VladimirGaristov/ROBKO_01-STM32/Documents/ROBKO-01_Thesis/documents/cover.pdf

Технологично Училище "Електронни Системи" към Технически Университет - София

Управление на български робот РОБКО 01 с ARM-базиран
микроконтролер STM32L476RG и отдалечен достъп през интернет

Владимир Гаристов
