VladimirGaristov/ROBKO_01-STM32/Documents/ROBKO-01_Thesis/documents/title_page.pdf

ТЕХНОЛОГИЧНО УЧИЛИЩЕ ЕЛЕКТРОННИ СИСТЕМИ към ТЕХНИЧЕСКИ УНИВЕРСИТЕТ - СОФИЯ

## Д И П Л О М Н А Р А Б О Т А

Тема: Управление на български робот РОБКО 01 с ARM-базиран микроконтролер STM32L476RG и отдалечен достъп през интернет

Дипломант: | Научен ръководител:
Владимир Гаристов | маг. инж. Росен Витанов

С О Ф И Я

2 0 1 8
