VladimirGaristov/ROBKO_01-STM32/Hardware/Documents/Connectors/Screw Terminals.pdf

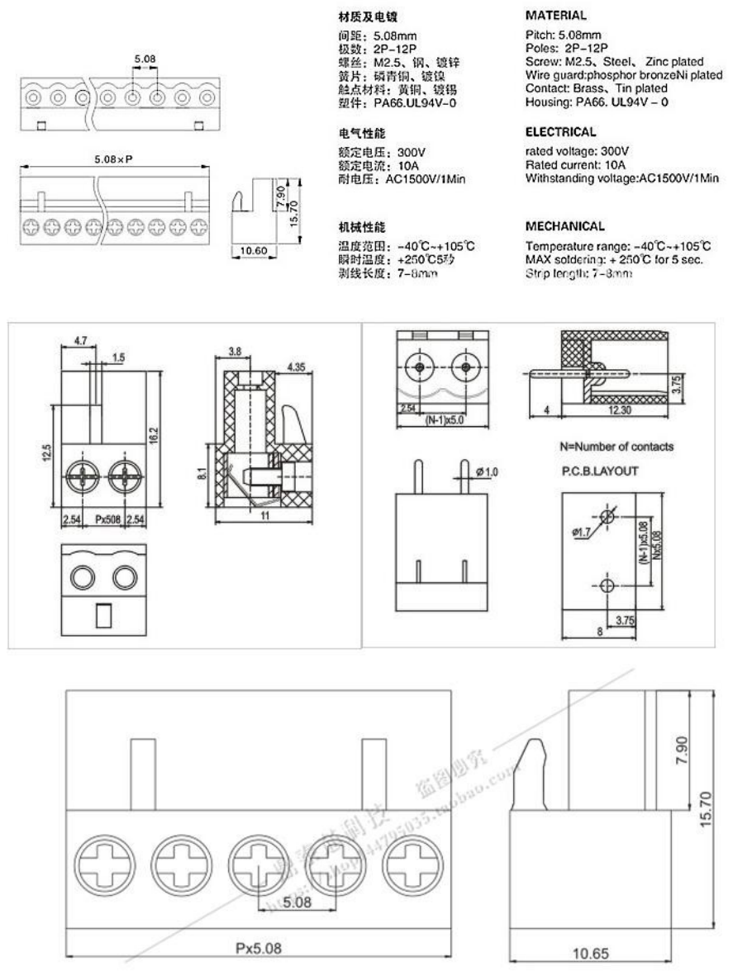
[picture p33: page 1]
