VladimirGaristov/ROBKO_01-STM32/Documents/ROBKO-01_Thesis/pictures/sandwich.jpg

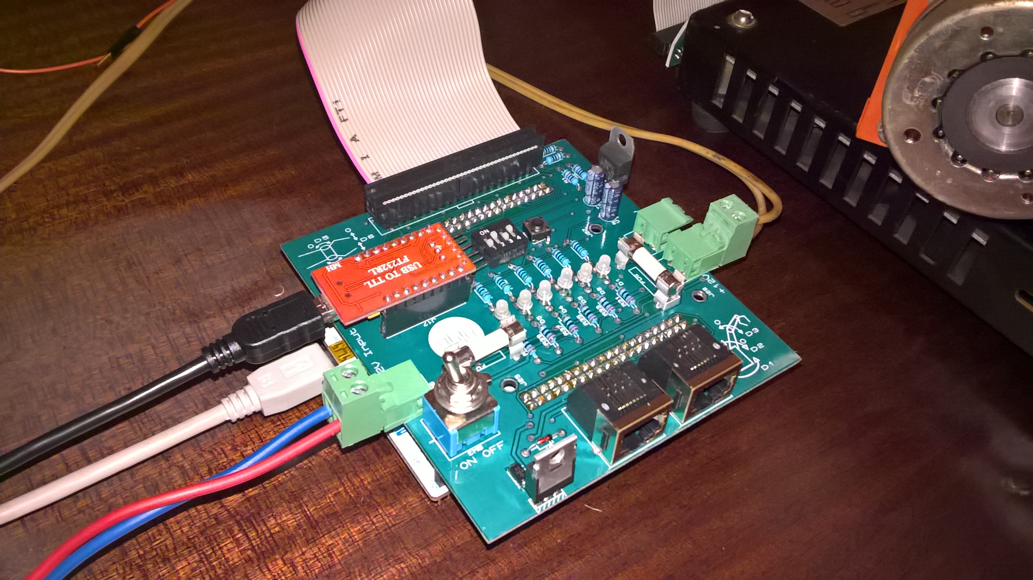
Documents/ROBKO-01_Thesis/pictures/sandwich.jpg
