VladimirGaristov/ROBKO_01-STM32/Hardware/Documents/Apple II schematic.jpg

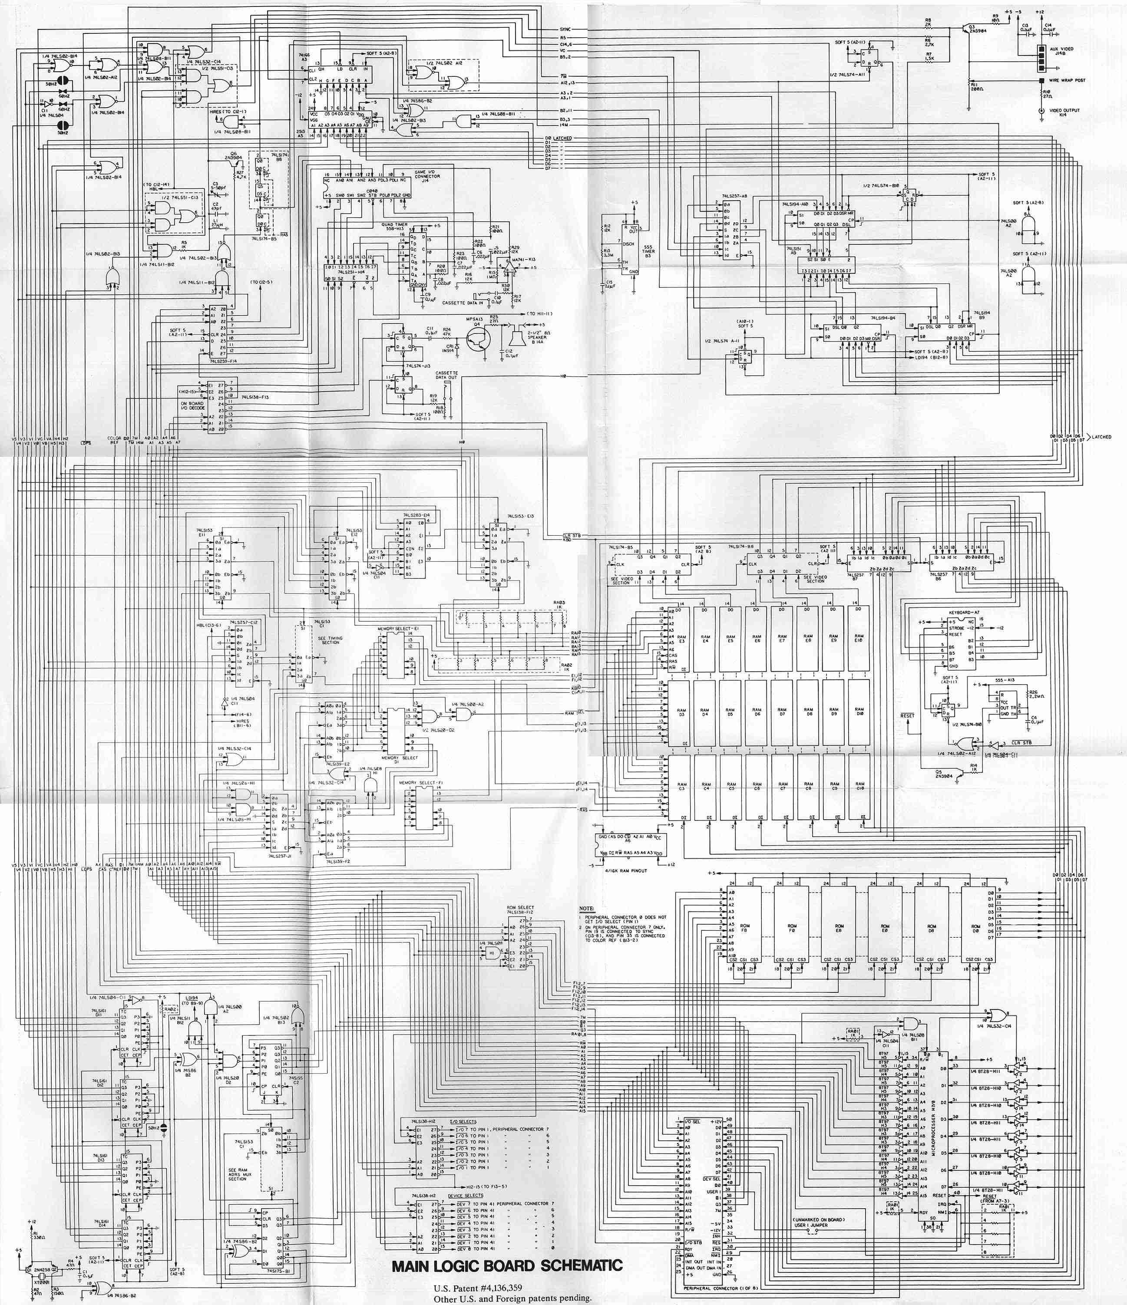
Hardware/Documents/Apple II schematic.jpg
