VladimirGaristov/ROBKO_01-STM32/Hardware/Silkscreen_legend-claw.bmp

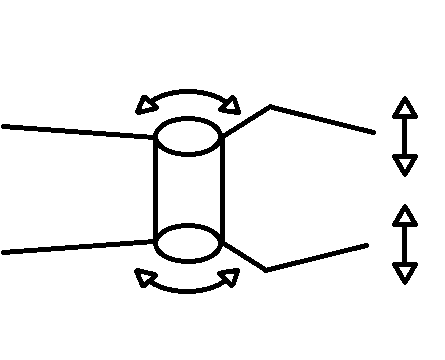
Hardware/Silkscreen_legend-claw.bmp
