VladimirGaristov/ROBKO_01-STM32/Hardware/Silkscreen_legend.bmp

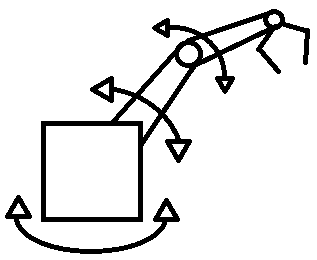
Hardware/Silkscreen_legend.bmp
