VladimirGaristov/ROBKO_01-STM32/Documents/ROBKO-01_Thesis/TODO.txt

-Оправи датите на линковете
-по-готина заглавна страница
-добави скоростите на въртене
-провери дали джойстиците са разменени
-идиотоустойчивост
