VladimirGaristov/ROBKO_01-STM32/(threads)

Thread 2 (2018-01-27):

Добави конф на моторите в check_mode()

Vladomaimun, 2018-01-27:
От sharelatex.com:

Чрез третият прекъсвач се избира дали стъпковите мотори да се задвижват в режим на пълна стъпка (отворен) или на полустъпка (затворен). Последният прекъсвач конфигурира скоростта на въртене на моторите. Когато е отворен е избрана бавна скорост, а когато е затворен - бърза.

Vladomaimun, 2018-02-11:
Готово

Closed 2018-02-11.
