VladimirGaristov/ROBKO_01-STM32/Hardware/Graphic output/schematic_bw.pdf

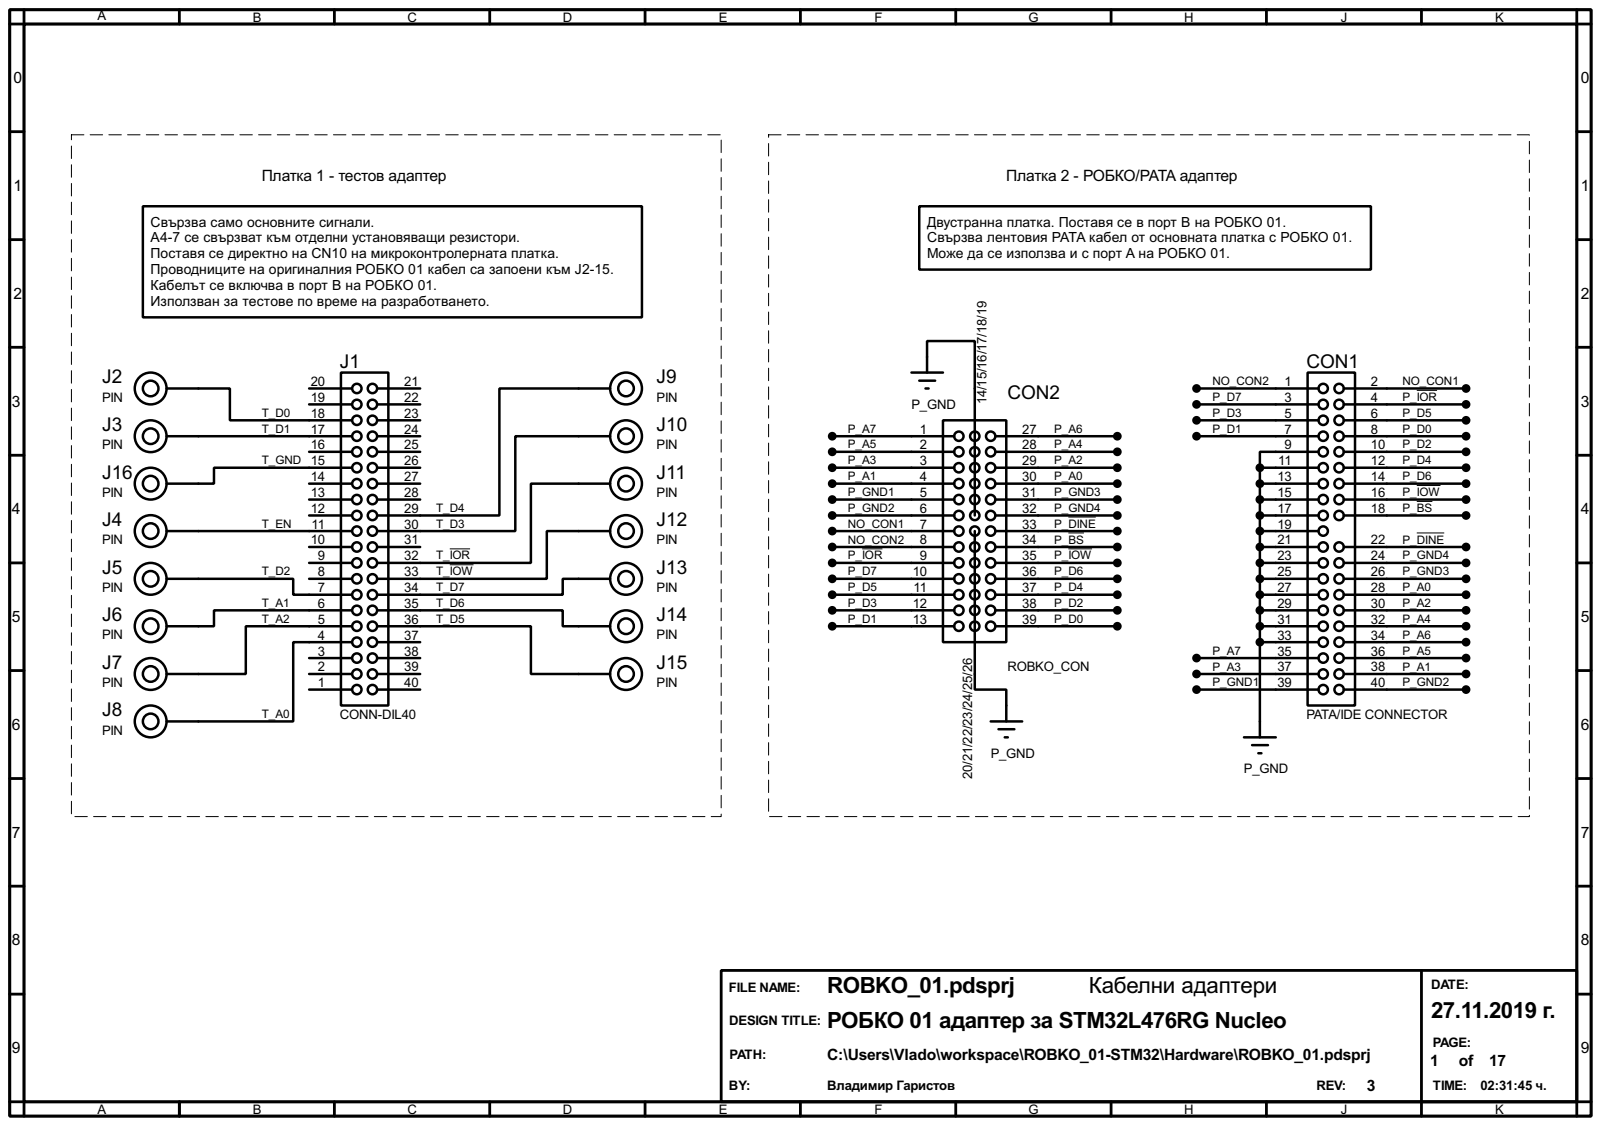
[picture p56: page 1]

Платка 2 - РОБКО/PATA адаптер

Свързва само основните сигнали. A4-7 се свързват към отделни установяващи резистори. Поставя се директно на CN10 на микроконтролерната платка. Проводниците на оригиналния РОБКО 01 кабел са запоени към J2-15. Кабелът се включва в порт B на РОБКО 01. Използван за тестове по време на разработването.

Двустранна платка. Поставя се в порт B на РОБКО 01. Свързва лентовия PATA кабел от основната платка с РОБКО 01. Може да се използва и с порт A на РОБКО 01.

FILE NAME:
DESIGN TITLE: РОБКО 01 адаптер за STM32L476RG Nucleo

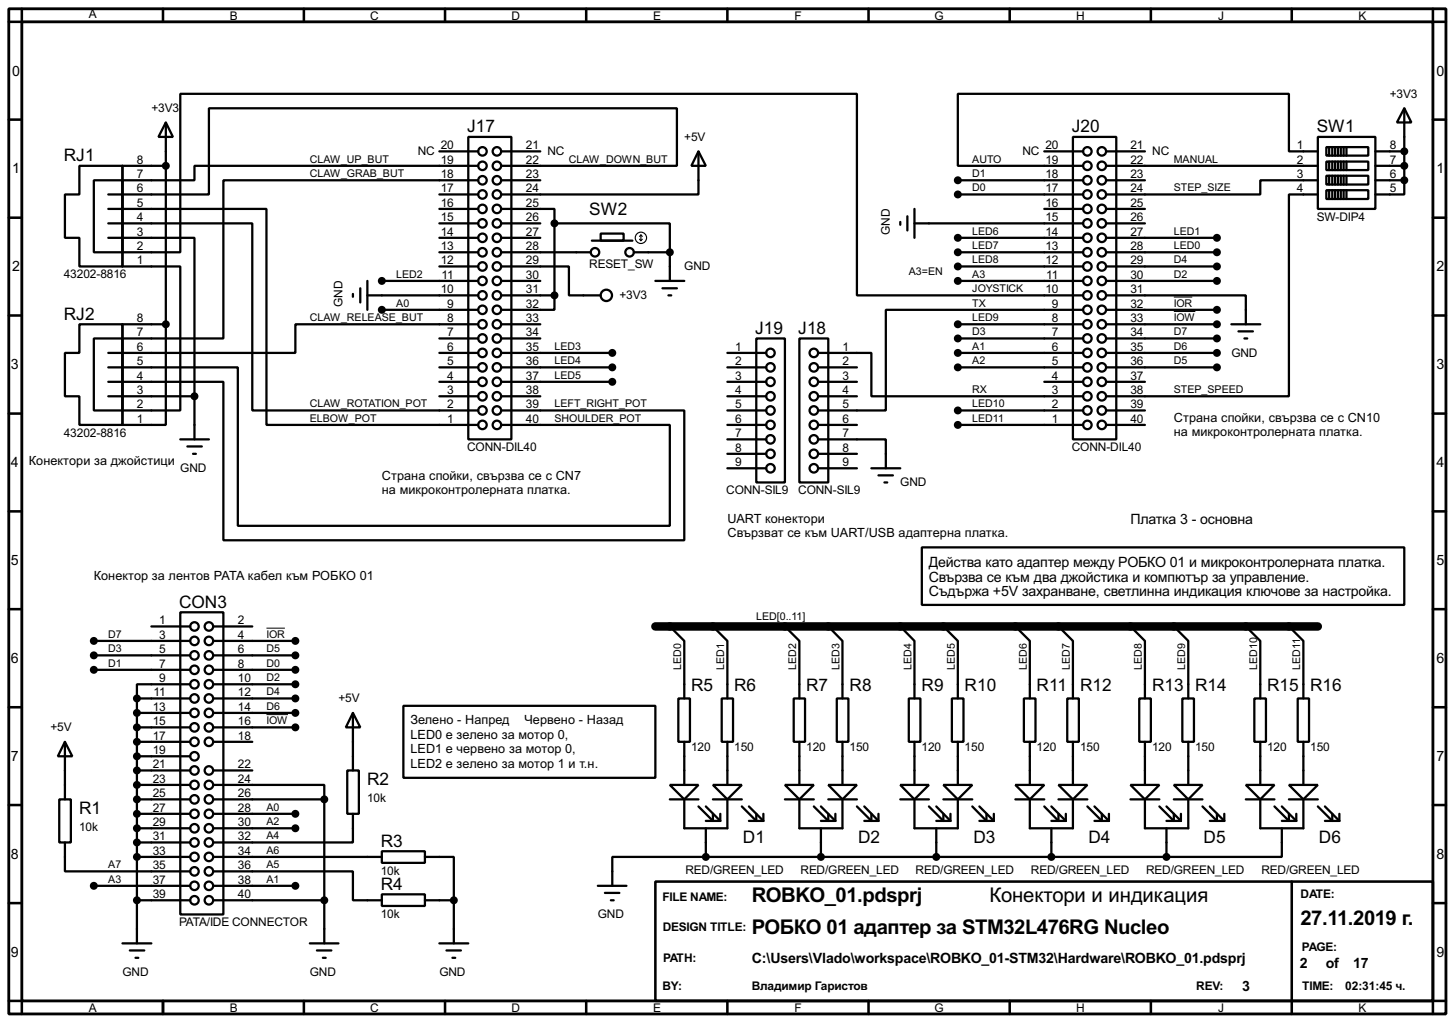
[picture p57: page 2]

5 | LED10 | 2

Страна спойки, свързва се с CN10
на микроконтролерната платка.

Страна спойки, свързва се с CN7

UART конектори Свързват се към UART/USB адаптерна платка.

Платка 3 - основна Действа като адаптер между РОБКО 01 и микроконтролерната платка. Свързва се към два джойстика и компютър за управление. Съдържа +5V захранване, светлинна индикация ключове за настройка.

Конектор за лентов PATA кабел към РОБКО 01

LED0 е зелено за мотор 0, LED1 е червено за мотор 0, LED2 е зелено за мотор 1 и т.н.

23 | 24
25 | 26
27 | 28 A2A0 30

31 | 32
33 | A4A6A5 34

FILE NAME:
DESIGN TITLE: РОБКО 01 адаптер за STM32L476RG Nucleo

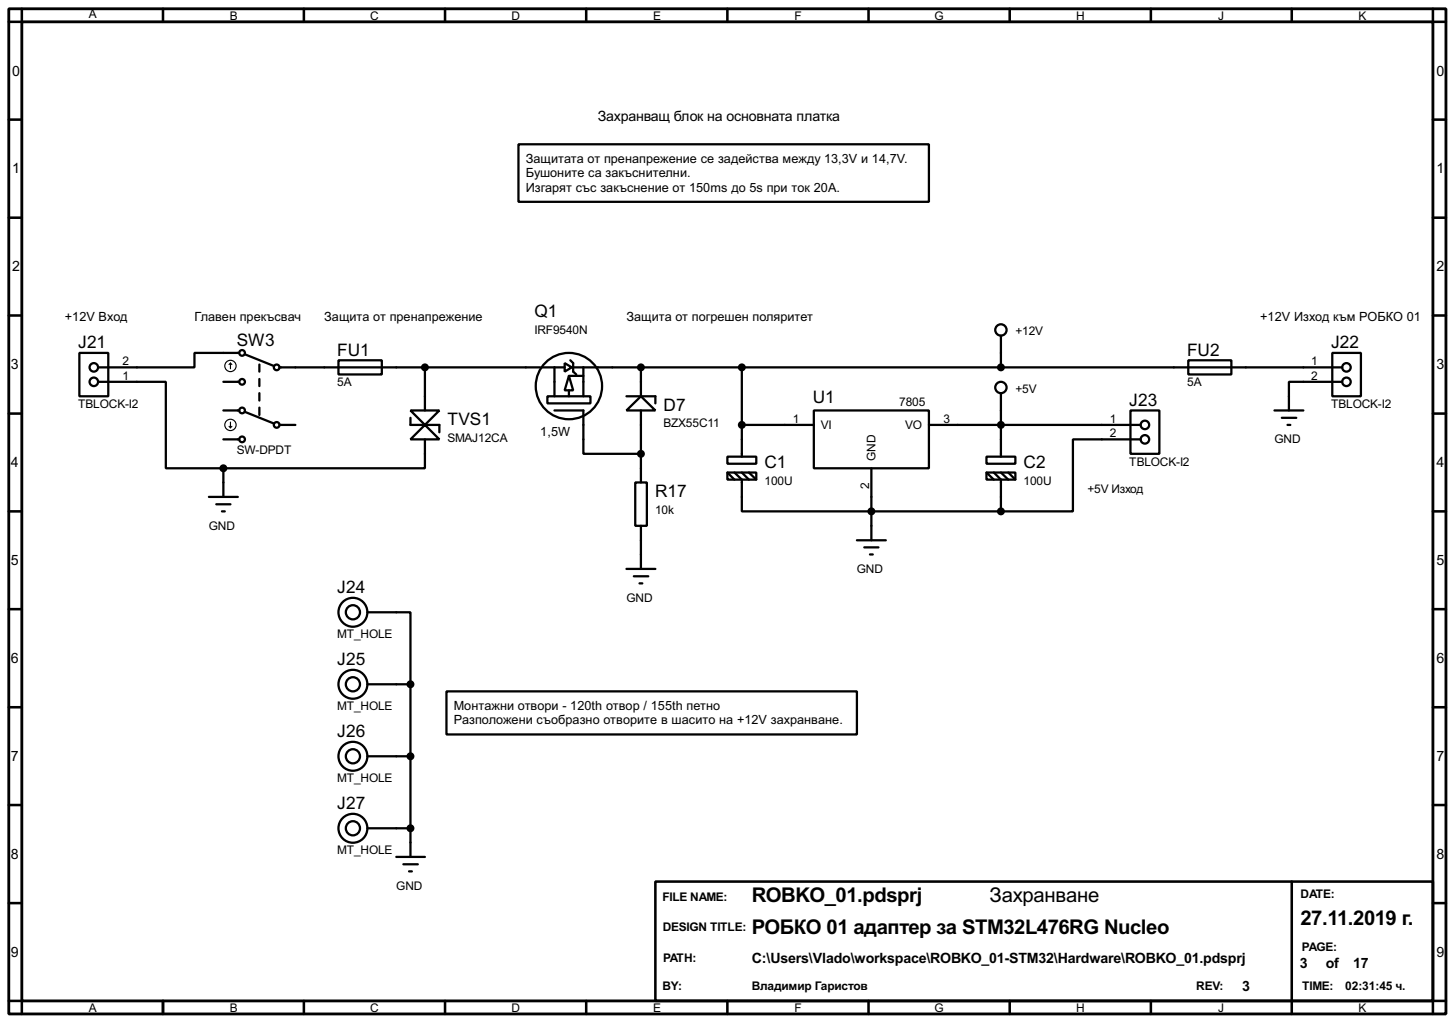
[picture p58: page 3]

Захранващ блок на основната платка

Защитата от пренапрежение се задейства между 13,3V и 14,7V. Бушоните са закъснителни. Изгарят със закъснение от 150ms до 5s при ток 20A.

Монтажни отвори - 120th отвор / 155th петно Разположени съобразно отворите в шасито на +12V захранване.

FILE NAME:
DESIGN TITLE: РОБКО 01 адаптер за STM32L476RG Nucleo

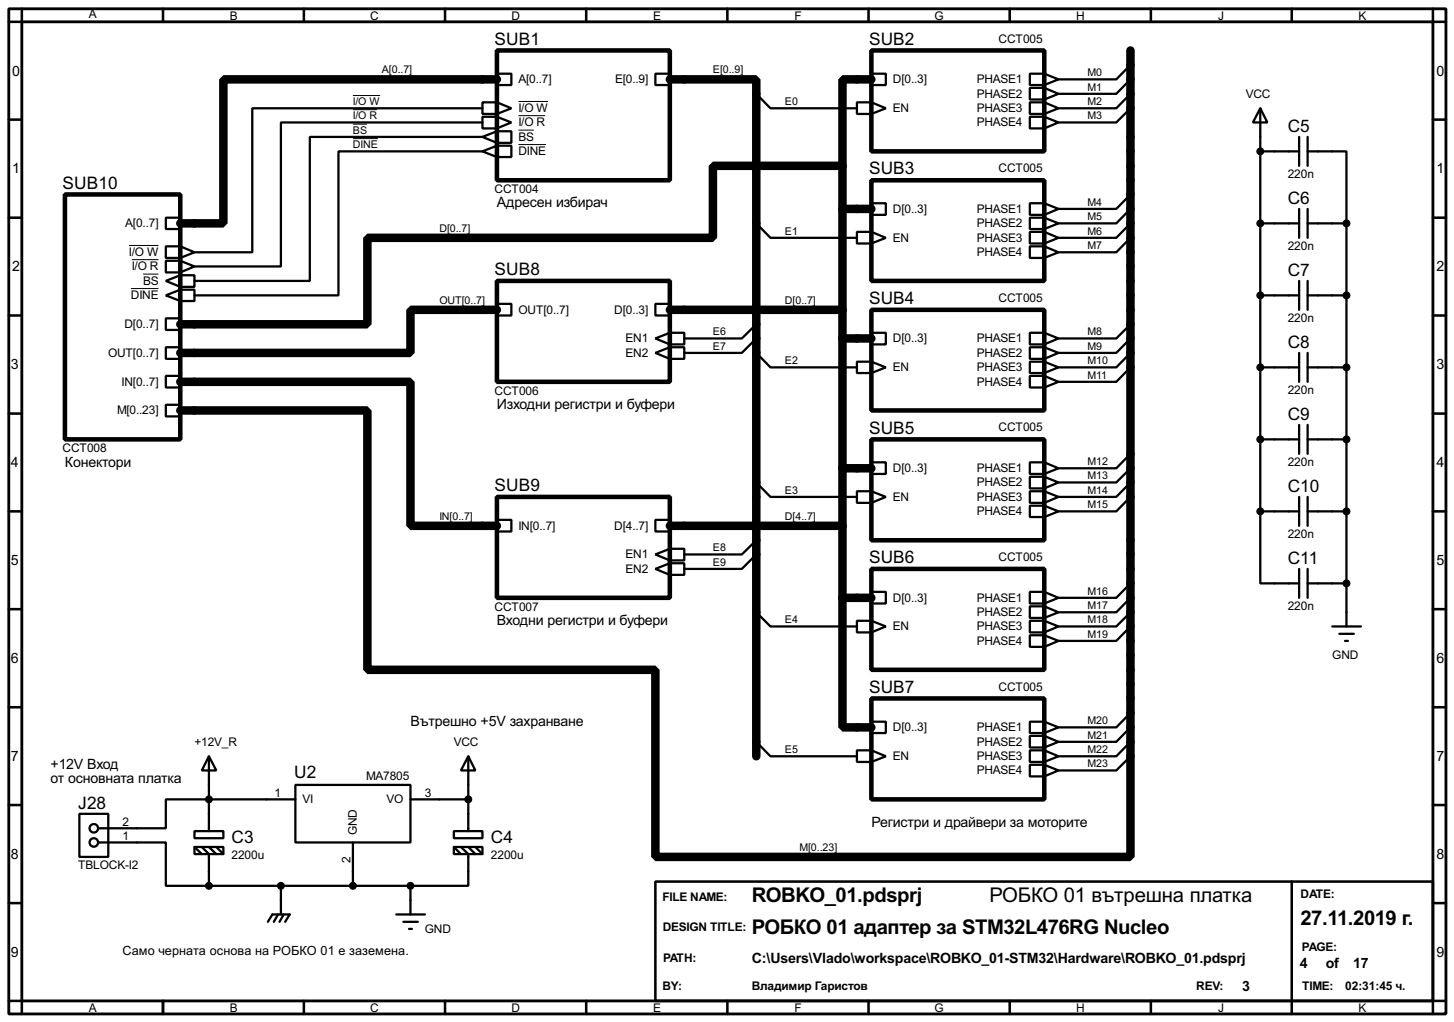
[picture p59: page 4]

Регистри и драйвери за моторите

FILE NAME:
DESIGN TITLE: РОБКО 01 адаптер за STM32L476RG Nucleo

Само черната основа на РОБКО 01 е заземена.

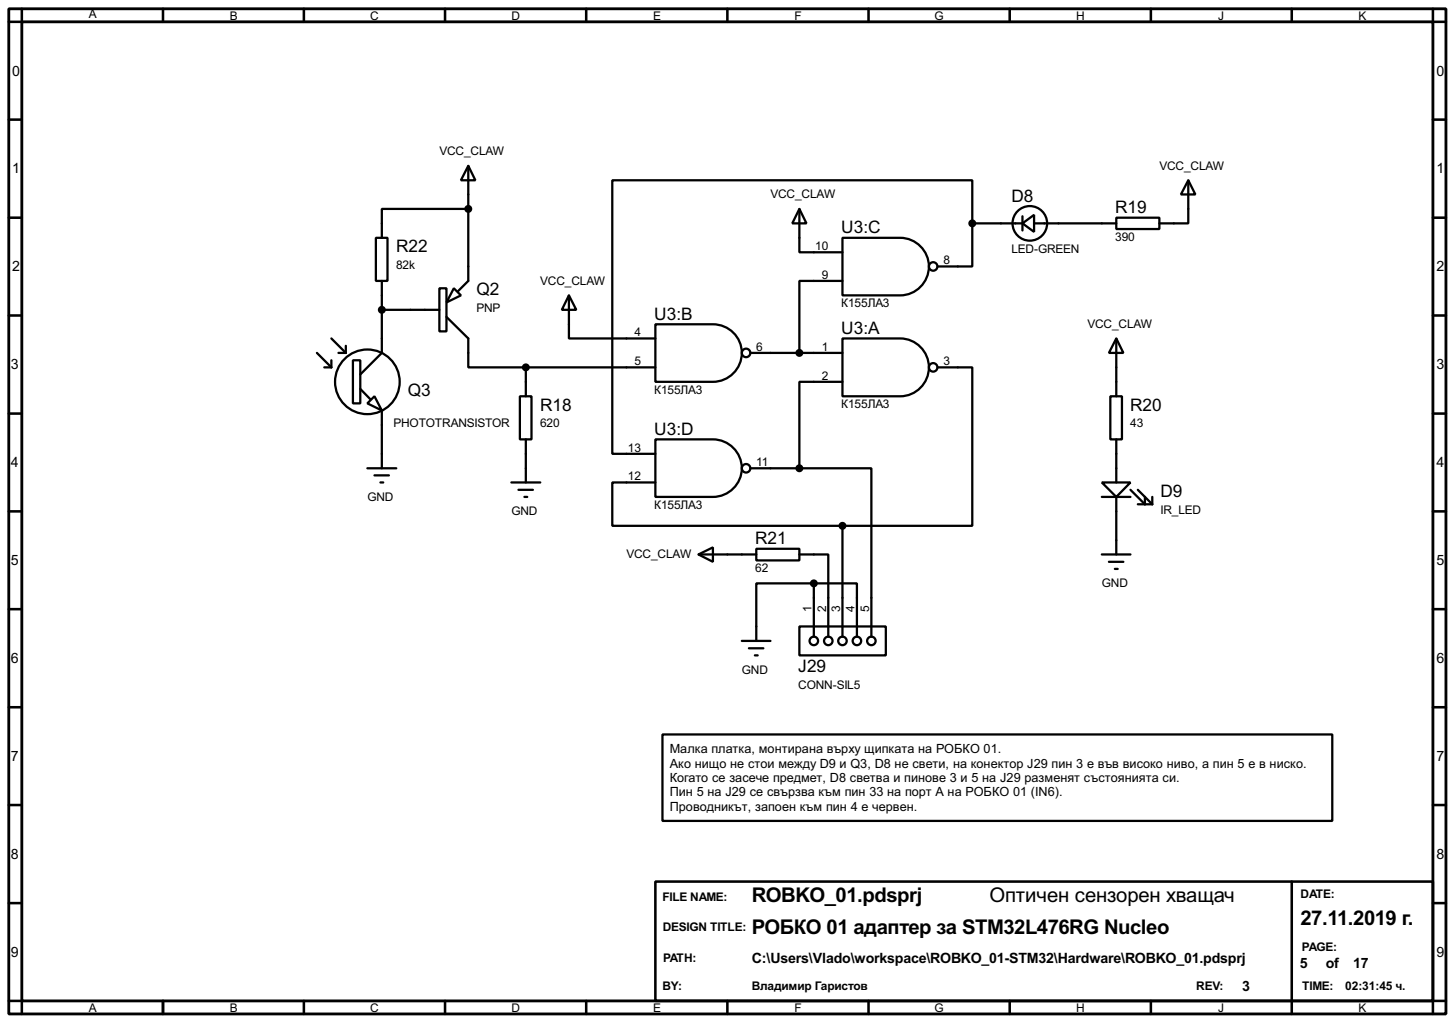
[picture p60: page 5]

Малка платка, монтирана върху щипката на РОБКО 01. Когато се засече предмет, D8 светва и пинове 3 и 5 на J29 разменят състоянията си. Ако нищо не стои между D9 и Q3, D8 не свети, на конектор J29 пин 3 е във високо ниво, а пин 5 е в ниско.

Проводникът, запоен към пин 4 е червен. Пин 5 на J29 се свързва към пин 33 на порт А на РОБКО 01 (IN6).

FILE NAME:
DESIGN TITLE: РОБКО 01 адаптер за STM32L476RG Nucleo

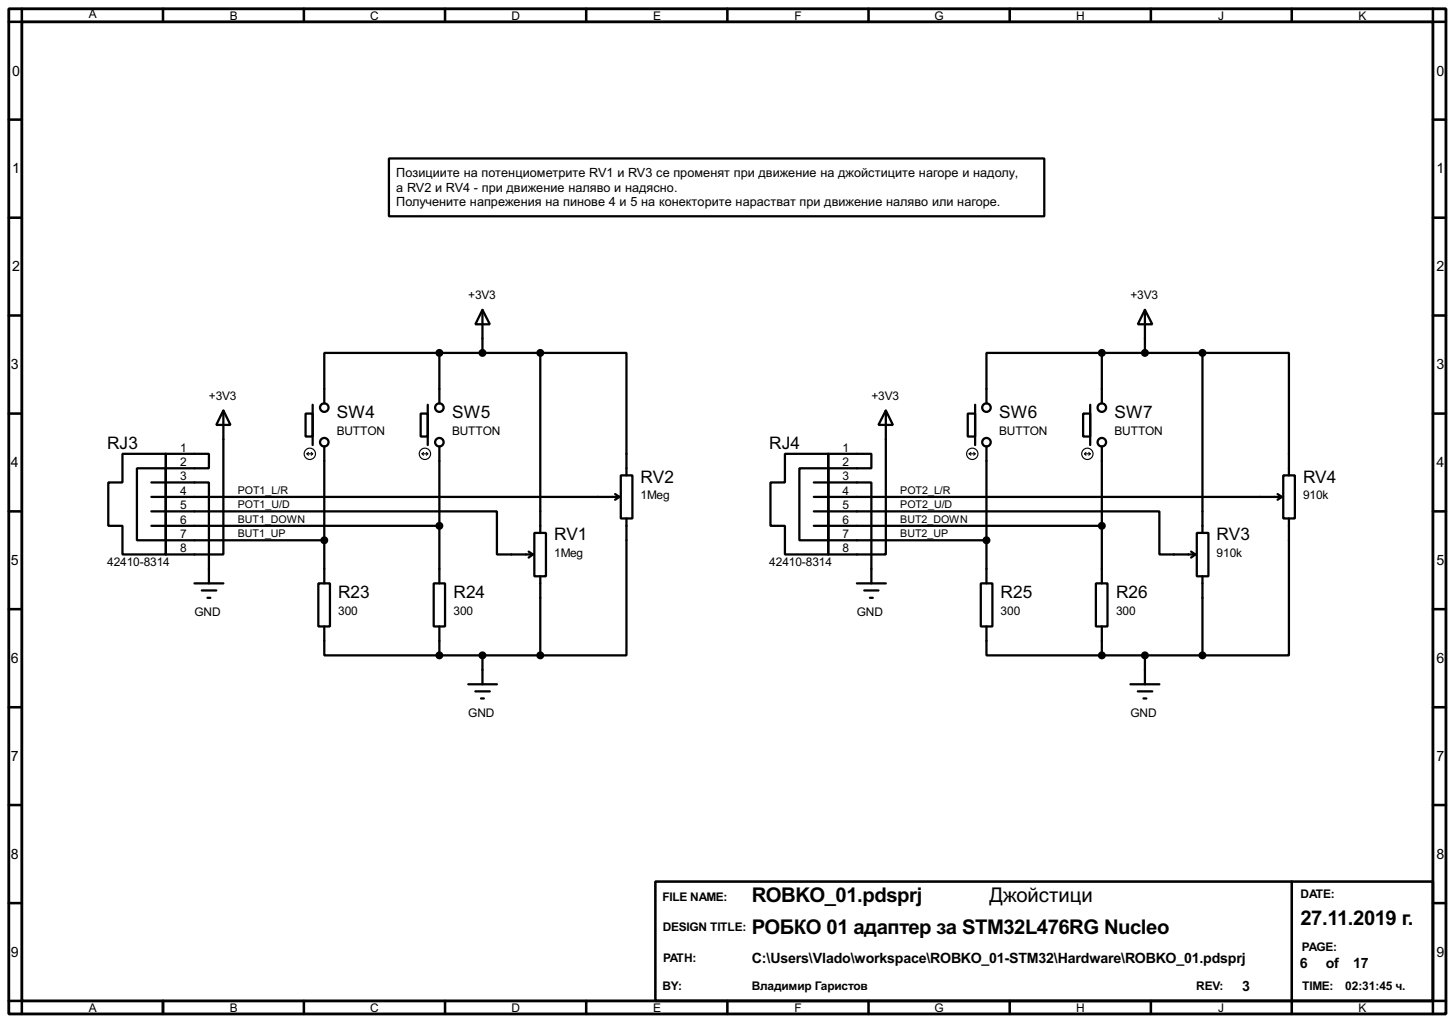
[picture p61: page 6]

а RV2 и RV4 - при движение наляво и надясно. Позициите на потенциометрите RV1 и RV3 се променят при движение на джойстиците нагоре и надолу,

Получените напрежения на пинове 4 и 5 на конекторите нарастват при движение наляво или нагоре.

FILE NAME:
DESIGN TITLE: РОБКО 01 адаптер за STM32L476RG Nucleo

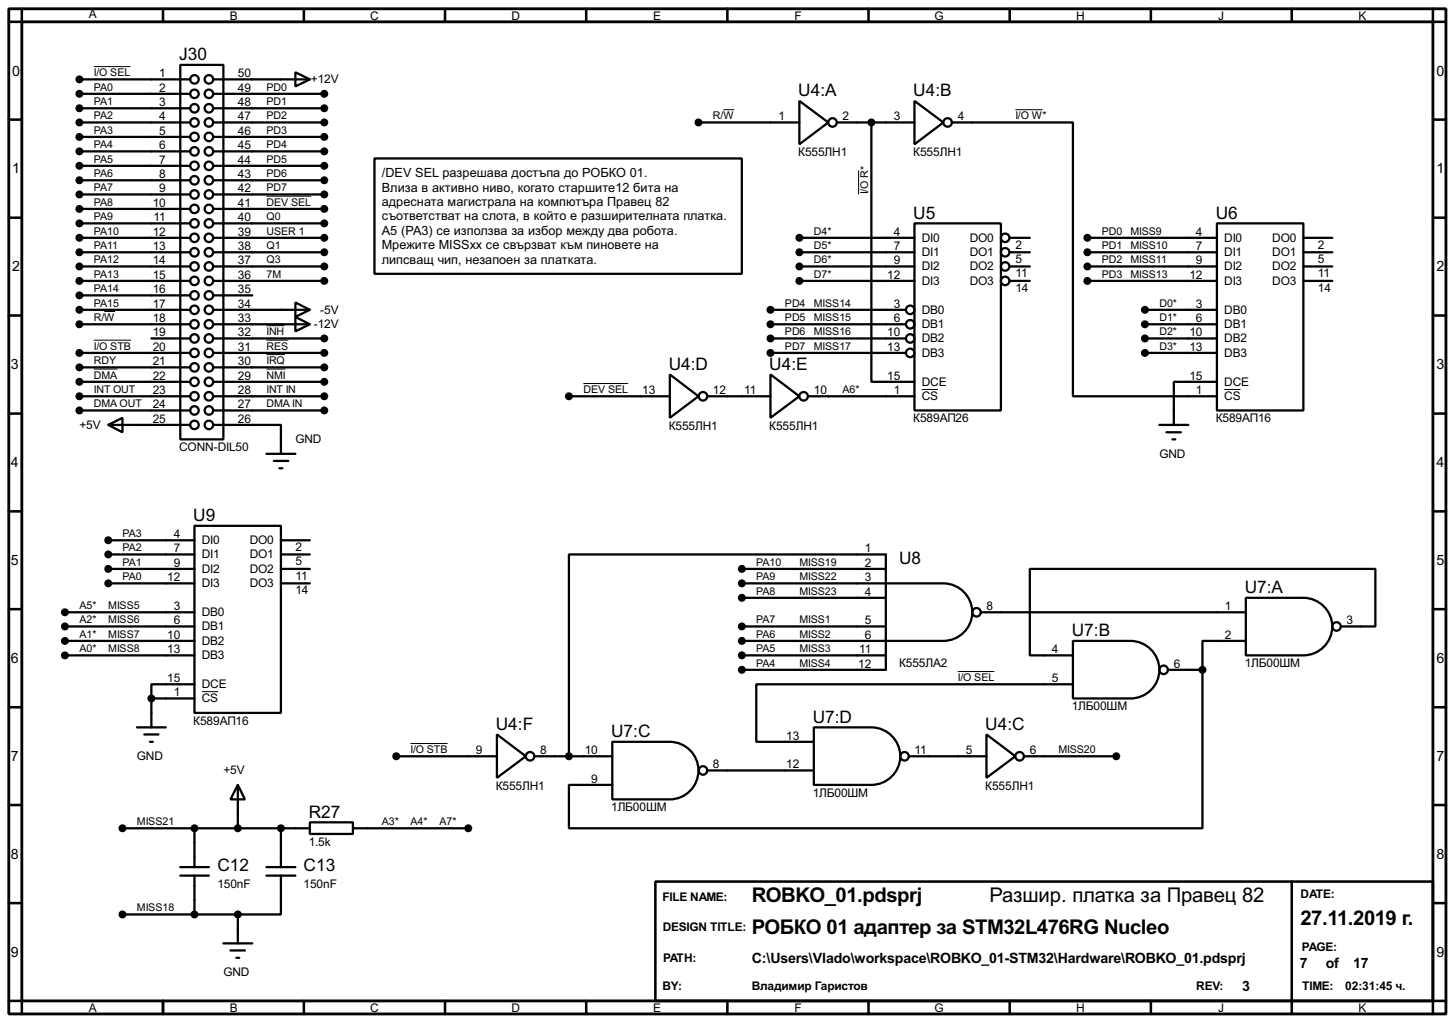
[picture p62: page 7]

/DEV SEL разрешава достъпа до РОБКО 01. Влиза в активно ниво, когато старшите12 бита на

адресната магистрала на компютъра Правец 82
съответстват на слота, в който е разширителната платка. A5 (PA3) се използва за избор между два робота. Мрежите MISSxx се свързват към пиновете на липсващ чип, незапоен за платката.

INT OUT DMA OUT

FILE NAME:
DESIGN TITLE: РОБКО 01 адаптер за STM32L476RG Nucleo

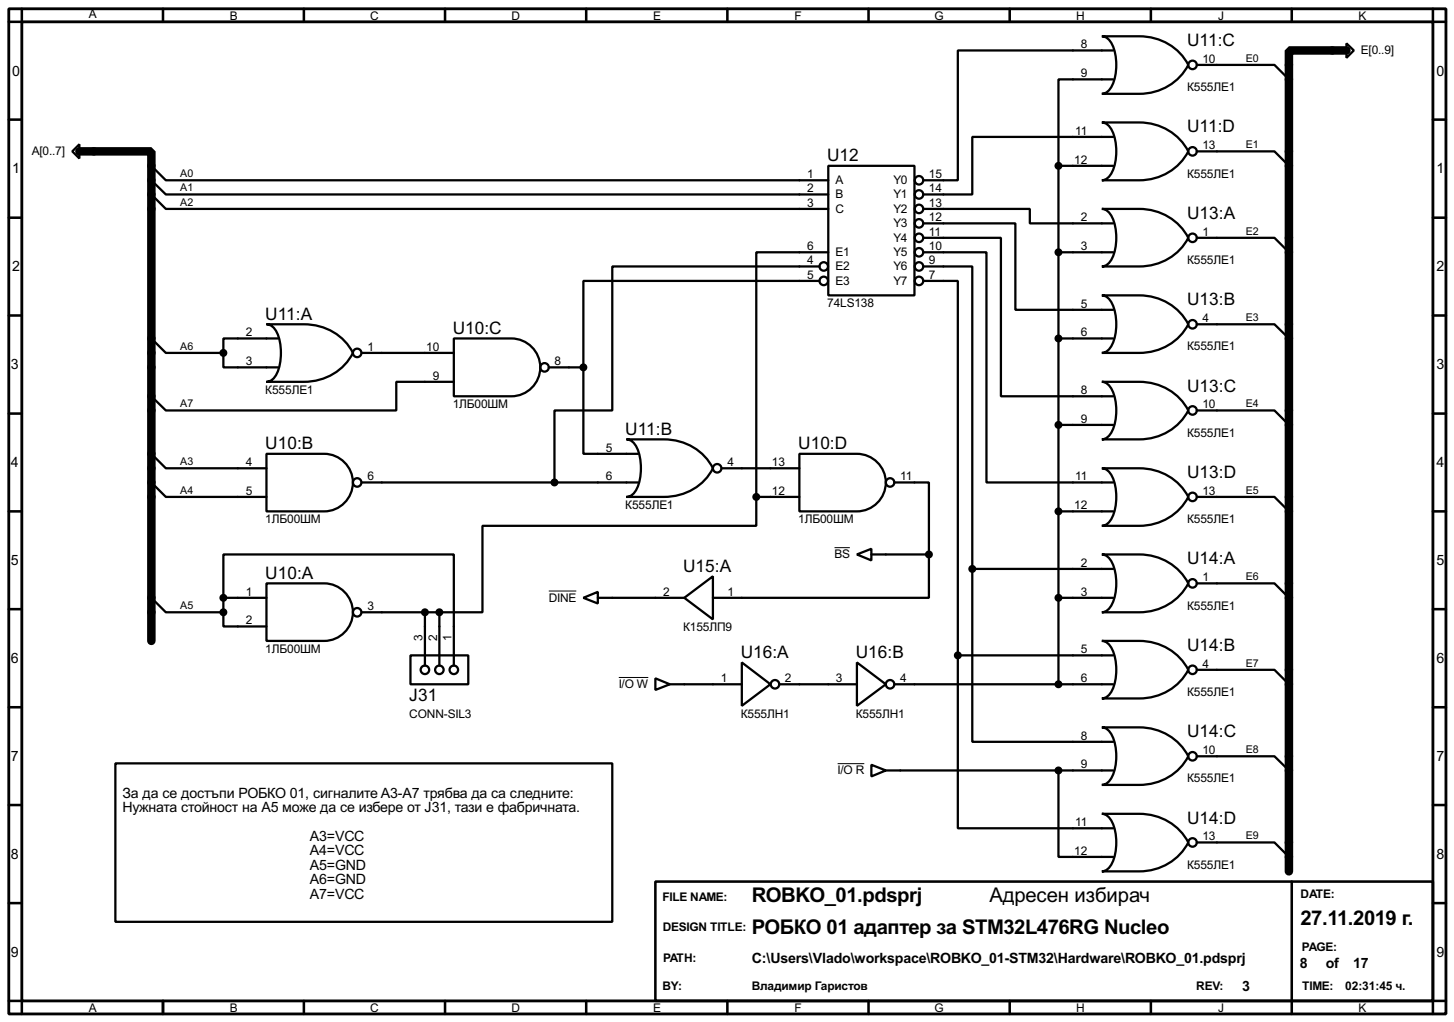
[picture p63: page 8]

За да се достъпи РОБКО 01, сигналите A3-A7 трябва да са следните: A3=VCC
Нужната стойност на А5 може да се избере от J31, тази е фабричната.

FILE NAME:
DESIGN TITLE: РОБКО 01 адаптер за STM32L476RG Nucleo

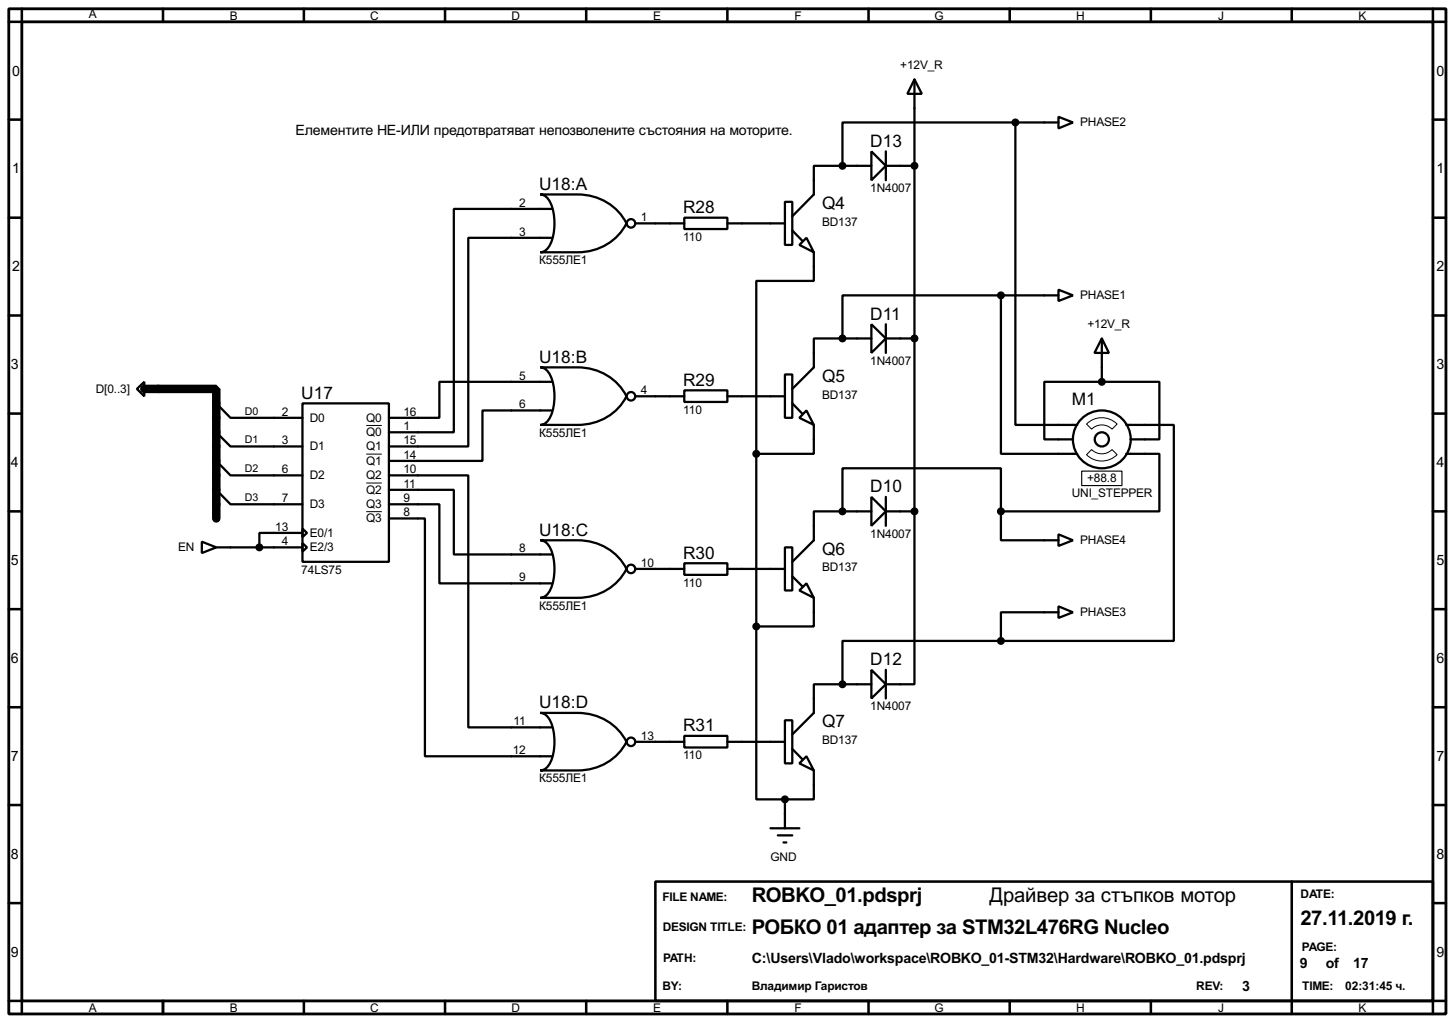
[picture p64: page 9]

Елементите НЕ-ИЛИ предотвратяват непозволените състояния на моторите.

FILE NAME:
DESIGN TITLE: РОБКО 01 адаптер за STM32L476RG Nucleo

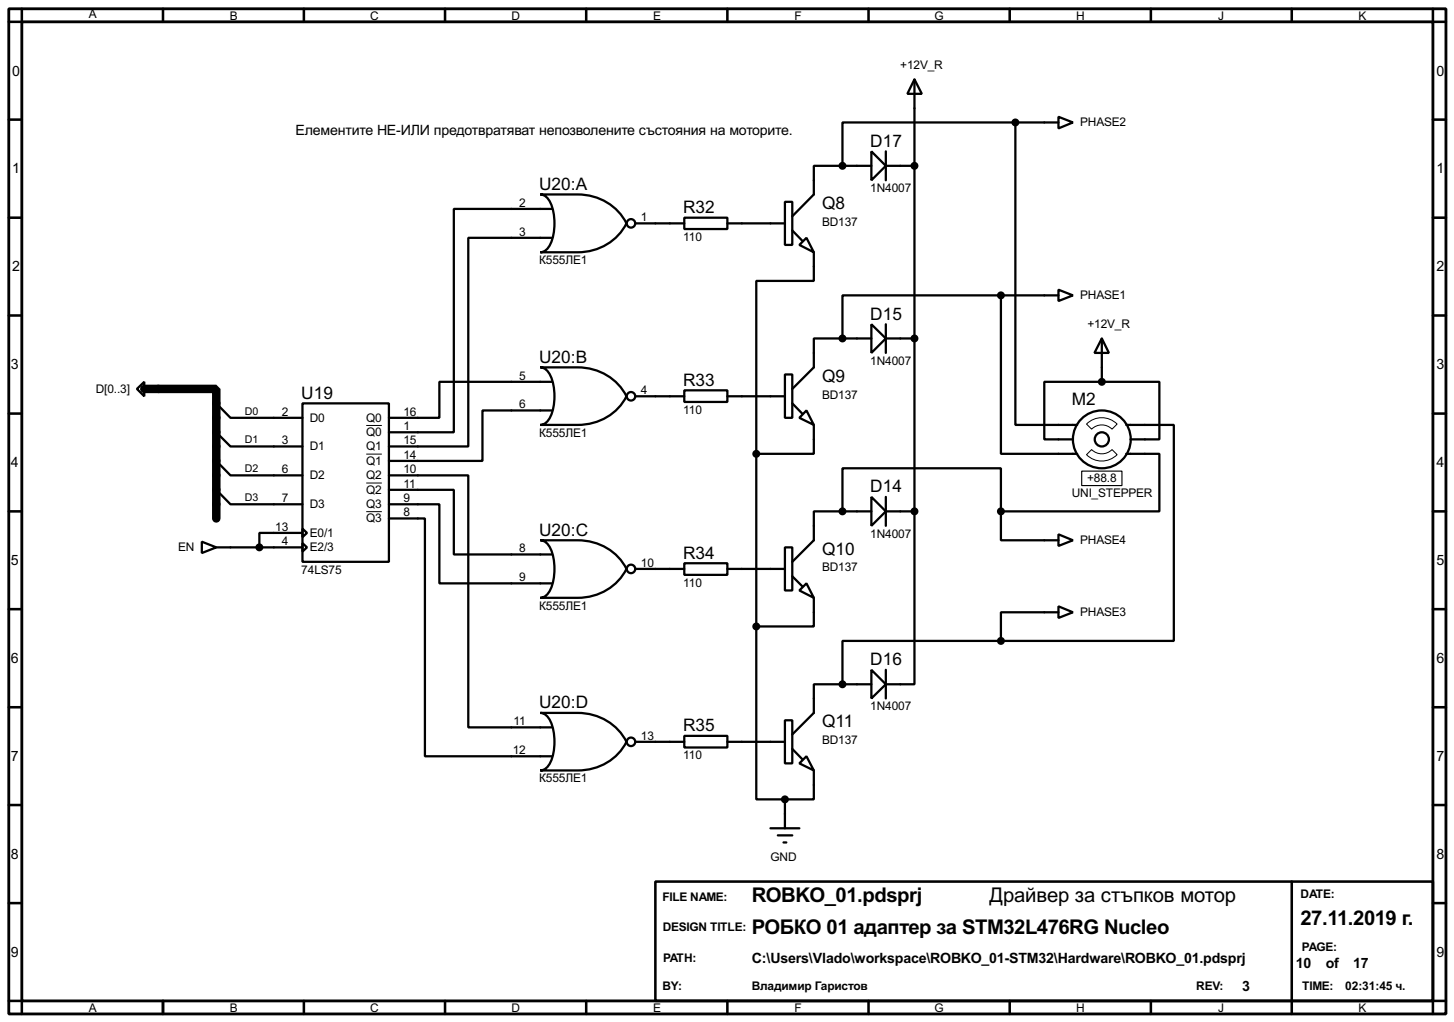
[picture p65: page 10]

Елементите НЕ-ИЛИ предотвратяват непозволените състояния на моторите.

FILE NAME:
DESIGN TITLE: РОБКО 01 адаптер за STM32L476RG Nucleo

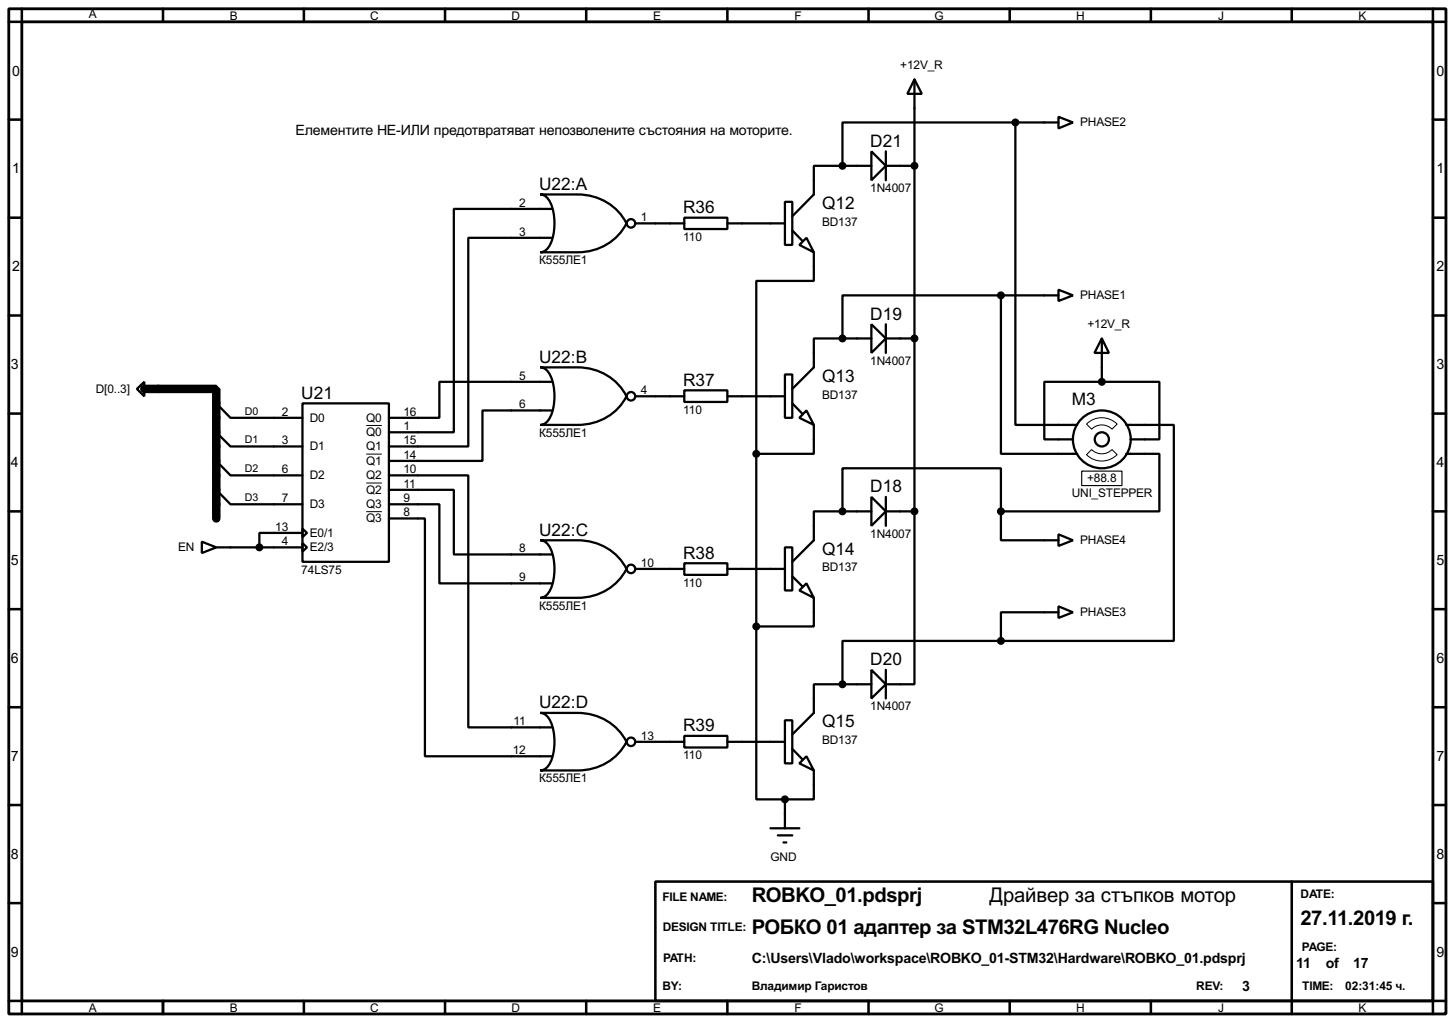
[picture p66: page 11]

Елементите НЕ-ИЛИ предотвратяват непозволените състояния на моторите.

FILE NAME:
DESIGN TITLE: РОБКО 01 адаптер за STM32L476RG Nucleo

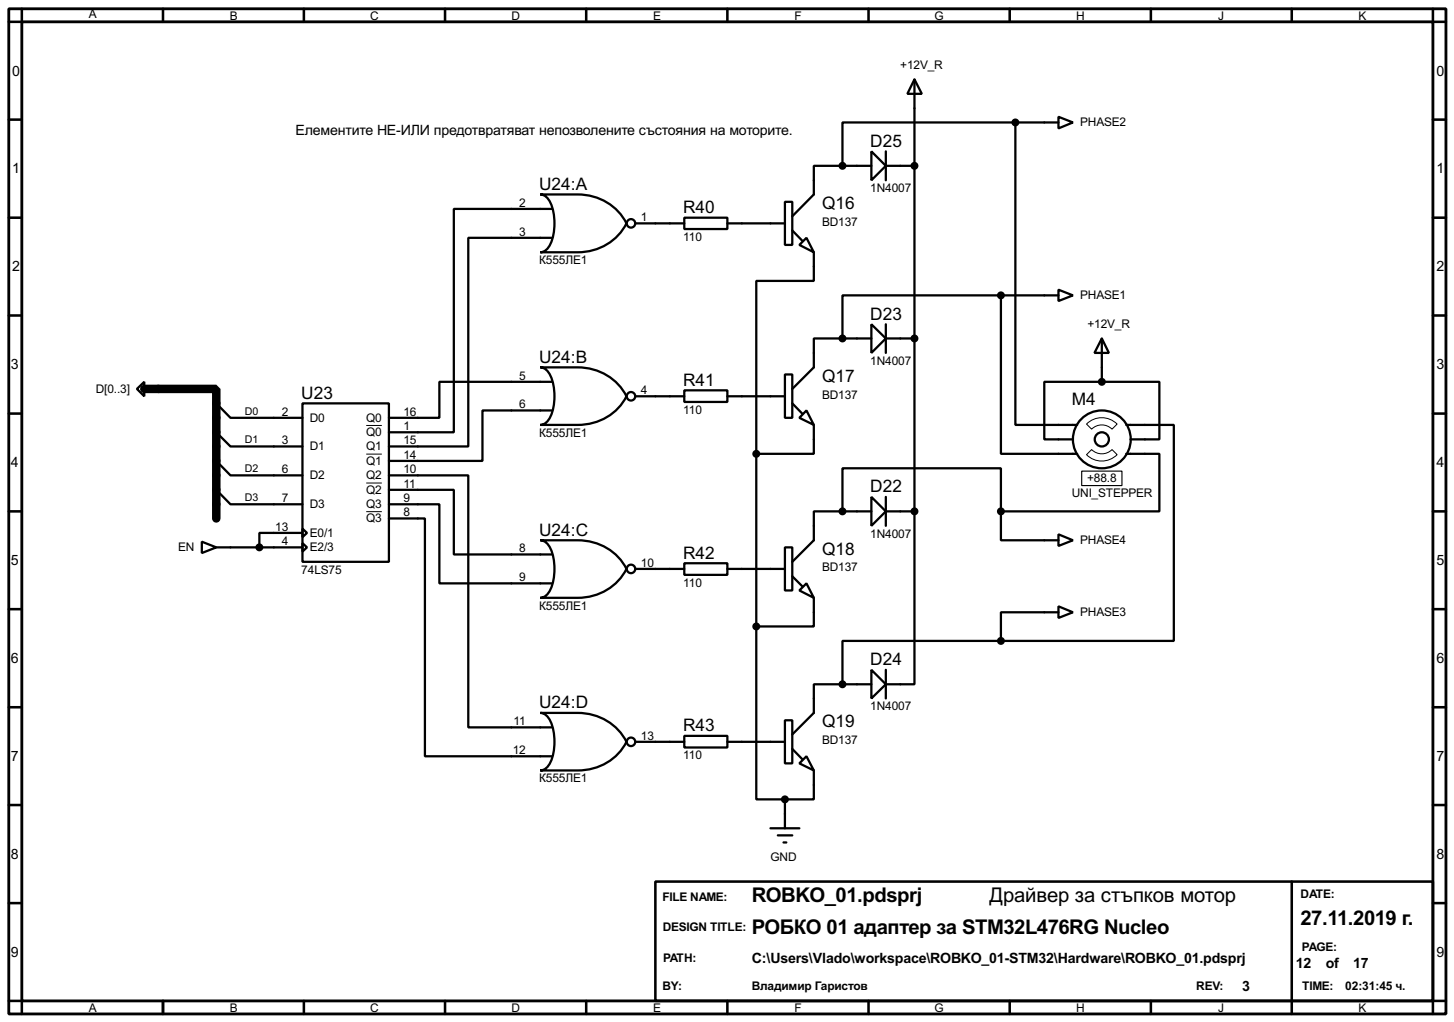
[picture p67: page 12]

Елементите НЕ-ИЛИ предотвратяват непозволените състояния на моторите.

FILE NAME:
DESIGN TITLE: РОБКО 01 адаптер за STM32L476RG Nucleo

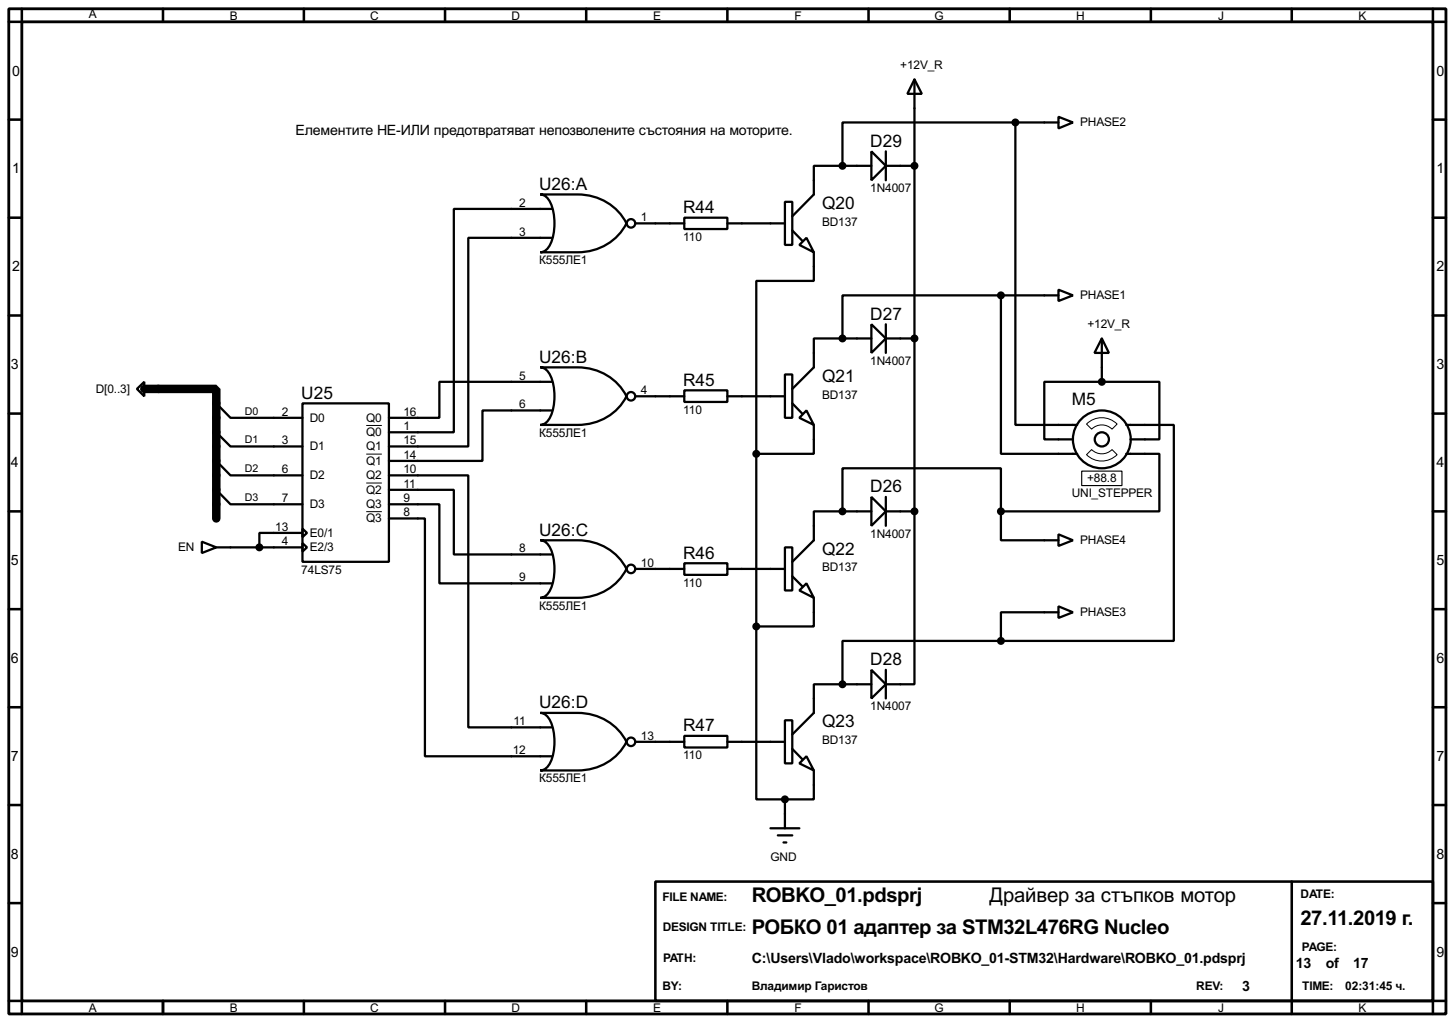
[picture p68: page 13]

Елементите НЕ-ИЛИ предотвратяват непозволените състояния на моторите.

FILE NAME:
DESIGN TITLE: РОБКО 01 адаптер за STM32L476RG Nucleo

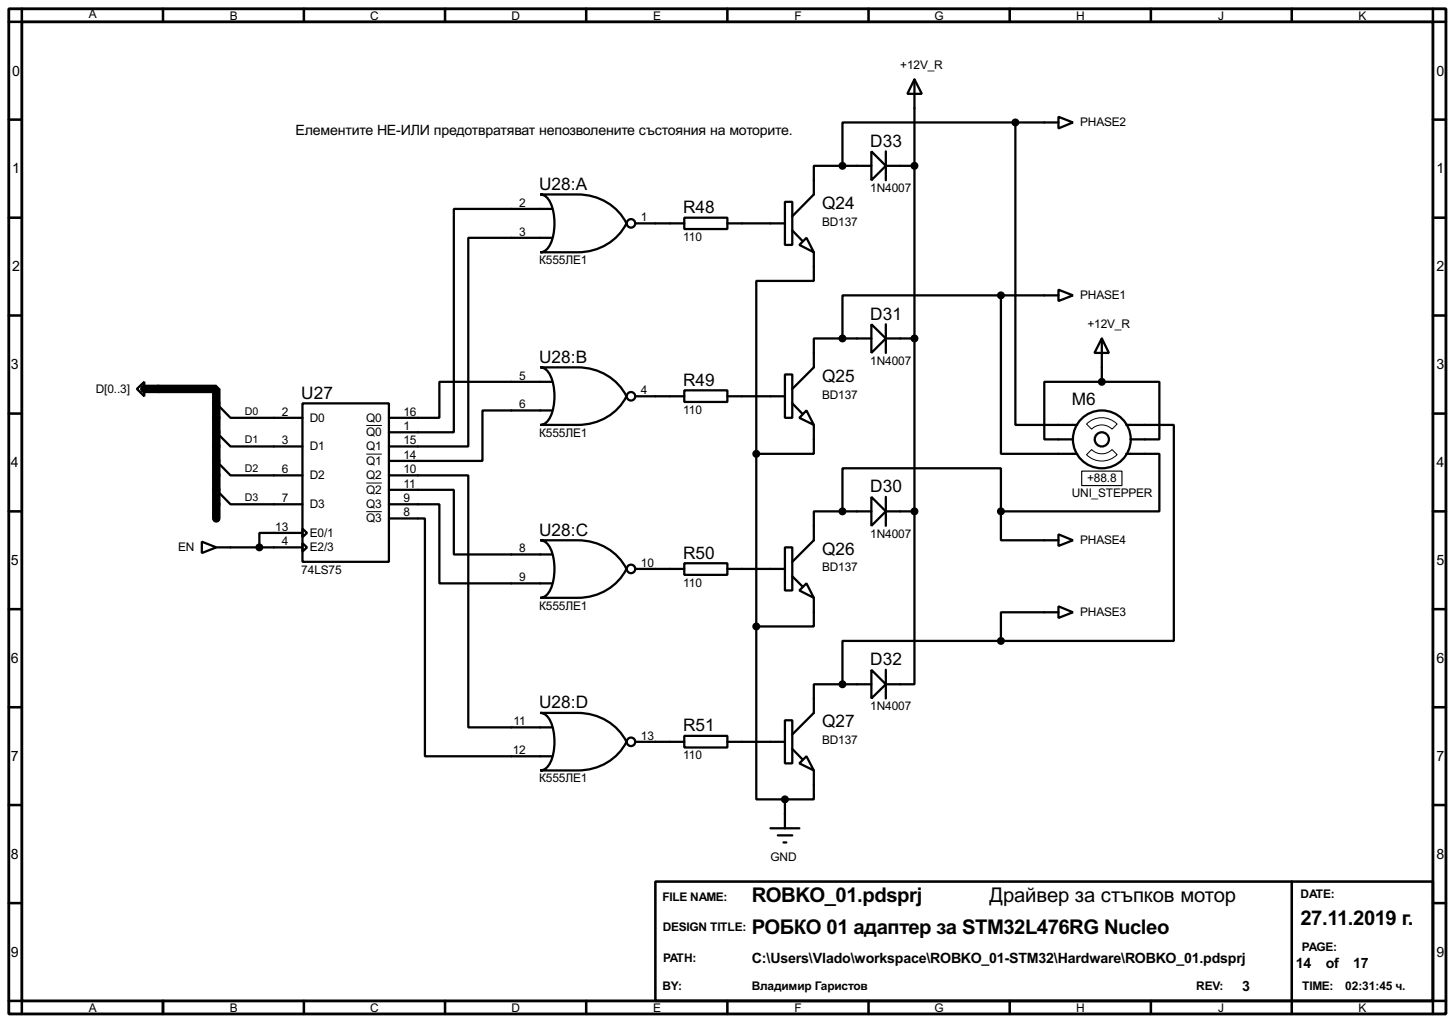
[picture p69: page 14]

Елементите НЕ-ИЛИ предотвратяват непозволените състояния на моторите.

FILE NAME:
DESIGN TITLE: РОБКО 01 адаптер за STM32L476RG Nucleo

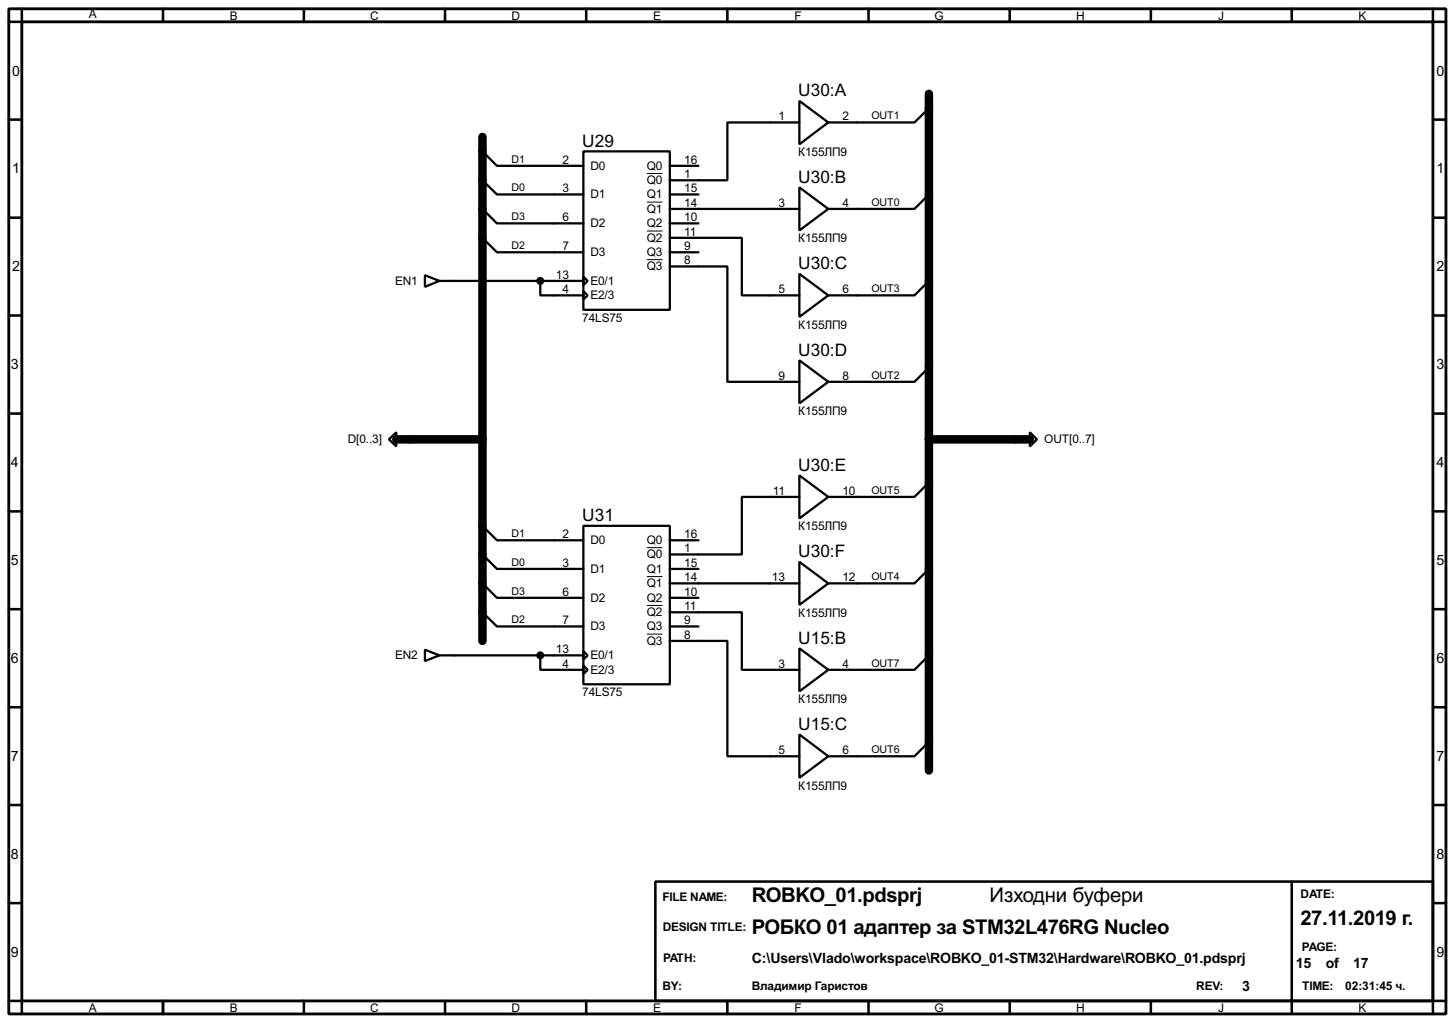
[picture p70: page 15]

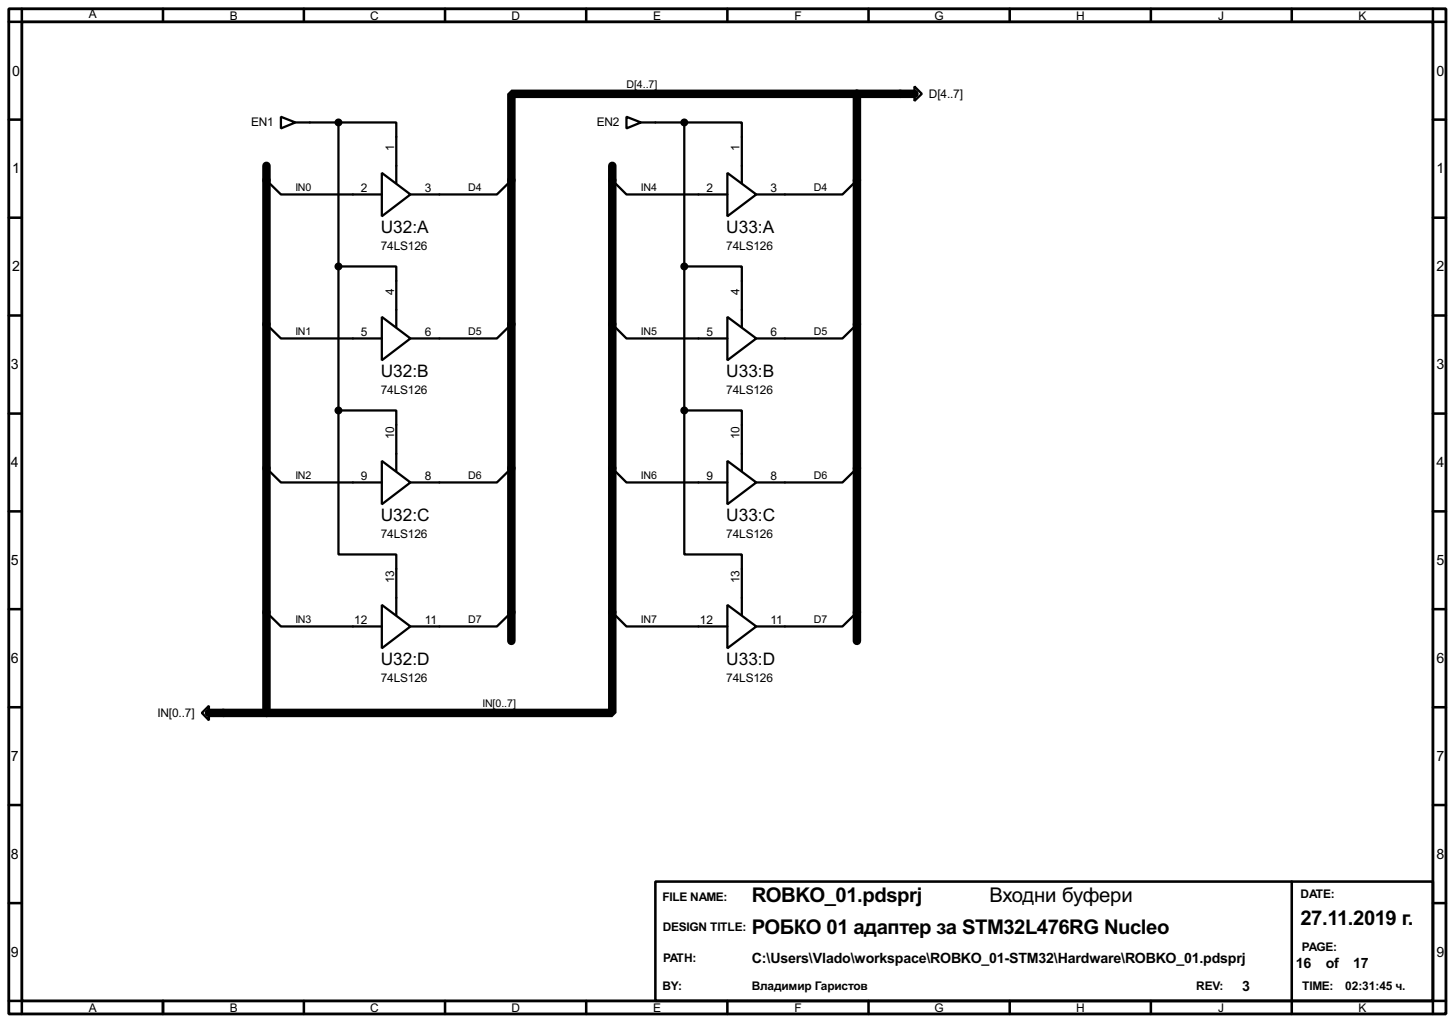
[picture p71: page 16]

FILE NAME:
DESIGN TITLE: РОБКО 01 адаптер за STM32L476RG Nucleo

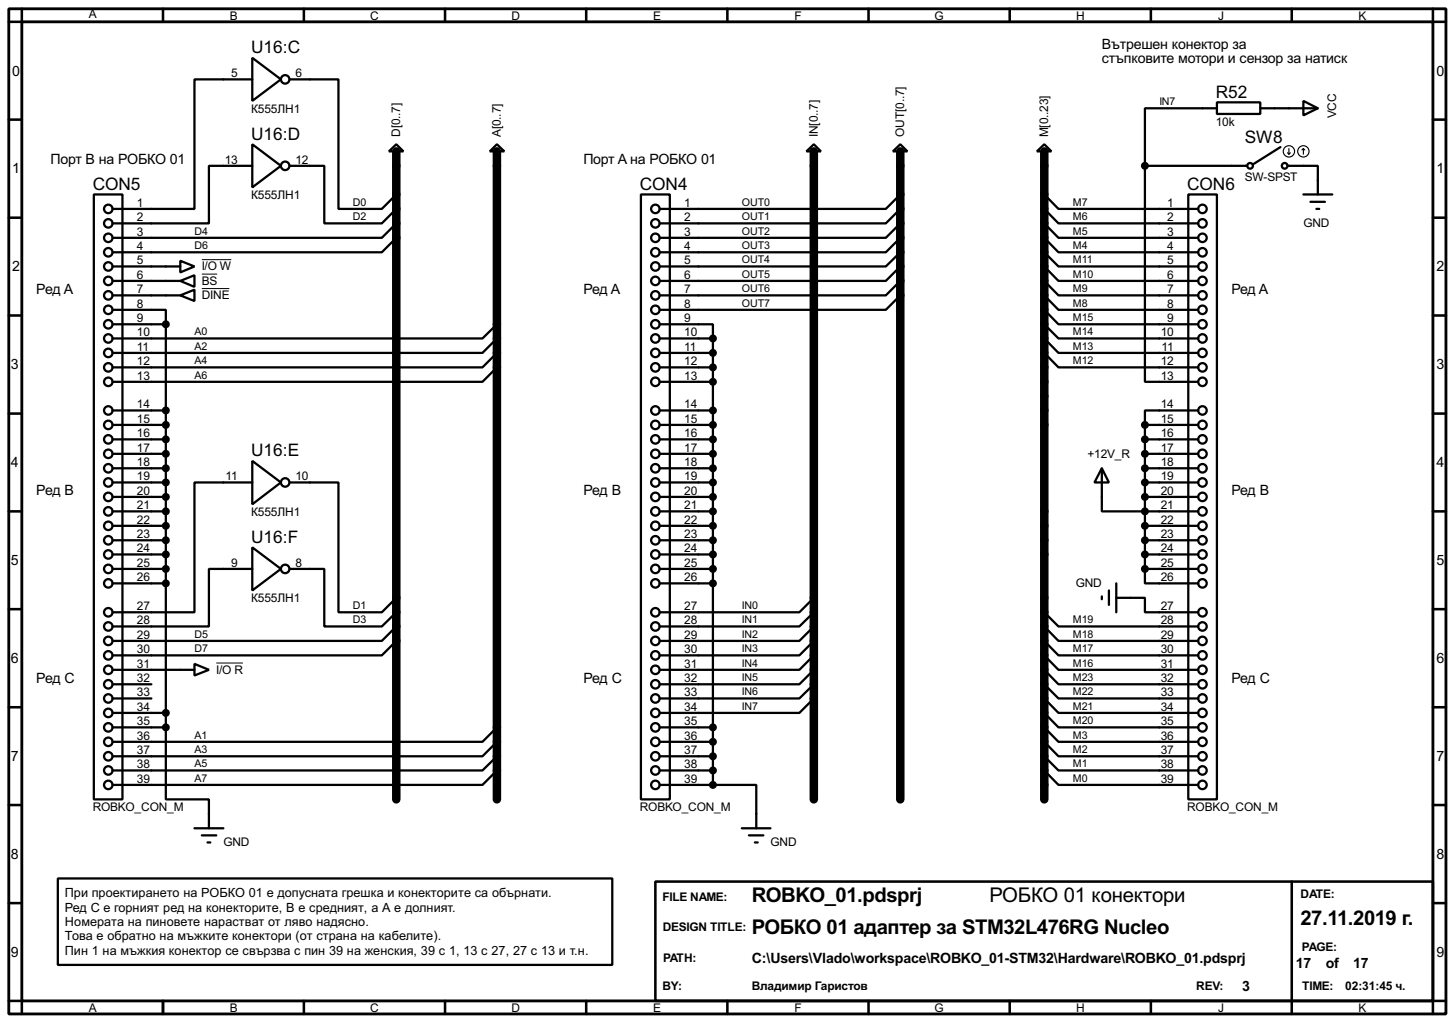
[picture p72: page 17]

Вътрешен конектор за
стъпковите мотори и сензор за натиск

Ред C е горният ред на конекторите, B е средният, а А е долният. При проектирането на РОБКО 01 е допусната грешка и конекторите са обърнати. Номерата на пиновете нарастват от ляво надясно.

FILE NAME:
DESIGN TITLE: РОБКО 01 адаптер за STM32L476RG Nucleo

Това е обратно на мъжките конектори (от страна на кабелите). Пин 1 на мъжкия конектор се свързва с пин 39 на женския, 39 с 1, 13 с 27, 27 с 13 и т.н.
