VladimirGaristov/ROBKO_01-STM32/Hardware/Documents/Connectors/TS8P8C-PCB-E.pdf

## SYSTEM CJ TELEPHONE JACKS & MODULAR PLUGS

# CviLux

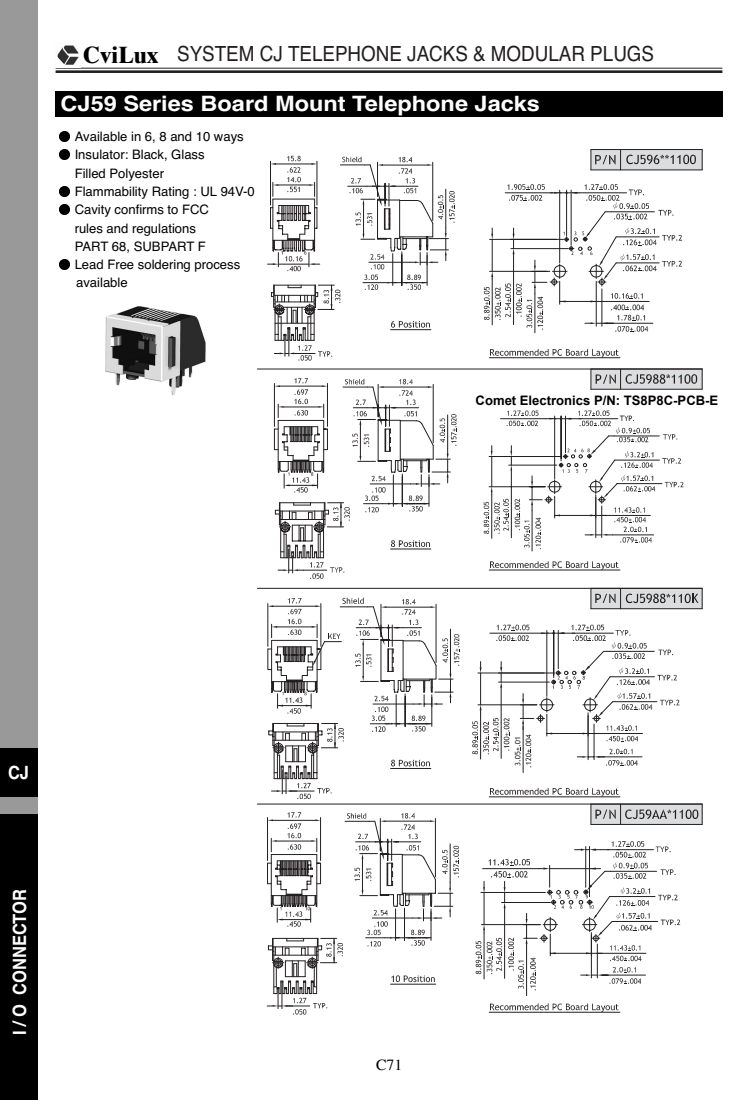
[picture p90: page 1]
I / O CONNECTOR

CJ59 Series Board Mount Telephone Jacks

´ Available in 6, 8 and 10 ways
´ Insulator: Black, Glass
Filled Polyester
´ Flammability Rating : UL 94V-0
´ Cavity confirms to FCC
rules and regulations
PART 68, SUBPART F
´ Lead Free soldering process
available
