VladimirGaristov/ROBKO_01-STM32/Hardware/Graphic output/dev_board.pdf

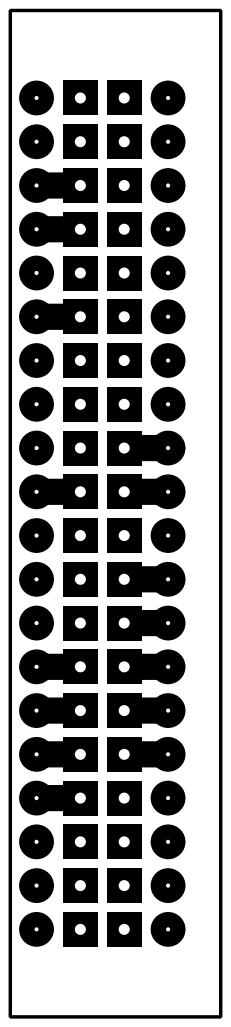
[picture p91: page 1]

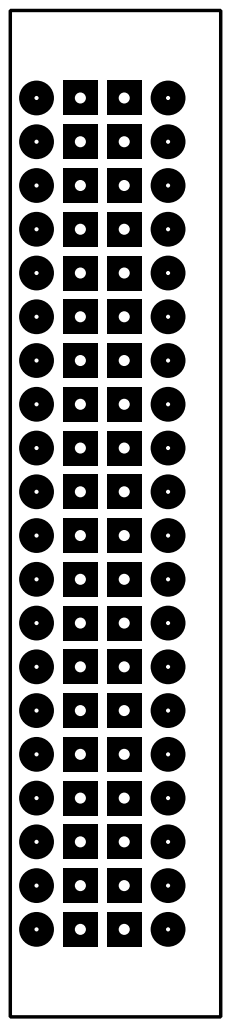
[picture p92: page 2]

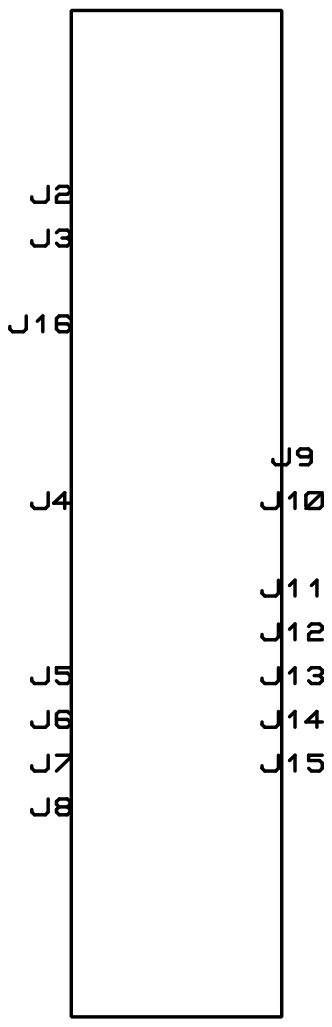
[picture p93: page 3]

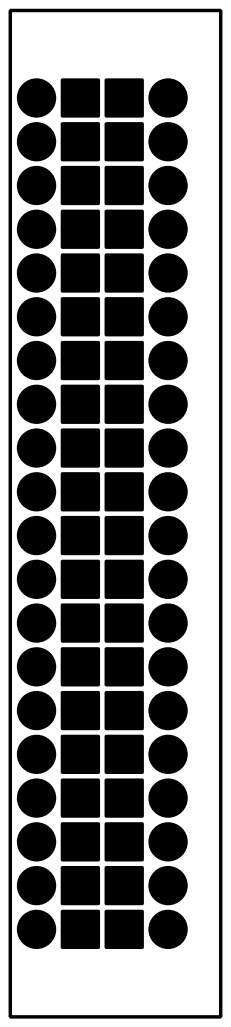
[picture p94: page 5]
