VladimirGaristov/ROBKO_01-STM32/Hardware/Graphic output/dev_board_drill.pdf

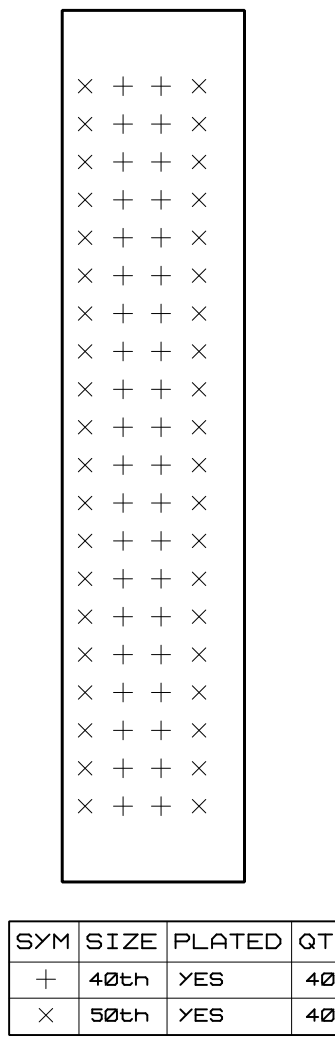
[picture p95: page 1]
