VladimirGaristov/ROBKO_01-STM32/Hardware/Graphic output/main_board.pdf

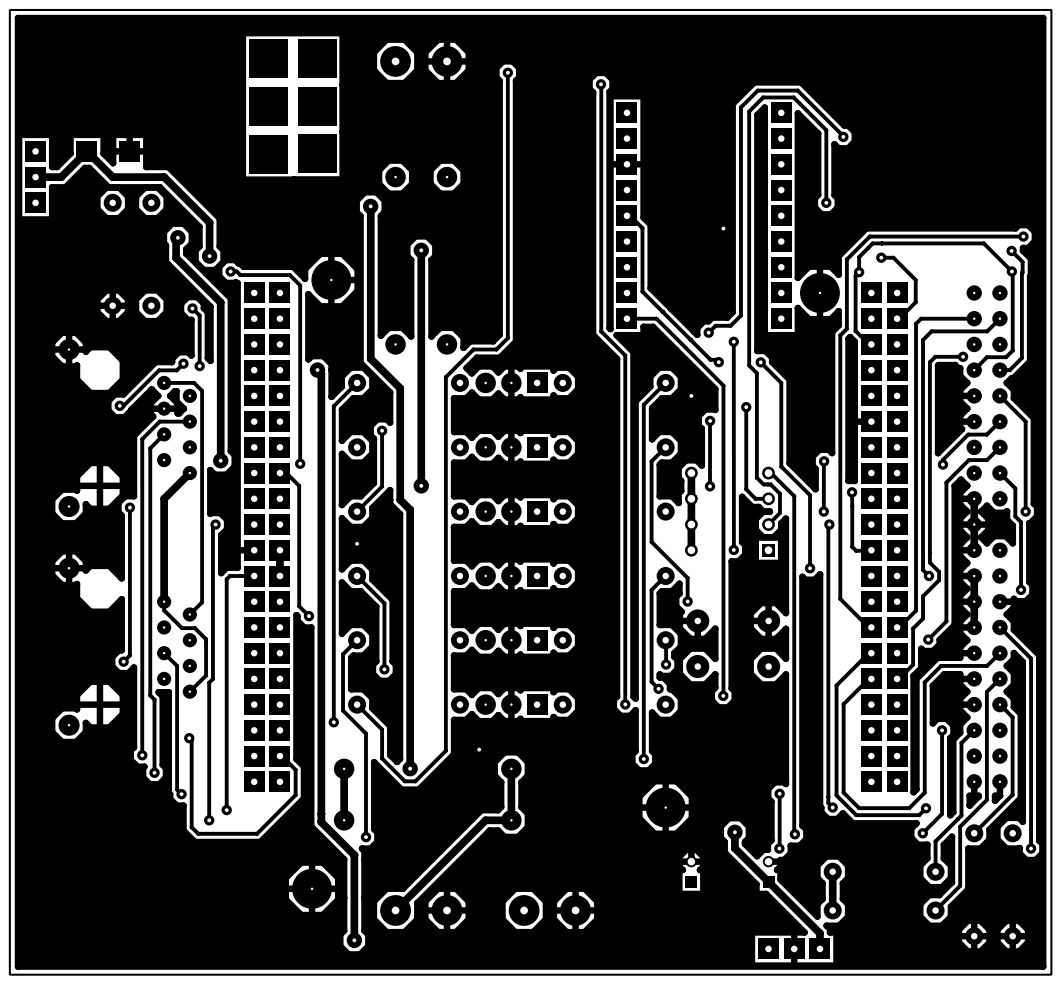
[picture p96: page 1]

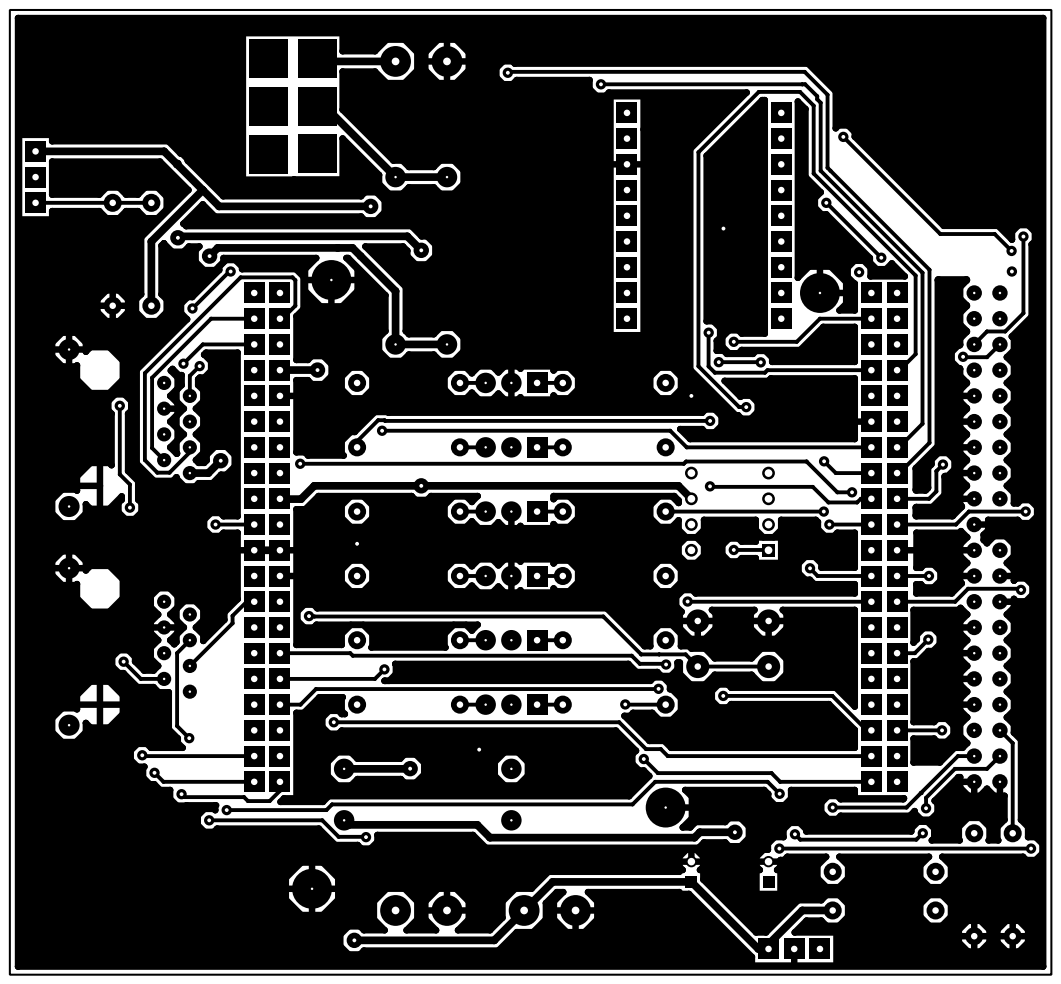
[picture p97: page 2]

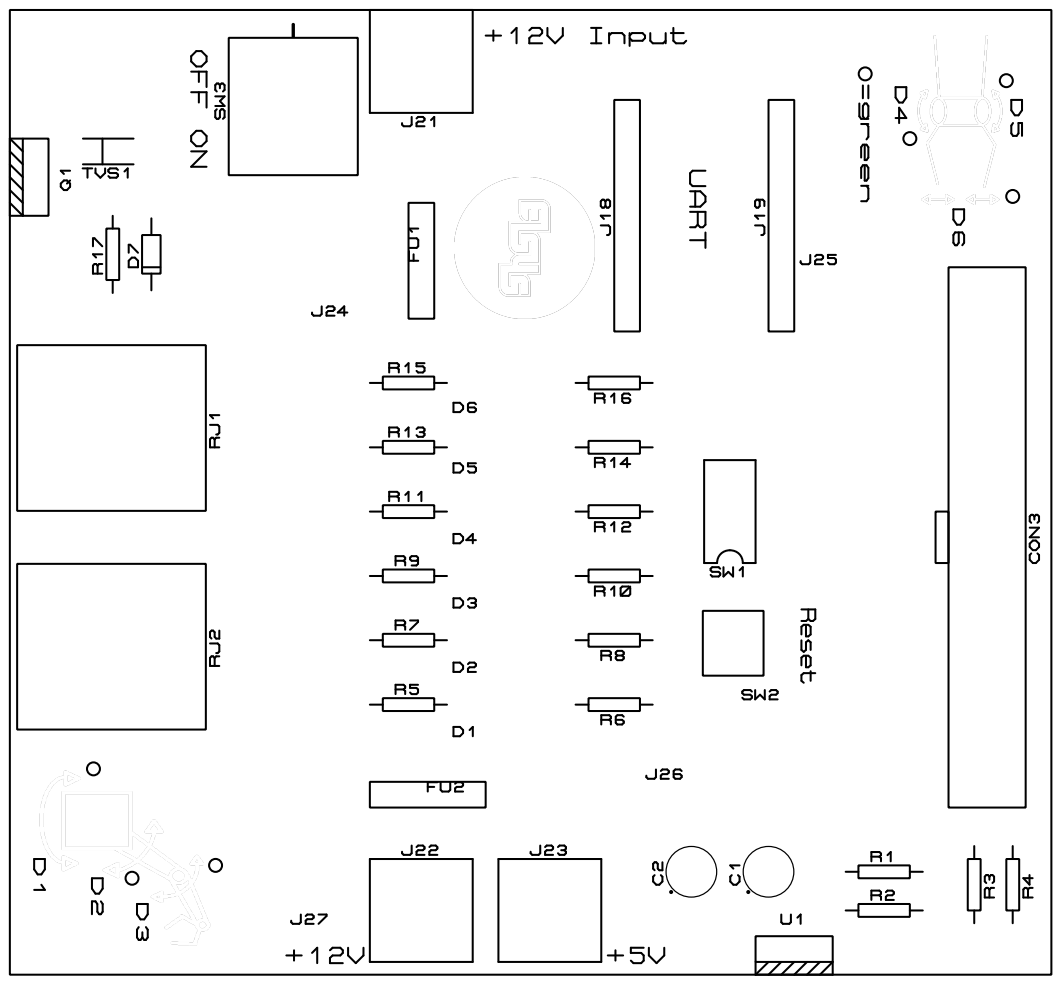
[picture p98: page 3]

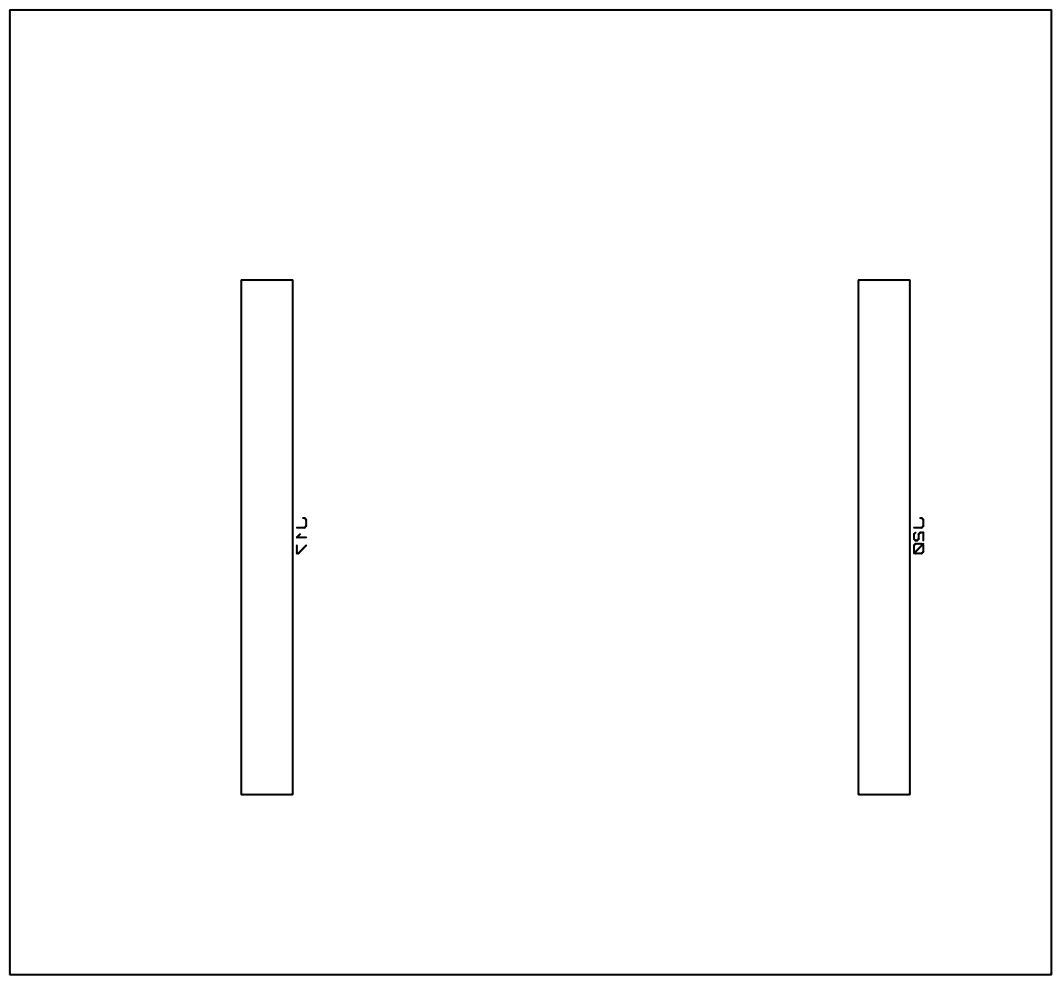
[picture p99: page 4]

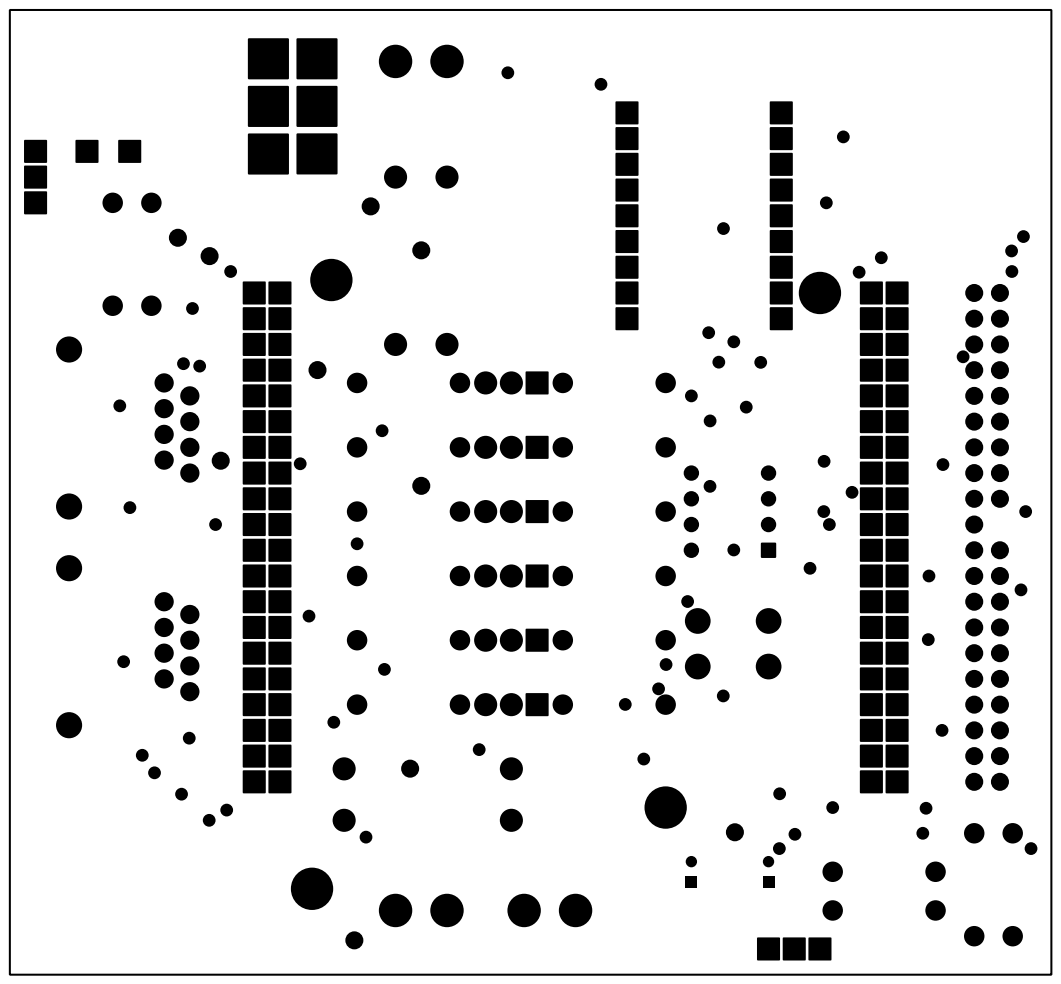
[picture p100: page 5]

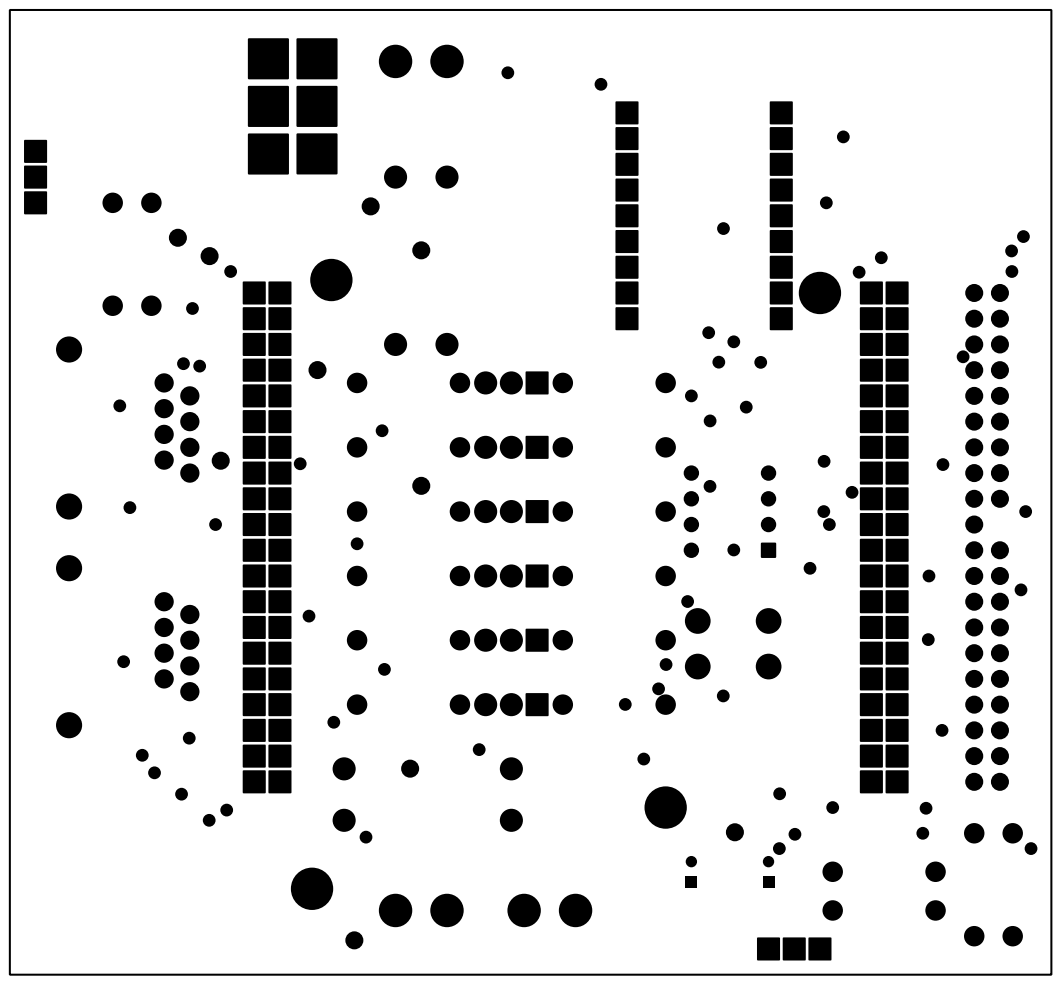
[picture p101: page 6]
