VladimirGaristov/ROBKO_01-STM32/Hardware/Graphic output/main_board_drill.pdf

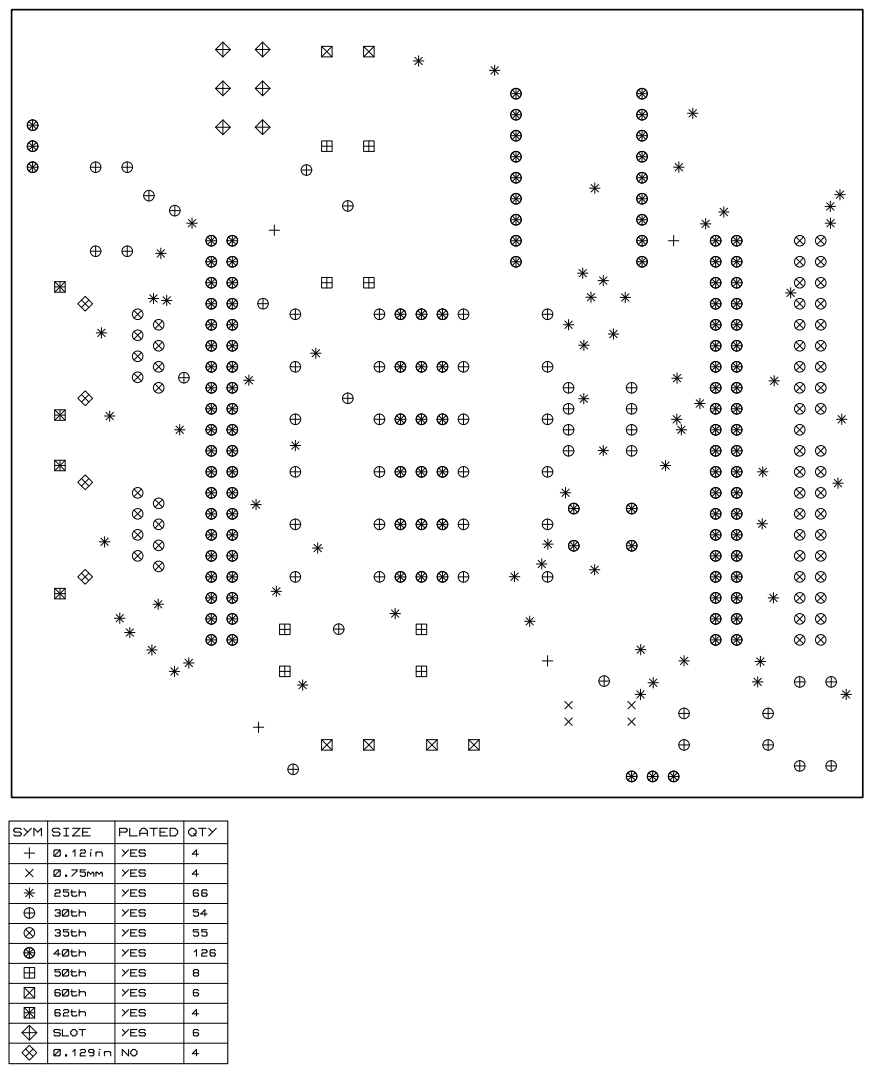
[picture p102: page 1]
