VladimirGaristov/ROBKO_01-STM32/Hardware/Graphic output/pata_board.pdf

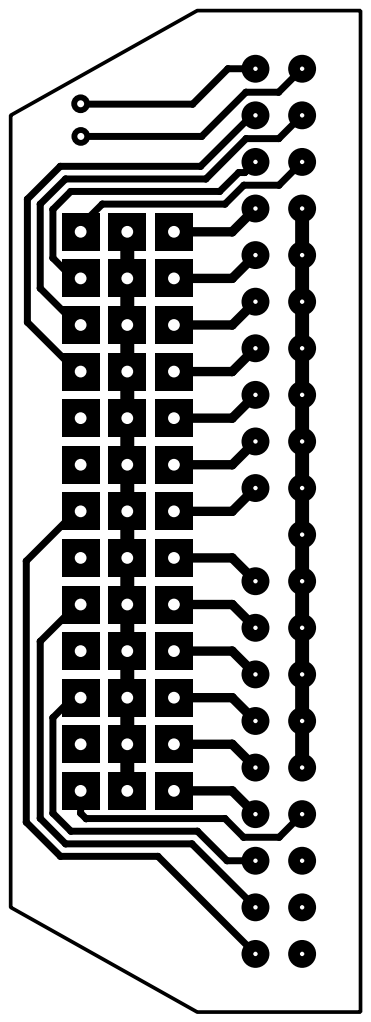
[picture p103: page 1]

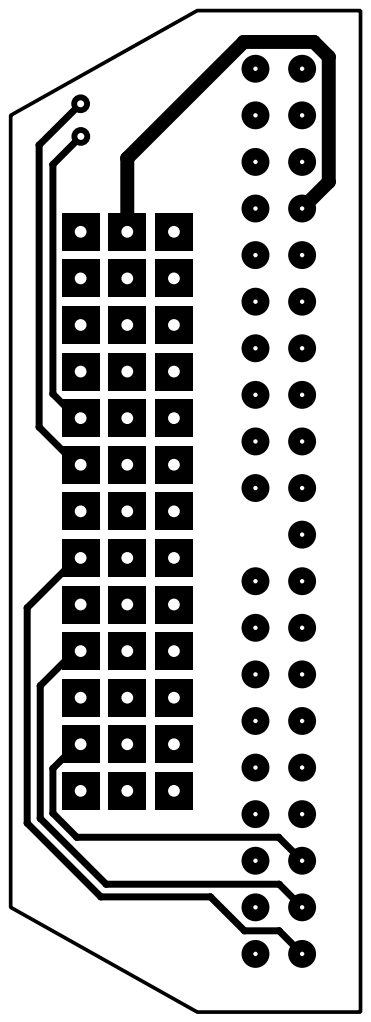
[picture p104: page 2]

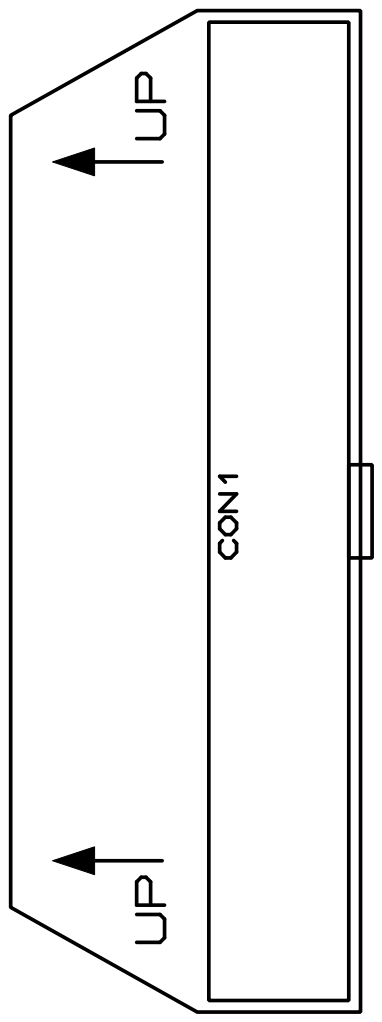
[picture p105: page 3]

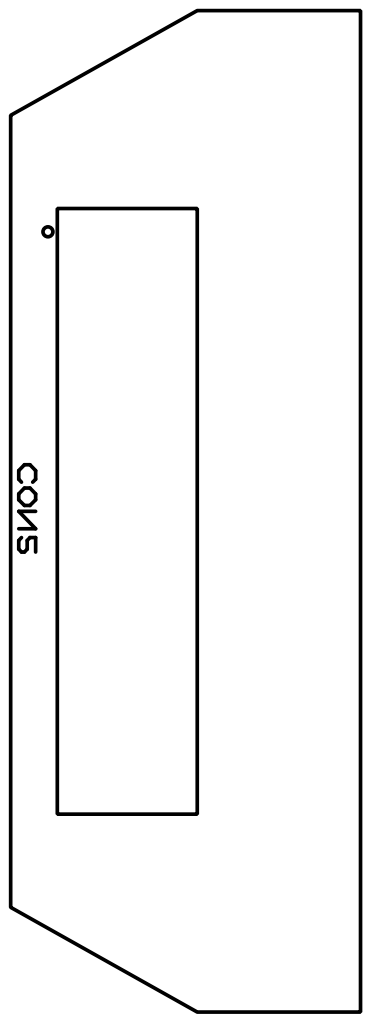
[picture p106: page 4]

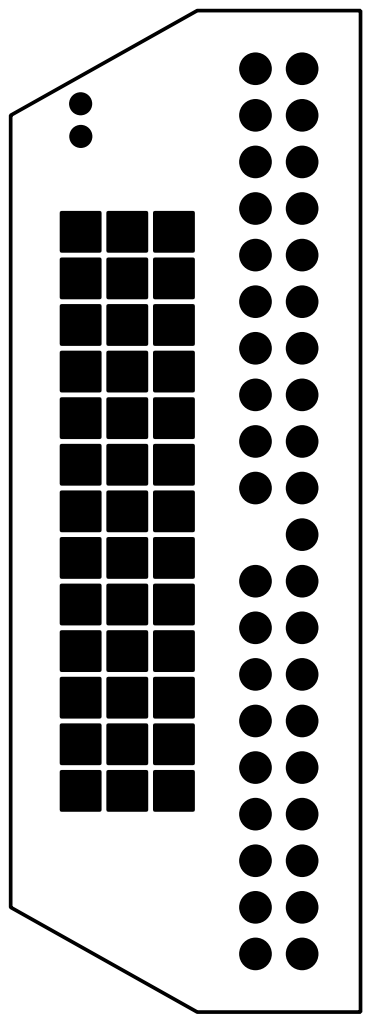
[picture p107: page 5]
