VladimirGaristov/ROBKO_01-STM32/Hardware/Graphic output/pata_board_drill.pdf

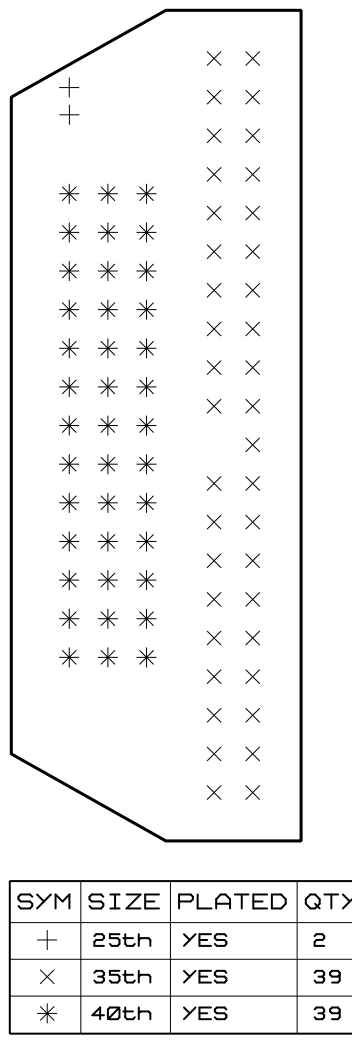
[picture p108: page 1]
