VladimirGaristov/ROBKO_01-STM32/Hardware/Documents/Tactile_switch.pdf

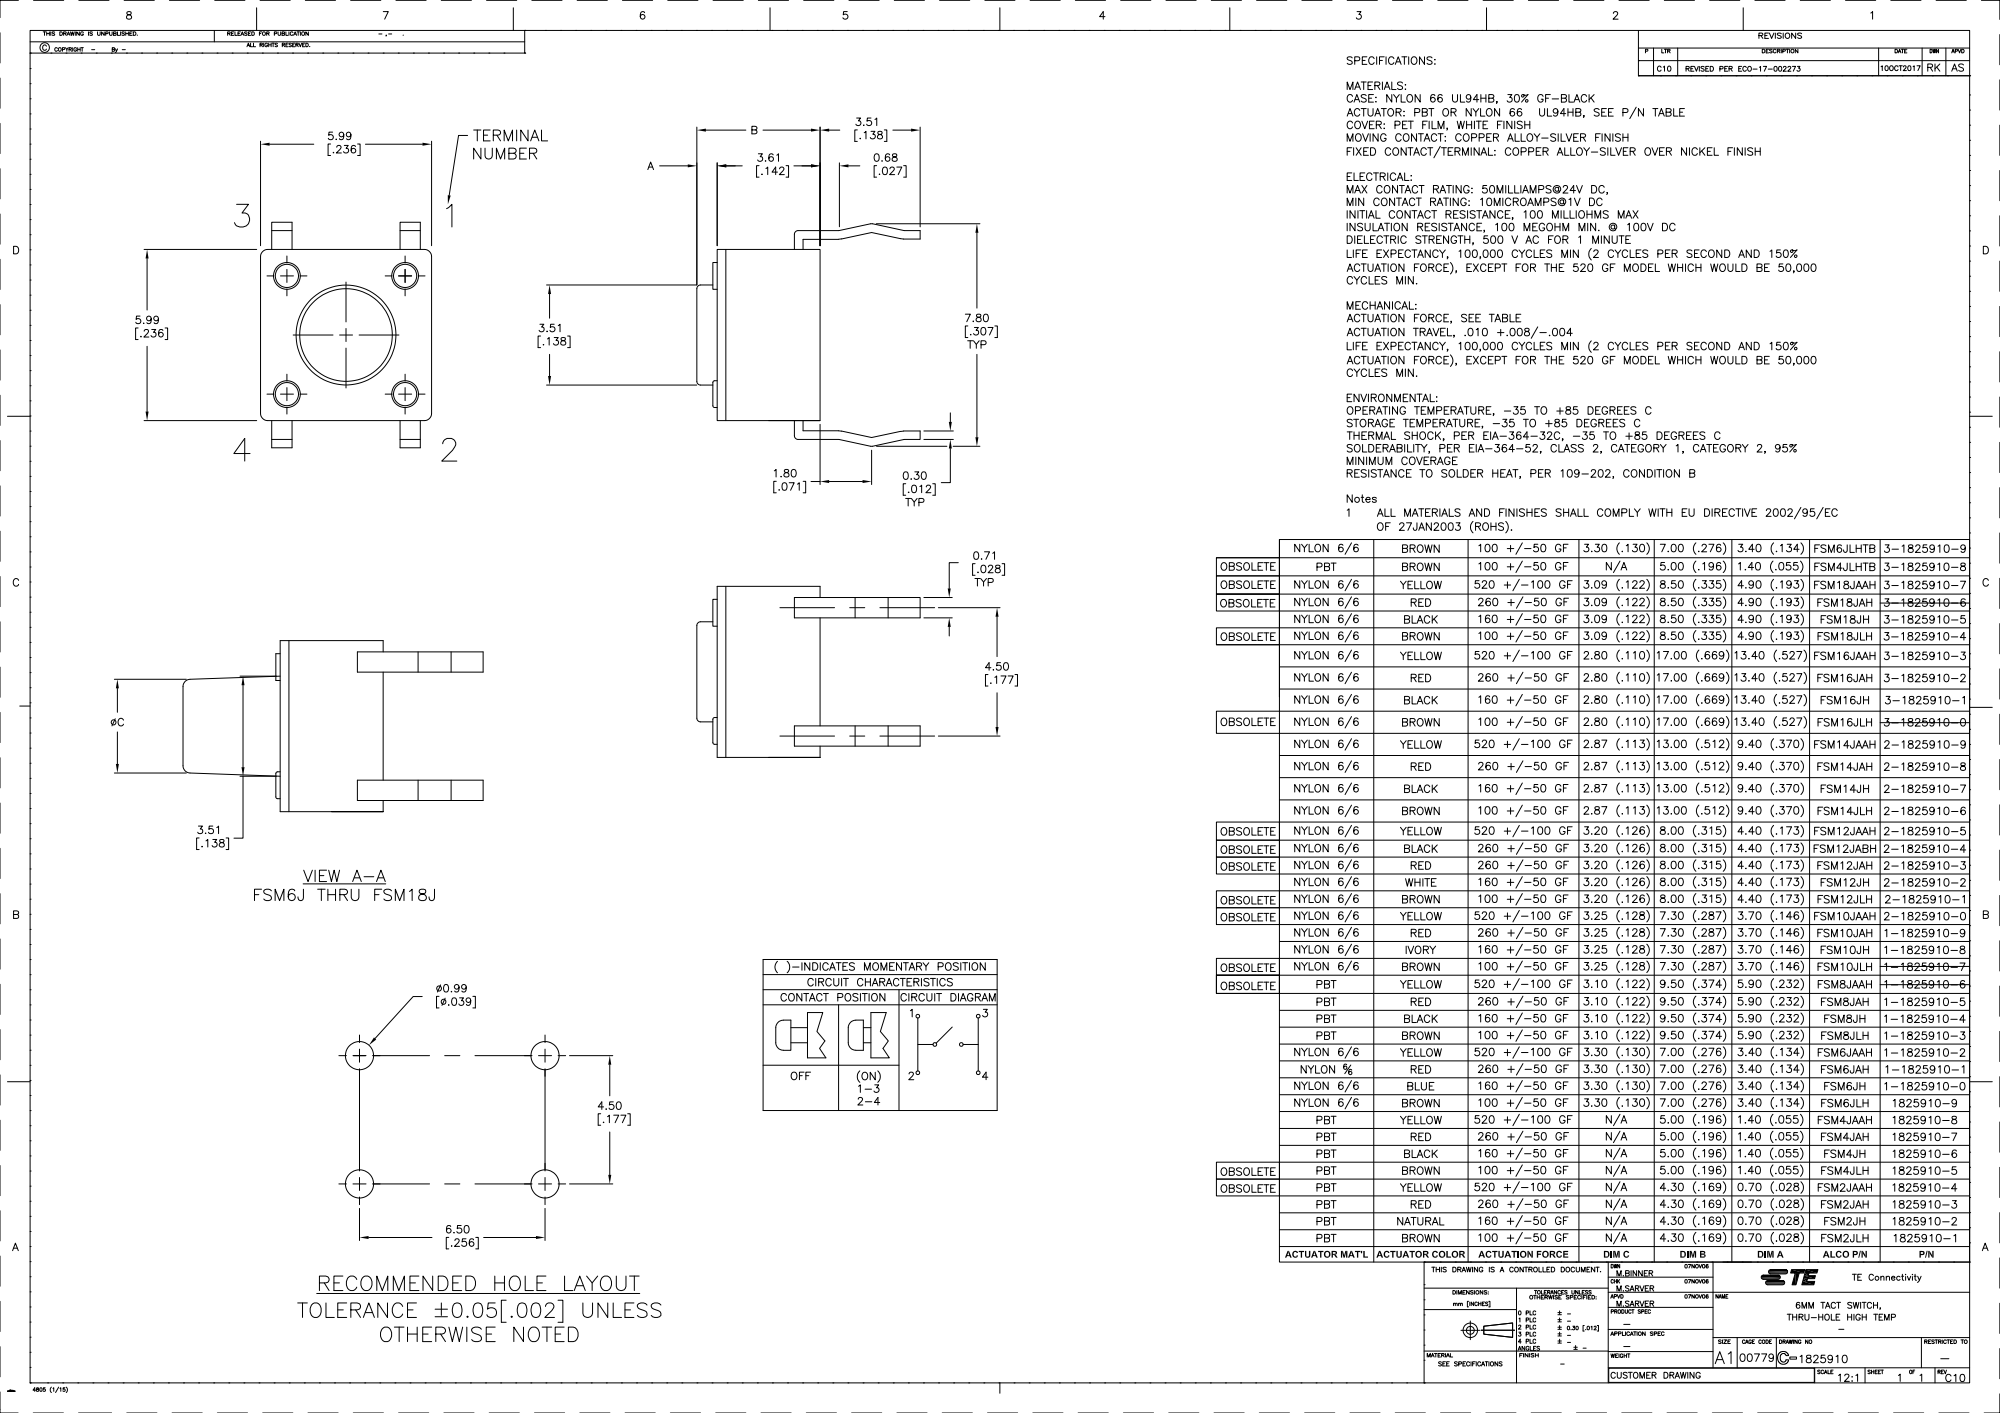
[picture p109: page 1]
