VladimirGaristov/ROBKO_01-STM32/Documents/ROBKO-01_Thesis/documents/dev_board.pdf

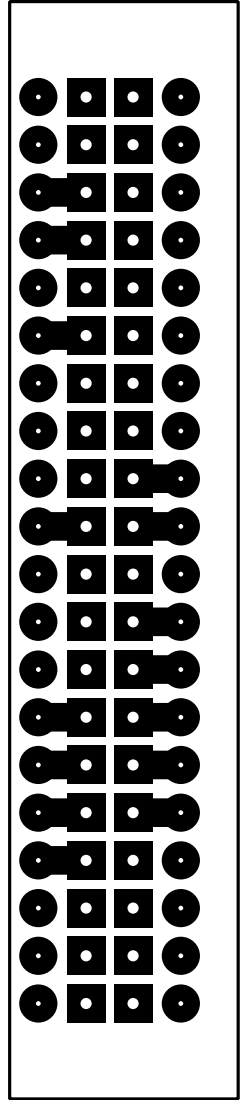
[picture p110: page 1]

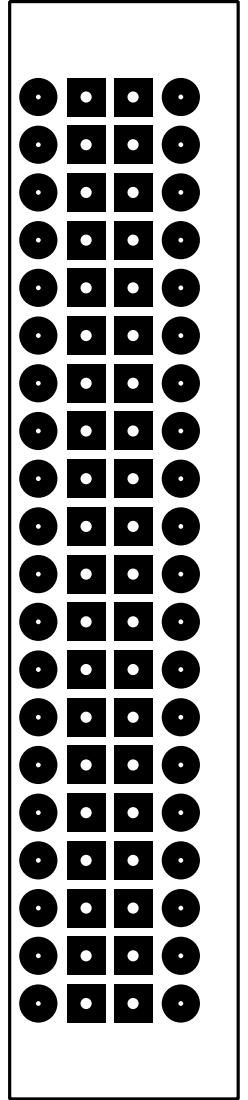
[picture p111: page 2]

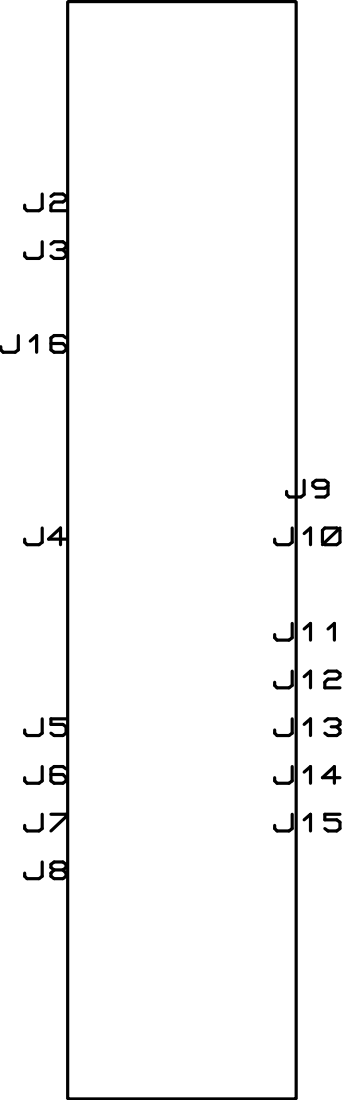
[picture p112: page 3]

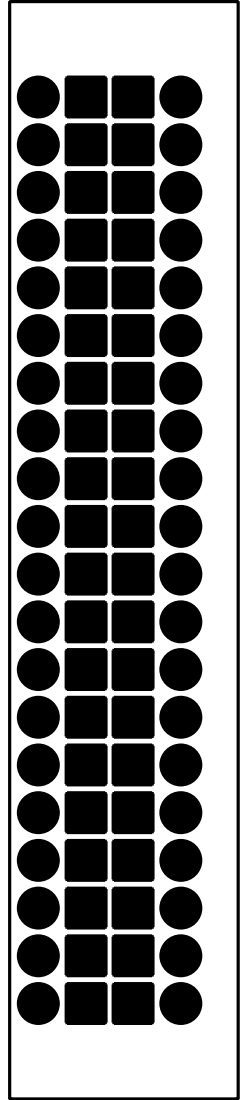
[picture p113: page 5]
