VladimirGaristov/ROBKO_01-STM32/Documents/ROBKO-01_Thesis/documents/dev_board_drill.pdf

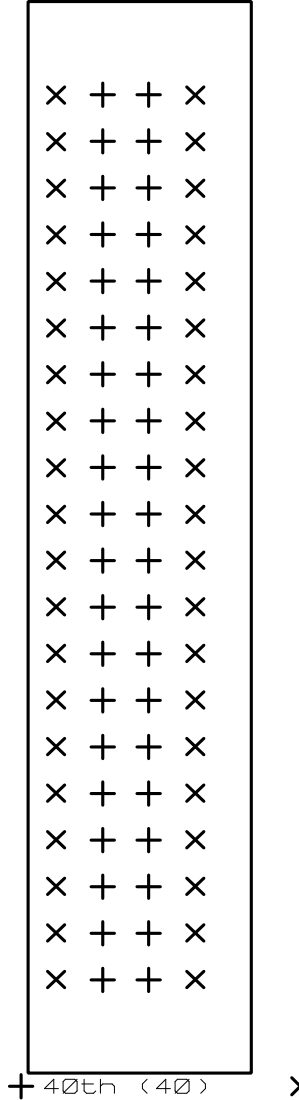
[picture p114: page 1]
