VladimirGaristov/ROBKO_01-STM32/Documents/ROBKO-01_Thesis/documents/main_board.pdf

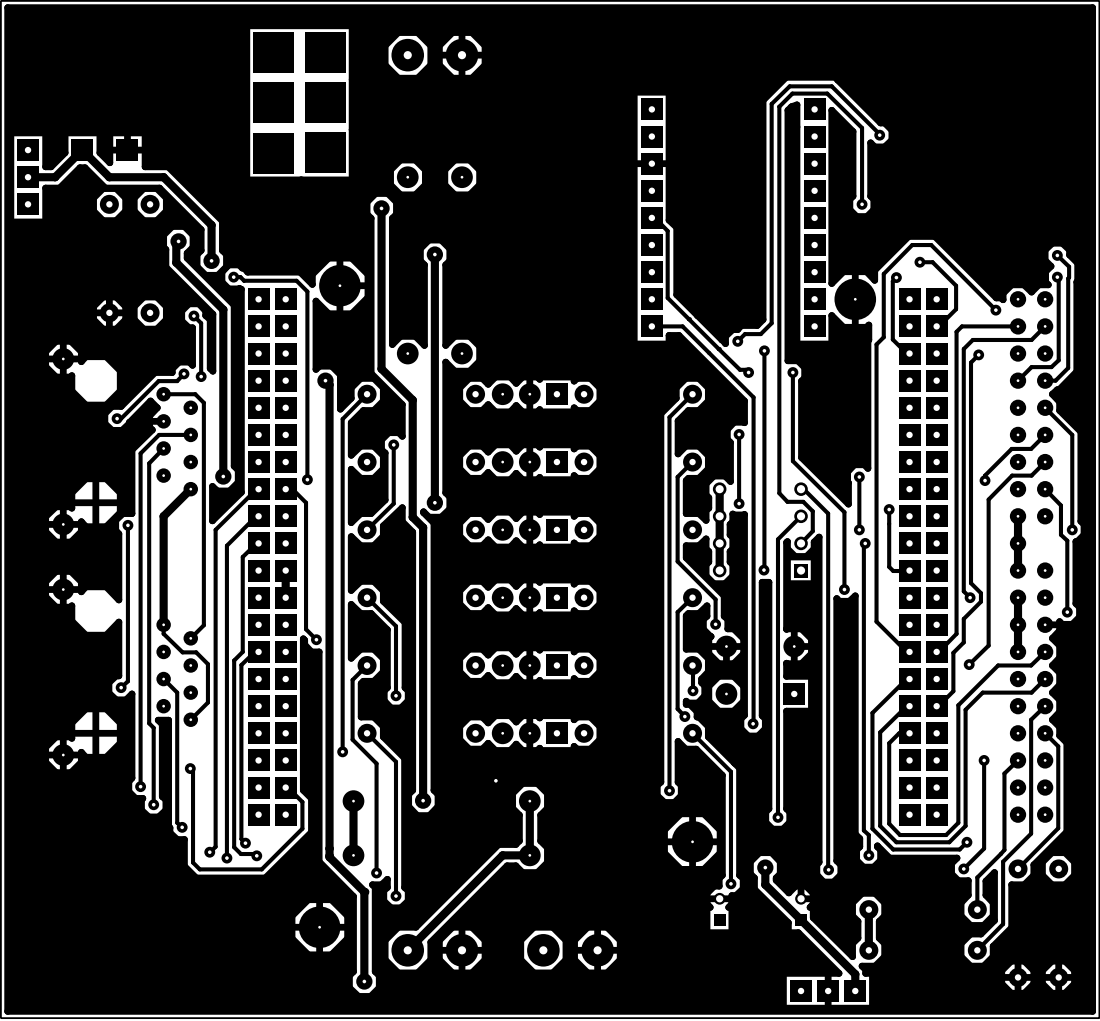
[picture p115: page 1]

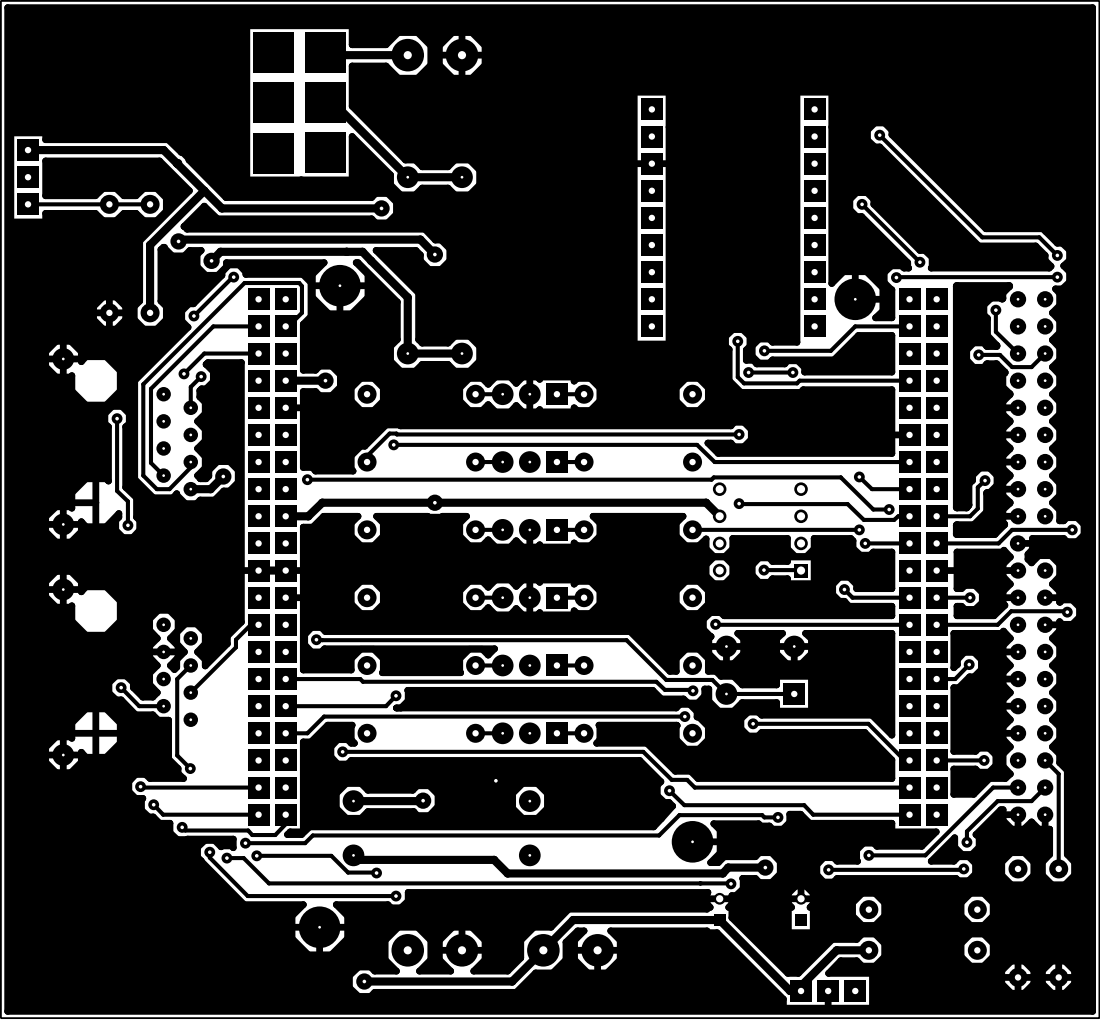
[picture p116: page 2]

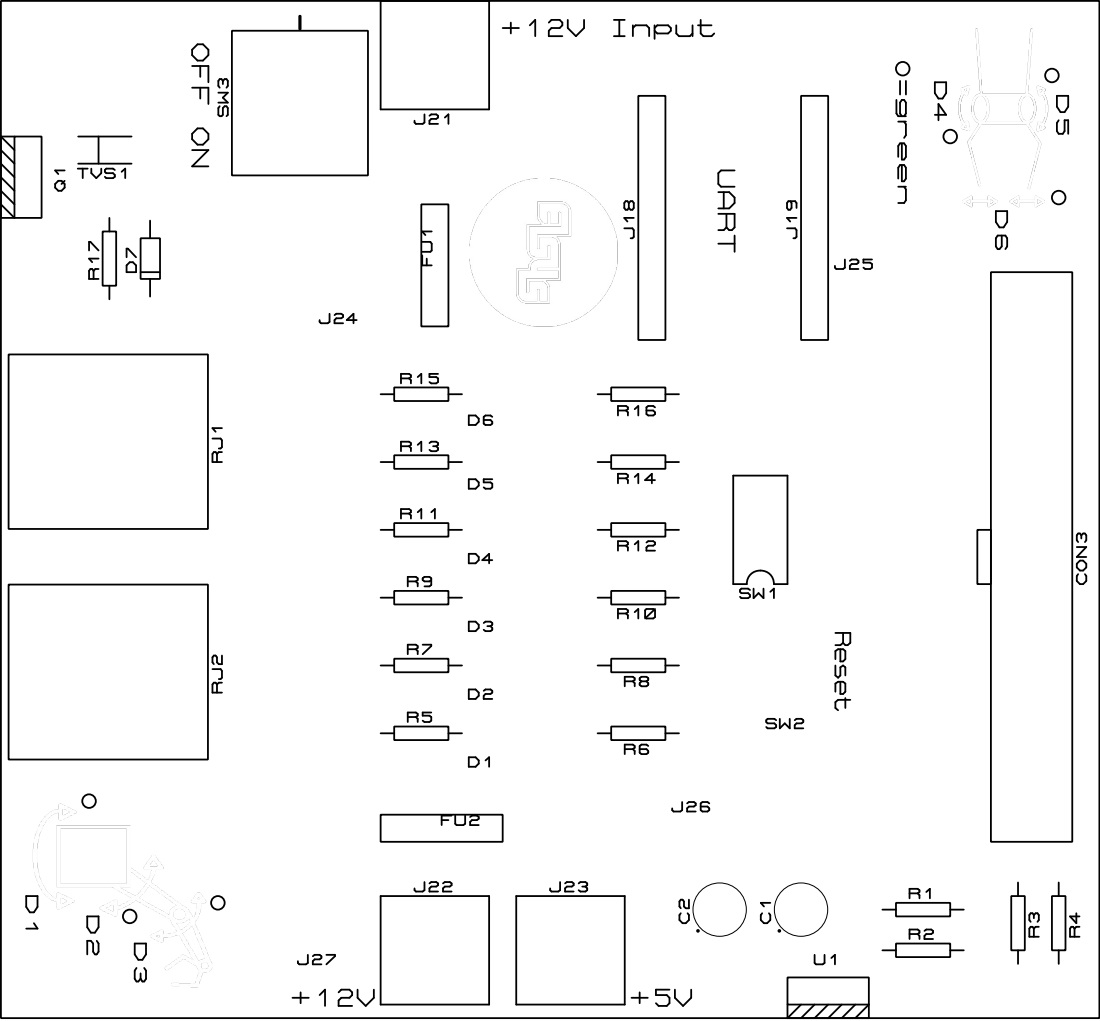
[picture p117: page 3]

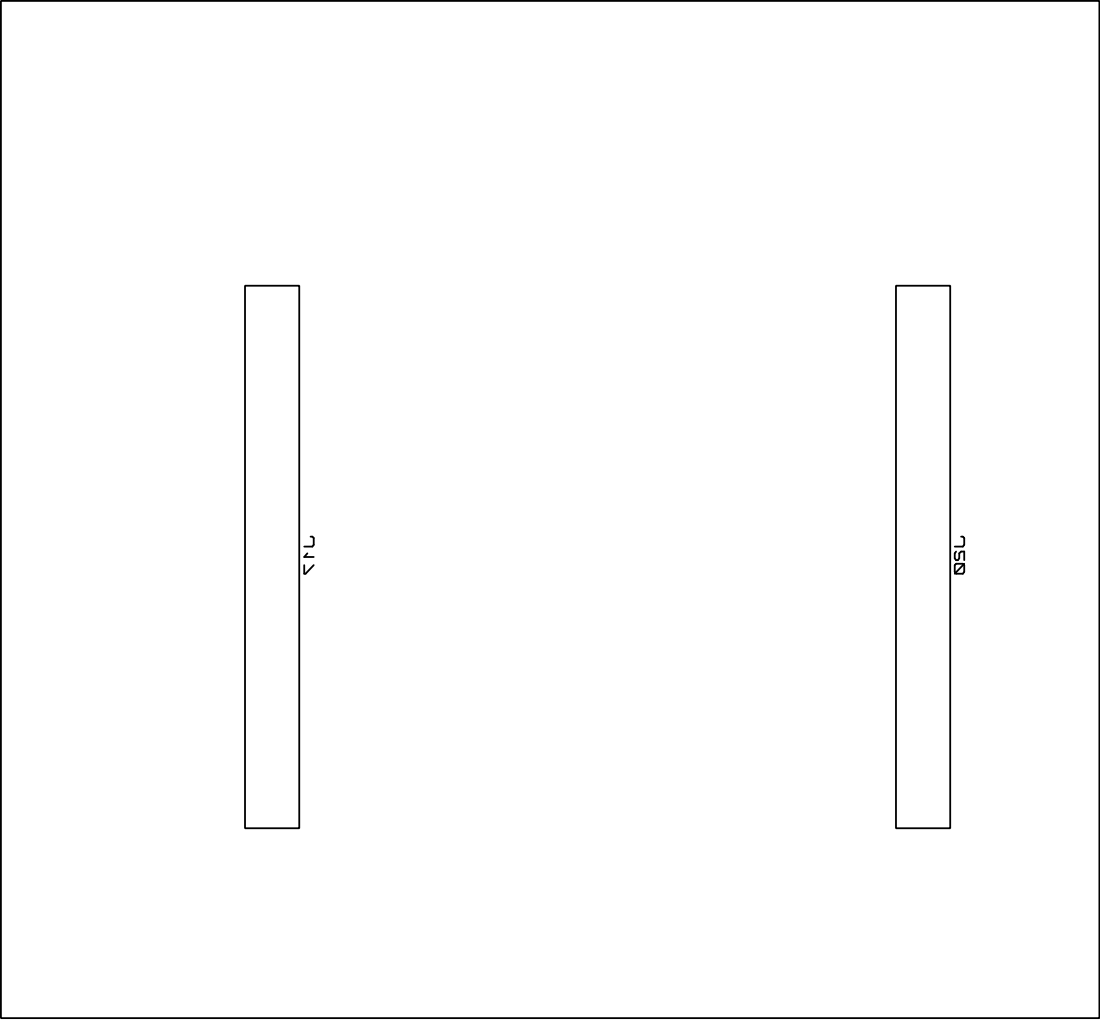
[picture p118: page 4]

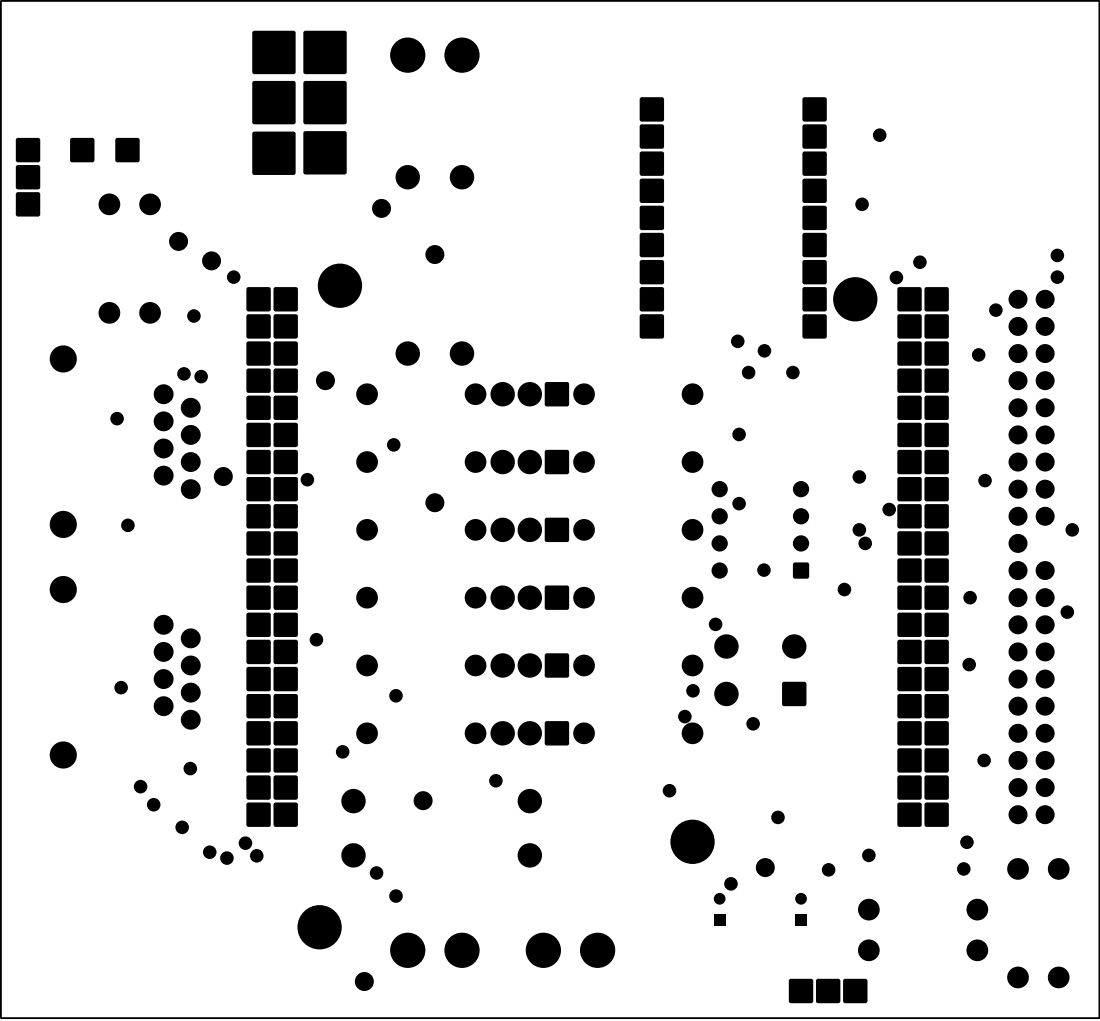
[picture p119: page 5]

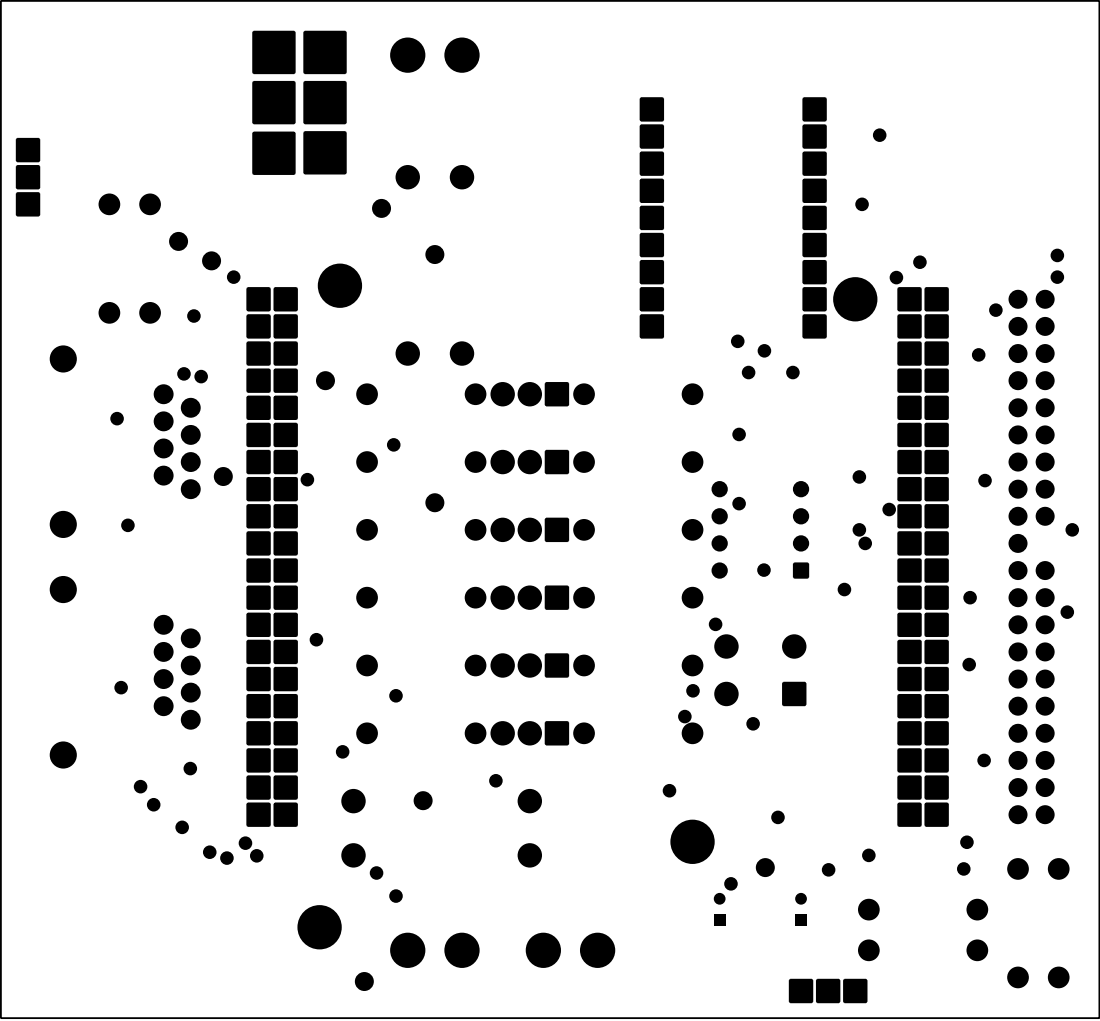
[picture p120: page 6]
