VladimirGaristov/ROBKO_01-STM32/Documents/ROBKO-01_Thesis/documents/main_board_drill.pdf

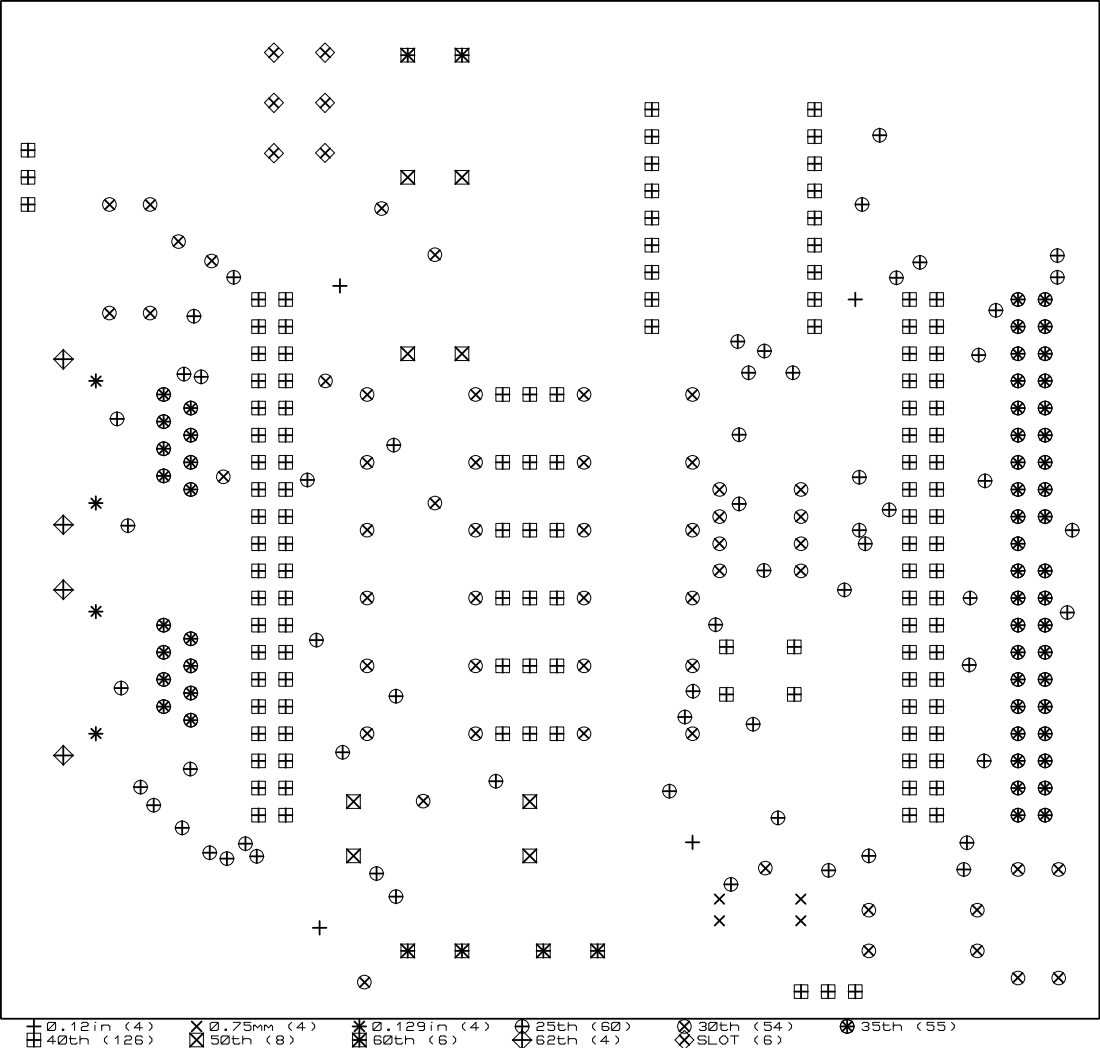
[picture p121: page 1]
