VladimirGaristov/ROBKO_01-STM32/Documents/ROBKO-01_Thesis/documents/pata_board.pdf

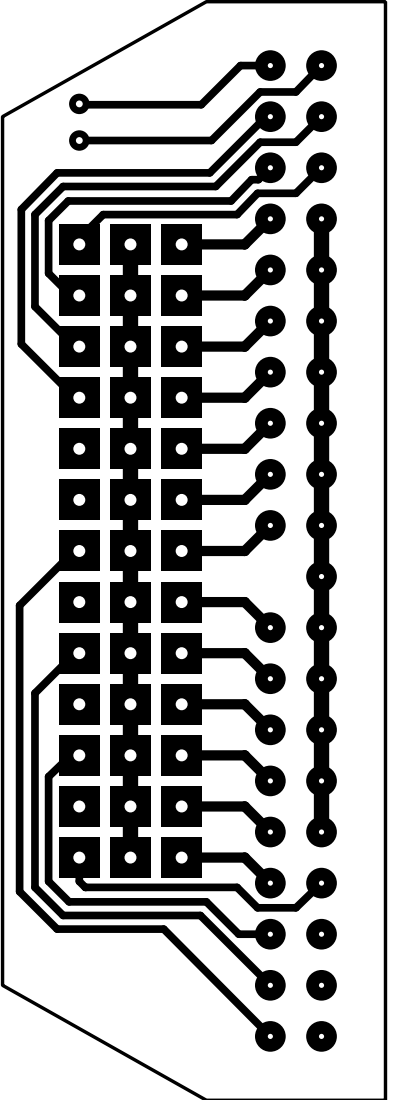
[picture p122: page 1]

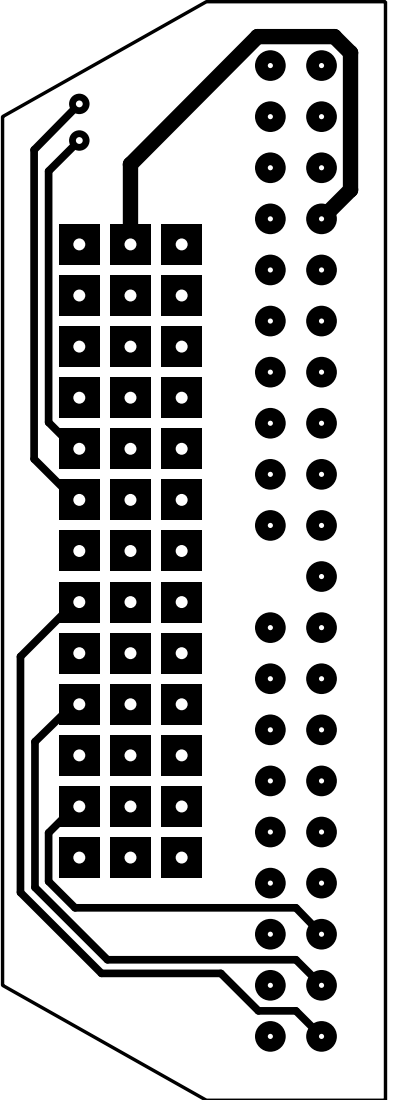
[picture p123: page 2]

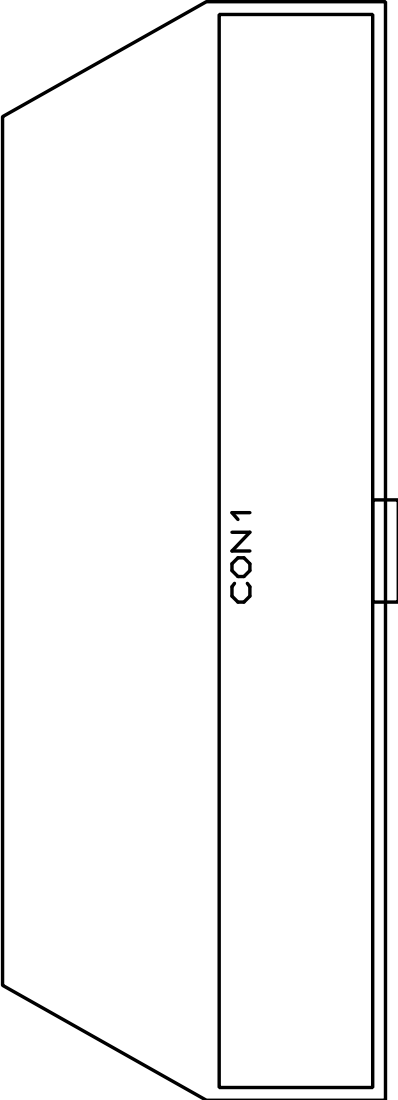
[picture p124: page 3]

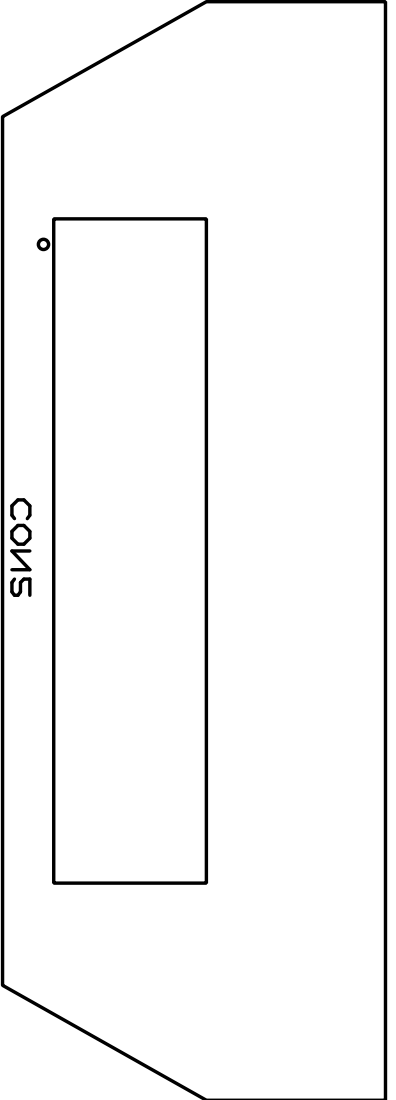
[picture p125: page 4]

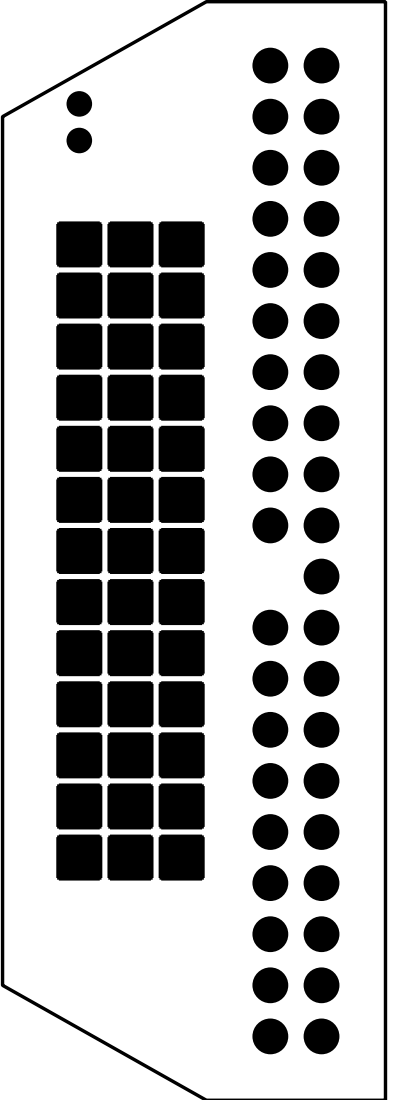
[picture p126: page 5]
