VladimirGaristov/ROBKO_01-STM32/Documents/ROBKO-01_Thesis/documents/pata_board_drill.pdf

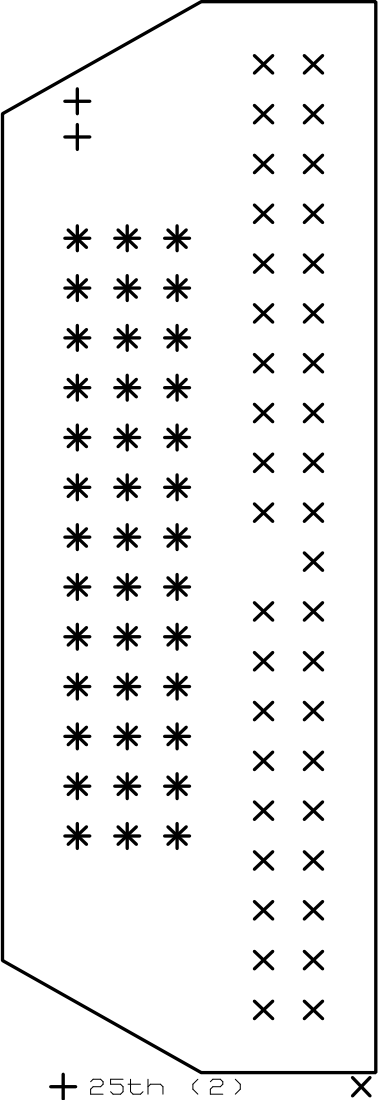
[picture p127: page 1]
