VladimirGaristov/ROBKO_01-STM32/Documents/ROBKO-01_Thesis/documents/top_silk.pdf

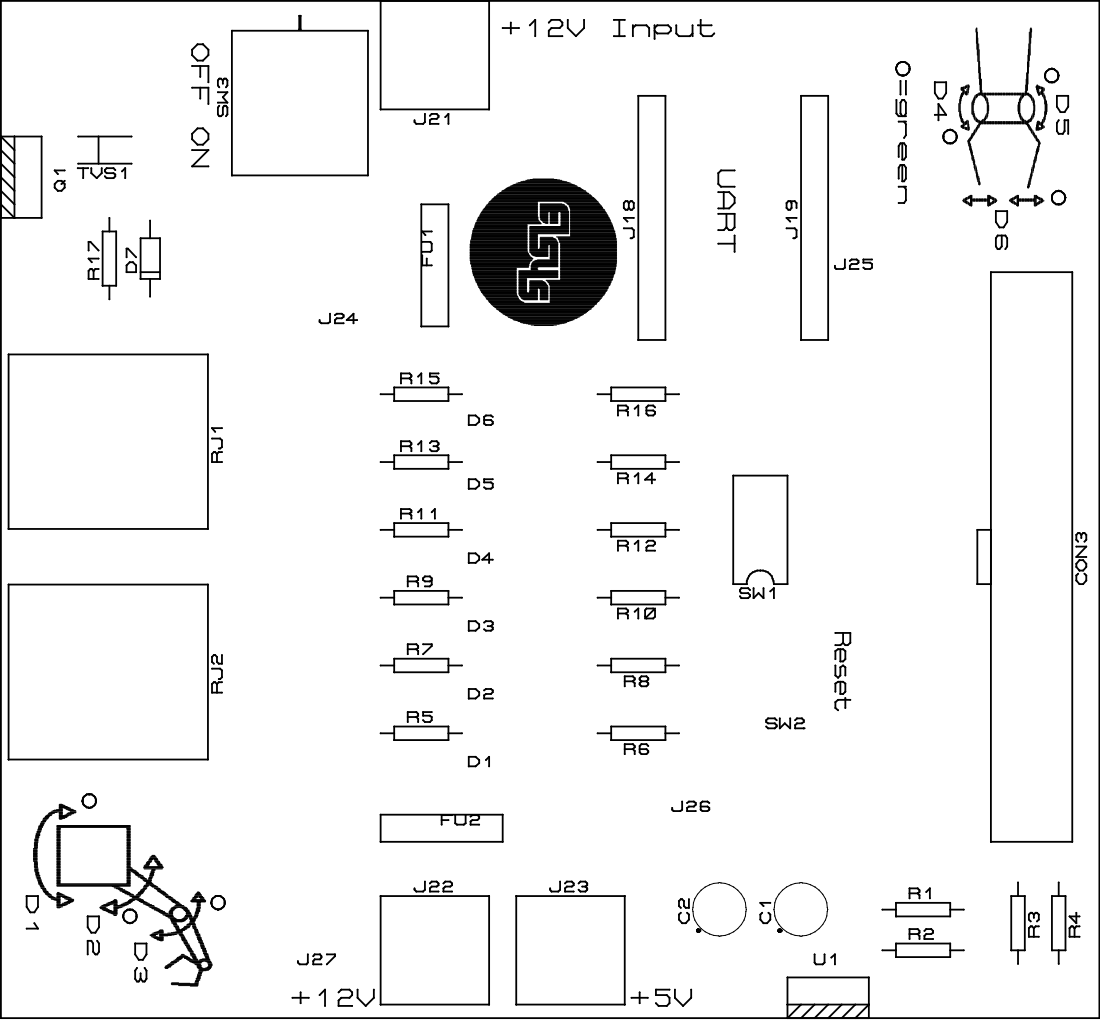
[picture p128: page 1]
