VladimirGaristov/ROBKO_01-STM32/(list of files, drawings)

Other design files:
Hardware/ROBKO_01.pdsprj
