VladimirGaristov/ROBKO_01-STM32/MCU_Firmware/src/main.c

/**
  ******************************************************************************
  * File Name          : main.c
  * Description        : Main program body
  ******************************************************************************
  ** This notice applies to any and all portions of this file
  * that are not between comment pairs USER CODE BEGIN and
  * USER CODE END. Other portions of this file, whether
  * inserted by the user or by software development tools
  * are owned by their respective copyright owners.
  *
  * COPYRIGHT(c) 2017 STMicroelectronics
  *
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
  ******************************************************************************
  */
/* Includes ------------------------------------------------------------------*/
#include "main.h"


/* USER CODE BEGIN PV */

/* USER CODE END PV */

static void LL_Init(void);
void SystemClock_Config(void);
static void MX_GPIO_Init(void);
static void MX_ADC1_Init(void);
static void MX_USART1_UART_Init(void);
void Configure_DMA(void);
static void Activate_ADC(void);

/* USER CODE BEGIN PFP */

/* USER CODE END PFP */

int main(void)
{
  /* MCU Configuration----------------------------------------------------------*/

  /* Reset of all peripherals, Initializes the Flash interface and the Systick. */
  LL_Init();

  /* Configure the system clock */
  SystemClock_Config();

  /* Initialize all configured peripherals */
  MX_GPIO_Init();
  Configure_DMA();
  MX_ADC1_Init();
  MX_USART1_UART_Init();
  Activate_ADC();

  /* USER CODE BEGIN 2 */
  DWT_Init();
  //Begin reading potentiometer values
  LL_ADC_REG_StartConversion(ADC1);
  //Enable ROBKO 01
  ENABLE_ROBKO();
  //Initialize ROBKO-01 registers
  stop_motor(ALL_MOTORS);
  //extern uint16_t local_step_time;
  //uint8_t repl[12] = {49, 50, 51, 52, 49, 50, 51, 52, 49, 50, 51, 52};
  //send_reply(repl, 12);
  //send_string("lolwtf is dis bs pls work u pis of shit");
  while (1)
  {
	  //LL_mDelay(10);
	  //send_reply(repl, 12);
	  //send_string("lolwtf is dis bs pls work u pis of shit");
	  //serial_test();
	  //LED_Blink();
	  //LED_wave();
	  //motor_test();
	  check_mode();		//Uncomment only this line for normal operation
	  //remote_control();
	  //LL_mDelay(local_step_time);
  }
  /* USER CODE END 2 */

  /* Infinite loop */
  while (1);
}

//TODO Add initialization checks

static void LL_Init(void)
{

  LL_APB2_GRP1_EnableClock(LL_APB2_GRP1_PERIPH_SYSCFG);
  LL_APB1_GRP1_EnableClock(LL_APB1_GRP1_PERIPH_PWR);

  NVIC_SetPriorityGrouping(NVIC_PRIORITYGROUP_4);

  /* System interrupt init*/
  /* MemoryManagement_IRQn interrupt configuration */
  NVIC_SetPriority(MemoryManagement_IRQn, NVIC_EncodePriority(NVIC_GetPriorityGrouping(),0, 0));
  /* BusFault_IRQn interrupt configuration */
  NVIC_SetPriority(BusFault_IRQn, NVIC_EncodePriority(NVIC_GetPriorityGrouping(),0, 0));
  /* UsageFault_IRQn interrupt configuration */
  NVIC_SetPriority(UsageFault_IRQn, NVIC_EncodePriority(NVIC_GetPriorityGrouping(),0, 0));
  /* SVCall_IRQn interrupt configuration */
  NVIC_SetPriority(SVCall_IRQn, NVIC_EncodePriority(NVIC_GetPriorityGrouping(),0, 0));
  /* DebugMonitor_IRQn interrupt configuration */
  NVIC_SetPriority(DebugMonitor_IRQn, NVIC_EncodePriority(NVIC_GetPriorityGrouping(),0, 0));
  /* PendSV_IRQn interrupt configuration */
  NVIC_SetPriority(PendSV_IRQn, NVIC_EncodePriority(NVIC_GetPriorityGrouping(),0, 0));
  /* SysTick_IRQn interrupt configuration */
  NVIC_SetPriority(SysTick_IRQn, NVIC_EncodePriority(NVIC_GetPriorityGrouping(),0, 0));
  /* USER CODE BEGIN 3 */
  // USART1 interrupt configuration
  NVIC_SetPriority(USART1_IRQn, NVIC_EncodePriority(NVIC_GetPriorityGrouping(), 0, 0));
  NVIC_EnableIRQ(USART1_IRQn);
  //DMA interrupt configuration
  NVIC_SetPriority(DMA1_Channel1_IRQn, NVIC_EncodePriority(NVIC_GetPriorityGrouping(), 0, 1));
  NVIC_EnableIRQ(DMA1_Channel1_IRQn);
  /* USER CODE END 3 */

}

/** System Clock Configuration */
void SystemClock_Config(void)
{
  LL_FLASH_SetLatency(LL_FLASH_LATENCY_2);
  if(LL_FLASH_GetLatency() != LL_FLASH_LATENCY_2)
  {
	   Error_Handler();
  }
  LL_PWR_SetRegulVoltageScaling(LL_PWR_REGU_VOLTAGE_SCALE1);
  LL_RCC_MSI_Enable();

  /* Wait till MSI is ready */
  while(LL_RCC_MSI_IsReady() != 1)
  {

  }
  LL_RCC_MSI_EnableRangeSelection();
  LL_RCC_MSI_SetRange(LL_RCC_MSIRANGE_6);
  LL_RCC_MSI_SetCalibTrimming(0);
  LL_RCC_PLL_ConfigDomain_SYS(LL_RCC_PLLSOURCE_MSI, LL_RCC_PLLM_DIV_1, 20, LL_RCC_PLLR_DIV_2);
  LL_RCC_PLL_EnableDomain_SYS();
  LL_RCC_PLL_Enable();

  /* Wait till PLL is ready */
  while(LL_RCC_PLL_IsReady() != 1)
  {

  }
  LL_RCC_PLLSAI1_ConfigDomain_ADC(LL_RCC_PLLSOURCE_MSI, LL_RCC_PLLM_DIV_1, 16, LL_RCC_PLLSAI1R_DIV_8);
  LL_RCC_PLLSAI1_EnableDomain_ADC();
  LL_RCC_PLLSAI1_Enable();

  /* Wait till PLLSAI1 is ready */
  while(LL_RCC_PLLSAI1_IsReady() != 1)
  {

  }
  LL_RCC_SetAHBPrescaler(LL_RCC_SYSCLK_DIV_1);
  LL_RCC_SetAPB1Prescaler(LL_RCC_APB1_DIV_1);
  LL_RCC_SetAPB2Prescaler(LL_RCC_APB2_DIV_1);
  LL_RCC_SetSysClkSource(LL_RCC_SYS_CLKSOURCE_PLL);

  /* Wait till System clock is ready */
  while(LL_RCC_GetSysClkSource() != LL_RCC_SYS_CLKSOURCE_STATUS_PLL)
  {

  }
  LL_Init1msTick(40000000);
  LL_SYSTICK_SetClkSource(LL_SYSTICK_CLKSOURCE_HCLK);
  LL_SetSystemCoreClock(40000000);
  LL_RCC_SetADCClockSource(LL_RCC_ADC_CLKSOURCE_PLLSAI1);

  /* SysTick_IRQn interrupt configuration */
  NVIC_SetPriority(SysTick_IRQn, NVIC_EncodePriority(NVIC_GetPriorityGrouping(),0, 0));
}

/* ADC1 init function */
static void MX_ADC1_Init(void)
{

  LL_ADC_InitTypeDef ADC_InitStruct;
  LL_ADC_REG_InitTypeDef ADC_REG_InitStruct;
  LL_ADC_CommonInitTypeDef ADC_CommonInitStruct;
  LL_GPIO_InitTypeDef GPIO_InitStruct;

  /* Peripheral clock enable */
  LL_AHB2_GRP1_EnableClock(LL_AHB2_GRP1_PERIPH_ADC);

  /**ADC1 GPIO Configuration
  PC0   ------> ADC1_IN1
  PC1   ------> ADC1_IN2
  PC2   ------> ADC1_IN3
  PC3   ------> ADC1_IN4
  */
  GPIO_InitStruct.Pin = LEFT_RIGHT_POT_PIN|SHOULDER_POT_PIN|ELBOW_POT_PIN|CLAW_ROTATION_POT_PIN;
  GPIO_InitStruct.Mode = LL_GPIO_MODE_ANALOG;
  GPIO_InitStruct.Pull = LL_GPIO_PULL_NO;
  LL_GPIO_Init(INPUT_PORT, &GPIO_InitStruct);
  LL_GPIO_EnablePinAnalogControl(INPUT_PORT, LEFT_RIGHT_POT_PIN|SHOULDER_POT_PIN|ELBOW_POT_PIN|CLAW_ROTATION_POT_PIN);

  /**Common config*/
  ADC_InitStruct.Resolution = LL_ADC_RESOLUTION_12B;
  ADC_InitStruct.DataAlignment = LL_ADC_DATA_ALIGN_RIGHT;
  ADC_InitStruct.LowPowerMode = LL_ADC_LP_MODE_NONE;
  LL_ADC_Init(ADC1, &ADC_InitStruct);
  ADC_REG_InitStruct.TriggerSource = LL_ADC_REG_TRIG_SOFTWARE;
  ADC_REG_InitStruct.SequencerLength = LL_ADC_REG_SEQ_SCAN_ENABLE_4RANKS;
  ADC_REG_InitStruct.SequencerDiscont = LL_ADC_REG_SEQ_DISCONT_DISABLE;
  ADC_REG_InitStruct.ContinuousMode = LL_ADC_REG_CONV_CONTINUOUS;
  ADC_REG_InitStruct.DMATransfer = LL_ADC_REG_DMA_TRANSFER_UNLIMITED;
  ADC_REG_InitStruct.Overrun = LL_ADC_REG_OVR_DATA_OVERWRITTEN;
  LL_ADC_REG_Init(ADC1, &ADC_REG_InitStruct);
  LL_ADC_SetOverSamplingScope(ADC1, LL_ADC_OVS_DISABLE);
  ADC_CommonInitStruct.CommonClock = LL_ADC_CLOCK_ASYNC_DIV1;
  ADC_CommonInitStruct.Multimode = LL_ADC_MULTI_INDEPENDENT;
  LL_ADC_CommonInit(__LL_ADC_COMMON_INSTANCE(ADC1), &ADC_CommonInitStruct);
  LL_ADC_EnableIT_EOC(ADC1);
  LL_ADC_DisableIT_EOS(ADC1);

  /**Configure Regular Channel
  */
  LL_ADC_REG_SetSequencerRanks(ADC1, LL_ADC_REG_RANK_1, LL_ADC_CHANNEL_1);
  LL_ADC_SetChannelSamplingTime(ADC1, LL_ADC_CHANNEL_1, LL_ADC_SAMPLINGTIME_92CYCLES_5);
  LL_ADC_SetChannelSingleDiff(ADC1, LL_ADC_CHANNEL_1, LL_ADC_SINGLE_ENDED);

  /**Configure Regular Channel
  */
  LL_ADC_REG_SetSequencerRanks(ADC1, LL_ADC_REG_RANK_2, LL_ADC_CHANNEL_2);
  LL_ADC_SetChannelSamplingTime(ADC1, LL_ADC_CHANNEL_2, LL_ADC_SAMPLINGTIME_92CYCLES_5);
  LL_ADC_SetChannelSingleDiff(ADC1, LL_ADC_CHANNEL_2, LL_ADC_SINGLE_ENDED);

  /**Configure Regular Channel
  */
  LL_ADC_REG_SetSequencerRanks(ADC1, LL_ADC_REG_RANK_3, LL_ADC_CHANNEL_3);
  LL_ADC_SetChannelSamplingTime(ADC1, LL_ADC_CHANNEL_3, LL_ADC_SAMPLINGTIME_92CYCLES_5);
  LL_ADC_SetChannelSingleDiff(ADC1, LL_ADC_CHANNEL_3, LL_ADC_SINGLE_ENDED);

  /**Configure Regular Channel
  */
  LL_ADC_REG_SetSequencerRanks(ADC1, LL_ADC_REG_RANK_4, LL_ADC_CHANNEL_4);
  LL_ADC_SetChannelSamplingTime(ADC1, LL_ADC_CHANNEL_4, LL_ADC_SAMPLINGTIME_92CYCLES_5);
  LL_ADC_SetChannelSingleDiff(ADC1, LL_ADC_CHANNEL_4, LL_ADC_SINGLE_ENDED);
}

/* USART1 init function */
static void MX_USART1_UART_Init(void)
{

  LL_USART_InitTypeDef USART_InitStruct;
  LL_GPIO_InitTypeDef GPIO_InitStruct;

  /* Peripheral clock enable */
  LL_APB2_GRP1_EnableClock(LL_APB2_GRP1_PERIPH_USART1);

  /**USART1 GPIO Configuration
  PA9   ------> USART1_TX
  PA10   ------> USART1_RX
  */
  GPIO_InitStruct.Pin = LL_GPIO_PIN_9|LL_GPIO_PIN_10;
  GPIO_InitStruct.Mode = LL_GPIO_MODE_ALTERNATE;
  GPIO_InitStruct.Speed = LL_GPIO_SPEED_FREQ_HIGH;
  GPIO_InitStruct.OutputType = LL_GPIO_OUTPUT_PUSHPULL;
  GPIO_InitStruct.Pull = LL_GPIO_PULL_UP;
  GPIO_InitStruct.Alternate = LL_GPIO_AF_7;
  LL_GPIO_Init(GPIOA, &GPIO_InitStruct);

  USART_InitStruct.BaudRate = 115200;
  USART_InitStruct.DataWidth = LL_USART_DATAWIDTH_9B;
  USART_InitStruct.StopBits = LL_USART_STOPBITS_1;
  USART_InitStruct.Parity = LL_USART_PARITY_ODD;
  USART_InitStruct.TransferDirection = LL_USART_DIRECTION_TX_RX;
  USART_InitStruct.HardwareFlowControl = LL_USART_HWCONTROL_NONE;
  USART_InitStruct.OverSampling = LL_USART_OVERSAMPLING_16;
  LL_USART_Init(USART1, &USART_InitStruct);
  LL_USART_ConfigAsyncMode(USART1);
  LL_USART_Enable(USART1);

  /* USER CODE BEGIN 5 */
  LL_USART_EnableIT_RXNE(USART1);
  LL_USART_EnableIT_TXE(USART1);
  /* USER CODE END 5 */

}

/** Configure pins as
        * Analog
        * Input
        * Output
        * EVENT_OUT
        * EXTI
*/
static void MX_GPIO_Init(void)
{

  LL_GPIO_InitTypeDef GPIO_InitStruct;

  /* GPIO Ports Clock Enable */
  LL_AHB2_GRP1_EnableClock(LL_AHB2_GRP1_PERIPH_GPIOC);
  LL_AHB2_GRP1_EnableClock(LL_AHB2_GRP1_PERIPH_GPIOA);
  LL_AHB2_GRP1_EnableClock(LL_AHB2_GRP1_PERIPH_GPIOB);

  /**/
  LL_GPIO_ResetOutputPin(LED_PORT, LED3_PIN|LED4_PIN|LED10_PIN|LED11_PIN
                          |LED5_PIN|LED6_PIN|LED7_PIN|LED8_PIN
                          |LED9_PIN|LED0_PIN|LED1_PIN|LED2_PIN);

  /**/
  LL_GPIO_ResetOutputPin(ADDR_DATA_PORT, D2_PIN|D3_PIN|ENABLE_PIN|D0_PIN
                          |D1_PIN);

  /**/
  LL_GPIO_SetOutputPin(ADDR_DATA_PORT, IOW_PIN|IOR_PIN|A0_PIN|A1_PIN
                          |A2_PIN);

  /**/
  GPIO_InitStruct.Pin = CLAW_RELEASE_BUT_PIN|CLAW_UP_BUT_PIN|CLAW_DOWN_BUT_PIN|CLAW_GRAB_BUT_PIN;
  GPIO_InitStruct.Mode = LL_GPIO_MODE_INPUT;
  GPIO_InitStruct.Pull = LL_GPIO_PULL_NO;
  LL_GPIO_Init(INPUT_PORT, &GPIO_InitStruct);

  /**/
  GPIO_InitStruct.Pin = STEP_SIZE_PIN|STEP_TIME_PIN|JOYSTICK_CONNECTED_PIN|MANUAL_MODE_PIN
                          |AUTO_MODE_PIN;
  GPIO_InitStruct.Mode = LL_GPIO_MODE_INPUT;
  GPIO_InitStruct.Pull = LL_GPIO_PULL_DOWN;
  LL_GPIO_Init(INPUT_PORT, &GPIO_InitStruct);

  /**/
  GPIO_InitStruct.Pin = LED3_PIN|LED4_PIN|LED10_PIN|LED11_PIN
                          |LED5_PIN|LED6_PIN|LED7_PIN|LED8_PIN
                          |LED9_PIN;//|LED0_PIN|LED1_PIN|LED2_PIN;	//pins LED0-1 are used by the debugger
  GPIO_InitStruct.Mode = LL_GPIO_MODE_OUTPUT;
  GPIO_InitStruct.Speed = LL_GPIO_SPEED_FREQ_LOW;
  GPIO_InitStruct.OutputType = LL_GPIO_OUTPUT_PUSHPULL;
  GPIO_InitStruct.Pull = LL_GPIO_PULL_NO;
  LL_GPIO_Init(LED_PORT, &GPIO_InitStruct);

  /**/
  GPIO_InitStruct.Pin = IOW_PIN|IOR_PIN|D2_PIN|D3_PIN
                          |A0_PIN|A1_PIN|A2_PIN|ENABLE_PIN
                          |D0_PIN|D1_PIN;
  GPIO_InitStruct.Mode = LL_GPIO_MODE_OUTPUT;
  GPIO_InitStruct.Speed = LL_GPIO_SPEED_FREQ_LOW;
  GPIO_InitStruct.OutputType = LL_GPIO_OUTPUT_PUSHPULL;
  GPIO_InitStruct.Pull = LL_GPIO_PULL_NO;
  LL_GPIO_Init(ADDR_DATA_PORT, &GPIO_InitStruct);

  /**/
  GPIO_InitStruct.Pin = D4_PIN|D5_PIN|D6_PIN|D7_PIN;
  GPIO_InitStruct.Mode = LL_GPIO_MODE_INPUT;
  GPIO_InitStruct.Pull = LL_GPIO_PULL_NO;
  LL_GPIO_Init(ADDR_DATA_PORT, &GPIO_InitStruct);

  /* Configure IO in output push-pull mode to drive external LED2 */
  /*
  GPIO_InitStruct.Pin        = TEST_LED_PIN;
  GPIO_InitStruct.Mode       = LL_GPIO_MODE_OUTPUT;
  GPIO_InitStruct.Speed      = LL_GPIO_SPEED_FREQ_LOW;
  GPIO_InitStruct.OutputType = LL_GPIO_OUTPUT_PUSHPULL;
  GPIO_InitStruct.Pull       = LL_GPIO_PULL_NO;
  LL_GPIO_Init(LED_PORT, &GPIO_InitStruct);
  */
}

/**
  * @brief  This function configures the DMA1 Channel 1 to copy data from
  *         Flash memory(aSRC_Const_Buffer) to Internal SRAM(aDST_Buffer).
  * @note   This function is used to :
  *         -1- Enable DMA1 clock
  *         -2- Configure the DMA functionnal parameters
  *         -3- Configure NVIC for DMA transfer complete/error interrupts
  * @param   None
  * @retval  None
  */
void Configure_DMA(void)
{
  LL_DMA_InitTypeDef dma_initstruct;
  extern uint32_t adc_pot_vals;

  /* (1) Enable the clock of DMA1 */
  LL_AHB1_GRP1_EnableClock(LL_AHB1_GRP1_PERIPH_DMA1);

  /* (2) Configure the DMA functional parameters */

  /* Reset DMA1 data registers */
  LL_DMA_DeInit(DMA1, LL_DMA_CHANNEL_1);

  /* Set fields of initialization structure:
   *  - Source base address:        aSRC_Const_Buffer
   *  - Destination base address:   aDST_Buffer
   *  - Transfer direction :        Memory to memory
   *  - Source increment mode:      Increment mode Enable
   *  - Destination increment mode: Increment mode Enable
   *  - Source data alignment:      Word alignment
   *  - Destination data alignment: Word alignment
   *  - Number of data to transfer: BUFFER_SIZE
   *  - DMA peripheral request:     No request
   *  - Transfer priority level:    High priority
  */
  dma_initstruct.PeriphOrM2MSrcAddress  = LL_ADC_DMA_GetRegAddr(ADC1, LL_ADC_DMA_REG_REGULAR_DATA);
  dma_initstruct.MemoryOrM2MDstAddress  = (uint32_t) &adc_pot_vals;
  dma_initstruct.Direction              = LL_DMA_DIRECTION_PERIPH_TO_MEMORY;
  dma_initstruct.Mode                   = LL_DMA_MODE_CIRCULAR;
  dma_initstruct.PeriphOrM2MSrcIncMode  = LL_DMA_PERIPH_NOINCREMENT;
  dma_initstruct.MemoryOrM2MDstIncMode  = LL_DMA_MEMORY_INCREMENT;
  dma_initstruct.PeriphOrM2MSrcDataSize = LL_DMA_PDATAALIGN_HALFWORD;
  dma_initstruct.MemoryOrM2MDstDataSize = LL_DMA_MDATAALIGN_HALFWORD;
  dma_initstruct.NbData                 = 4;
  dma_initstruct.PeriphRequest          = LL_DMA_REQUEST_0;
  dma_initstruct.Priority               = LL_DMA_PRIORITY_MEDIUM;

  /* Initialize DMA instance according to parameters defined in initialization structure. */
  LL_DMA_Init(DMA1, LL_DMA_CHANNEL_1, &dma_initstruct);

  /* (3) Configure NVIC for DMA transfer complete/error interrupts */
  //LL_DMA_EnableIT_TC(DMA1, LL_DMA_CHANNEL_1);
  //LL_DMA_EnableIT_TE(DMA1, LL_DMA_CHANNEL_1);
  /* USER CODE BEGIN 5 */
  //Enable DMA channel for ADC
  LL_DMA_EnableChannel(DMA1, LL_DMA_CHANNEL_1);
  /* USER CODE END 5 */
}

/**
  * @brief  Perform ADC activation procedure to make it ready to convert
  *         (ADC instance: ADC1).
  * @note   Operations:
  *         - ADC instance
  *           - Disable deep power down
  *           - Enable internal voltage regulator
  *           - Run ADC self calibration
  *           - Enable ADC
  *         - ADC group regular
  *           none: ADC conversion start-stop to be performed
  *                 after this function
  *         - ADC group injected
  *           none: ADC conversion start-stop to be performed
  *                 after this function
  * @param  None
  * @retval None
  */
static void Activate_ADC(void)
{
  __IO uint32_t wait_loop_index = 0;
  #if (USE_TIMEOUT == 1)
  uint32_t Timeout = 0; /* Variable used for timeout management */
  #endif /* USE_TIMEOUT */

  /*## Operation on ADC hierarchical scope: ADC instance #####################*/

  /* Note: Hardware constraint (refer to description of the functions         */
  /*       below):                                                            */
  /*       On this STM32 serie, setting of these features is conditioned to   */
  /*       ADC state:                                                         */
  /*       ADC must be disabled.                                              */
  /* Note: In this example, all these checks are not necessary but are        */
  /*       implemented anyway to show the best practice usages                */
  /*       corresponding to reference manual procedure.                       */
  /*       Software can be optimized by removing some of these checks, if     */
  /*       they are not relevant considering previous settings and actions    */
  /*       in user application.                                               */
  if (LL_ADC_IsEnabled(ADC1) == 0)
  {
    /* Disable ADC deep power down (enabled by default after reset state) */
    LL_ADC_DisableDeepPowerDown(ADC1);

    /* Enable ADC internal voltage regulator */
    LL_ADC_EnableInternalRegulator(ADC1);

    /* Delay for ADC internal voltage regulator stabilization.                */
    /* Compute number of CPU cycles to wait for, from delay in us.            */
    /* Note: Variable divided by 2 to compensate partially                    */
    /*       CPU processing cycles (depends on compilation optimization).     */
    /* Note: If system core clock frequency is below 200kHz, wait time        */
    /*       is only a few CPU processing cycles.                             */
    wait_loop_index = ((LL_ADC_DELAY_INTERNAL_REGUL_STAB_US * (SystemCoreClock / (100000 * 2))) / 10);
    while(wait_loop_index != 0)
    {
      wait_loop_index--;
    }

    /* Run ADC self calibration */
    LL_ADC_StartCalibration(ADC1, LL_ADC_SINGLE_ENDED);

    /* Poll for ADC effectively calibrated */
    #if (USE_TIMEOUT == 1)
    Timeout = ADC_CALIBRATION_TIMEOUT_MS;
    #endif /* USE_TIMEOUT */

    while (LL_ADC_IsCalibrationOnGoing(ADC1) != 0)
    {
    #if (USE_TIMEOUT == 1)
      /* Check Systick counter flag to decrement the time-out value */
      if (LL_SYSTICK_IsActiveCounterFlag())
      {
        if(Timeout-- == 0)
        {
        /* Time-out occurred. Set LED to blinking mode */
        LED_Blinking(LED_BLINK_ERROR);
        }
      }
    #endif /* USE_TIMEOUT */
    }

    /* Delay between ADC end of calibration and ADC enable.                   */
    /* Note: Variable divided by 2 to compensate partially                    */
    /*       CPU processing cycles (depends on compilation optimization).     */
    wait_loop_index = (ADC_DELAY_CALIB_ENABLE_CPU_CYCLES >> 1);
    while(wait_loop_index != 0)
    {
      wait_loop_index--;
    }

    /* Enable ADC */
    LL_ADC_Enable(ADC1);

    /* Poll for ADC ready to convert */
    #if (USE_TIMEOUT == 1)
    Timeout = ADC_ENABLE_TIMEOUT_MS;
    #endif /* USE_TIMEOUT */

    while (LL_ADC_IsActiveFlag_ADRDY(ADC1) == 0)
    {
    #if (USE_TIMEOUT == 1)
      /* Check Systick counter flag to decrement the time-out value */
      if (LL_SYSTICK_IsActiveCounterFlag())
      {
        if(Timeout-- == 0)
        {
        /* Time-out occurred. Set LED to blinking mode */
        LED_Blinking(LED_BLINK_ERROR);
        }
      }
    #endif /* USE_TIMEOUT */
    }

    /* Note: ADC flag ADRDY is not cleared here to be able to check ADC       */
    /*       status afterwards.                                               */
    /*       This flag should be cleared at ADC Deactivation, before a new    */
    /*       ADC activation, using function "LL_ADC_ClearFlag_ADRDY()".       */
  }

  /*## Operation on ADC hierarchical scope: ADC group regular ################*/
  /* Note: No operation on ADC group regular performed here.                  */
  /*       ADC group regular conversions to be performed after this function  */
  /*       using function:                                                    */
  /*       "LL_ADC_REG_StartConversion();"                                    */

  /*## Operation on ADC hierarchical scope: ADC group injected ###############*/
  /* Note: No operation on ADC group injected performed here.                 */
  /*       ADC group injected conversions to be performed after this function */
  /*       using function:                                                    */
  /*       "LL_ADC_INJ_StartConversion();"                                    */

}

/**
  * @brief  This function is executed in case of error occurrence.
  * @param  None
  * @retval None
  */
void _Error_Handler(char * file, int line)
{
  /* USER CODE BEGIN Error_Handler_Debug */
  /* User can add his own implementation to report the HAL error return state */
  while(1)
  {
  }
  /* USER CODE END Error_Handler_Debug */
}

#ifdef USE_FULL_ASSERT

/**
   * @brief Reports the name of the source file and the source line number
   * where the assert_param error has occurred.
   * @param file: pointer to the source file name
   * @param line: assert_param error line source number
   * @retval None
   */
void assert_failed(uint8_t* file, uint32_t line)
{
  /* USER CODE BEGIN 6 */
  /* User can add his own implementation to report the file name and line number,
    ex: printf("Wrong parameters value: file %s on line %d\r\n", file, line) */
  /* USER CODE END 6 */

}

#endif

/************************ (C) COPYRIGHT STMicroelectronics *****END OF FILE****/
