VladimirGaristov/ROBKO_01-STM32/MCU_Firmware/inc/main.h

#define USE_TIMEOUT 0
#define ADC_DELAY_CALIB_ENABLE_CPU_CYCLES  (LL_ADC_DELAY_CALIB_ENABLE_ADC_CYCLES * 32)
#define CLAW_RELEASE_BUT_PIN LL_GPIO_PIN_13
#define CLAW_GRAB_BUT_PIN LL_GPIO_PIN_12
#define LEFT_RIGHT_POT_PIN LL_GPIO_PIN_1
#define SHOULDER_POT_PIN LL_GPIO_PIN_0
#define ELBOW_POT_PIN LL_GPIO_PIN_3
#define CLAW_ROTATION_POT_PIN LL_GPIO_PIN_2
#define CLAW_UP_BUT_PIN LL_GPIO_PIN_10
#define CLAW_DOWN_BUT_PIN LL_GPIO_PIN_11
#define AUTO_MODE_PIN LL_GPIO_PIN_9
#define MANUAL_MODE_PIN LL_GPIO_PIN_8
#define JOYSTICK_CONNECTED_PIN LL_GPIO_PIN_7
#define STEP_SIZE_PIN LL_GPIO_PIN_14		//Conflicts with LSE oscillator, solder SB49 and remove R34 on Nucleo board to use
#define STEP_SIZE_PIN LL_GPIO_PIN_5
#define STEP_TIME_PIN LL_GPIO_PIN_4
#define IOW_PIN LL_GPIO_PIN_1
#define IOR_PIN LL_GPIO_PIN_2
#define D0_PIN LL_GPIO_PIN_9
#define D1_PIN LL_GPIO_PIN_8
#define D2_PIN LL_GPIO_PIN_11
#define D3_PIN LL_GPIO_PIN_10
#define D4_PIN LL_GPIO_PIN_12
#define D5_PIN LL_GPIO_PIN_13
#define D6_PIN LL_GPIO_PIN_14
#define D7_PIN LL_GPIO_PIN_15
#define A0_PIN LL_GPIO_PIN_3		//Conflicts with debugger, but still works if asynchronous trace is not used (default)
#define A0_PIN LL_GPIO_PIN_7
#define A1_PIN LL_GPIO_PIN_4
#define A2_PIN LL_GPIO_PIN_5
#define ENABLE_PIN LL_GPIO_PIN_6
#define TEST_LED_PIN LL_GPIO_PIN_5
#define LED0_PIN LL_GPIO_PIN_13		//Conflicts with debugger
#define LED1_PIN LL_GPIO_PIN_14		//Conflicts with debugger
#define LED0_PIN LL_GPIO_PIN_11
#define LED1_PIN LL_GPIO_PIN_12
#define LED2_PIN LL_GPIO_PIN_15
#define LED3_PIN LL_GPIO_PIN_0
#define LED4_PIN LL_GPIO_PIN_1
#define LED5_PIN LL_GPIO_PIN_4
#define LED6_PIN LL_GPIO_PIN_5		//Connected to LED on Nucleo board. Desolder SB21 to prevent over-current
#define LED7_PIN LL_GPIO_PIN_6
#define LED8_PIN LL_GPIO_PIN_7
#define LED9_PIN LL_GPIO_PIN_8
#define LED10_PIN LL_GPIO_PIN_2		//Conflicts with ST-LINK virtual COM port
#define LED11_PIN LL_GPIO_PIN_3		//Conflicts with ST-LINK virtual COM port
#define NVIC_PRIORITYGROUP_0         ((uint32_t)0x00000007) /*!< 0 bit  for pre-emption priority,
#define NVIC_PRIORITYGROUP_1         ((uint32_t)0x00000006) /*!< 1 bit  for pre-emption priority,
#define NVIC_PRIORITYGROUP_2         ((uint32_t)0x00000005) /*!< 2 bits for pre-emption priority,
#define NVIC_PRIORITYGROUP_3         ((uint32_t)0x00000004) /*!< 3 bits for pre-emption priority,
#define NVIC_PRIORITYGROUP_4         ((uint32_t)0x00000003) /*!< 4 bits for pre-emption priority,
#define ADDR_DATA_PORT GPIOB
#define INPUT_PORT GPIOC
#define LED_PORT GPIOA
#define LEFT_THR		0x09CBU	//2.02V
#define RIGHT_THR		0x057BU	//1.13V
#define UP_THR			0x08F8U	//1.85V
#define DOWN_THR		0x0746U	//1.5V
#define LKG_CORRECTION	0x003EU	//0.05V	Subtract from threshold
#define POT_INIT_VAL	0x0800U
#define SERIAL_BUFFER_LEN 100
#define MAX_CMD_LEN 13
#define MAX_REPLY_LEN 13
#define FULL_STEP 2
#define HALF_STEP 1
#define USE_LOCAL_STEP 0
#define USE_LOCAL_TIME 0
#define MAX_STEP_SPEED 5
#define FAST_STEP 7
#define SLOW_STEP 15
#define STEP_FWD 1
#define STEP_REV -1
#define MOVE_UNTIL_DETECTION 1
#define MOVE_UNTIL_NO_DETECTION 2
#define MOVE_FREELY 0
#define ROTATION_MOTOR 0	//FWD=left
#define SHOULDER_MOTOR 1	//FWD=forward
#define ELBOW_MOTOR 2		//FWD=up
#define CLAW_GRAB_MOTOR 5	//FWD=open
#define CLAW_ROT_MOTOR_L 4	//FWD=up
#define CLAW_ROT_MOTOR_R 3	//FWD=down
#define ALL_MOTORS 6
#define LEFT_RIGHT_POT_NUM 1
#define SHOULDER_POT_NUM 0
#define ELBOW_POT_NUM 3
#define CLAW_ROTATION_POT_NUM 2
#define MOV 1
#define MOVE 2
#define OFF 3
#define OPEN_FILE 4
#define GOTO_POS 5
#define GET_POS 6
#define KILL 7
#define CLEAR 8
#define FREEZE 9
#define RESUME 10
#define SAVE_POS 11
#define OPTO 12
#define SET_STEP 13
#define SET_SPEED 14
#define GET_STEP 15
#define GET_SPEED 16
#define SET_HOME 17
#define GET_POS_REPLY 18
#define SAVE_POS_REPLY 199
#define STEP_REPLY 20
#define SPEED_REPLY 21
#define ACK 22
#define ERROR_REPLY 23
#define LAST_CMD 24
#define REPEAT 25
#define FULL_RAM 101
#define UNKNOWN_CMD 102
#define HEAP_BASE &_ebss
#define STACK_BASE &_estack
#define HEAP_SIZE (HEAP_LIMIT - (uint32_t) HEAP_BASE)
#define STACK_SIZE 0x8000	// 32KB
#define HEAP_LIMIT ((uint32_t) STACK_BASE - STACK_SIZE)
