VladimirGaristov/ROBKO_01-STM32/(commit log)

2017-10-21 Initial commit and test functions for GPIO and UART.
    [ROBKO_01 Run.cfg]
2017-11-06 Motor test
2017-11-25 Replaced GPIO_Init() with newer version which includes LEDs and DIP switches
    [main.c, main.h, motor_control.c, test_functions.c]
2017-12-20 Added CAD schematics
    -ROBKO 01 internal board schematic
    -adapter board between ROBKO 01 and STM32 Nucleo boards: schematics, layout and gerber files
    -ROBKO 01 manual
    [ROBKO_01.pdsprj]
2017-12-27 Added LED indication code and comments
2017-12-27 Remote control now works smoothly. Added makefiles and text command parsing; bugfixes.
    [motor_control.c, robko_client.c, robko_server.c]
2018-01-31 Промених UART: 1 вместо 2 стоп бита
2018-01-31 Размених вертикалните потенциометри с хоризонталните
2018-02-05 Оправих разменените D0-D3
2018-02-06 Нови команди: MOV, OPTO, SET_SPEED и SET_STEP
2018-02-06 Добавих изпълнение на файл
2018-02-08 Multy-motor command MOVE now works
2018-03-17 нз, вече не помня, отдавна не съм работил по проекта
2018-03-24 bugfixes for OPTO command and step size
    [main.c, main.h, motor_control.c]
2018-03-24 fix for a bug introduced with previous bugfix
    [motor_control.c]
2018-04-11 better folder structure
    [ROBKO_01 Run.cfg]
2018-04-11 Added hardware schematics and layout
    [ROBKO_01 Run.cfg, ROBKO_01.pdsprj]
2018-04-24 added wireshark capture file
2018-04-24 added wireshark section to the thesis
2019-02-16 Deleted a file that causes cloning issues
    The file "Getting started with STM32 Nucleo board software development tools" somehow ended up with a line-feed character in its name. This causes an error when cloning to a windows machine.
2019-02-22 Started work on reply parsing, ERROR and LAST_CMD not done yet
    [main.h, motor_control.c, robko_decode.h, robko_server.c]
2019-05-29 MOVE command now spreads the steps and all motors finish moving almost together
2019-09-21 Added UNKNOWN_CMD error code.
    [robko_decode.h, robko_server.c]
2019-10-03 UART communication now works in both directions
    [ROBKO_01 Run.cfg]
2019-10-05 Fixed bugs in max_steps_current_cmd() and heap_overflow() and the execution of MOVE.
    [main.h, motor_control.c, robko_server.c]
2019-10-08 Fixed issues with printing information by the client.
    [robko_client.c, robko_server.c]
2019-10-09 Replies from the MCU and repeating files are now handled by a separate thread on the server.
2019-10-09 Fixed SET_HOME and SAVE_POS being reported as unknown commands
    [motor_control.c]
2019-10-10 GOTO_POS now works as intended but SAVE_POS is still broken
    [robko_decode.c, robko_server.c]
2019-11-03 Hardware revision to reduce pin conflicts
    [ROBKO_01.pdsprj]
2019-11-05 Added the new pin declarations to the MCU firmware
2019-11-27 Fixed button footprint and added some annotations.
    [ROBKO_01.pdsprj]
